alanmimms/nexrig/sim-stuff/filtersim/ChebyshevLP-30MHz-0.5dB-50ohms.ods

Sheet: 0.5dB-ripple
Chebyshev LP 30MHz 50ohm 0.5dB equiripple Pi
RefDes | Precise | Standard
C1 | 185.7 | 180 | pF
C2 | 283.1 | 270 | pF
C3 | 289 | 300 | pF
L1 | 336.6 | 330 | nH
L2 | 362.7 | 360 | nH
SHOPPING CART
This is not an invoice
17-May-25 18:13:14
 | Mouser # | Mfr. # | Manufacturer | Customer # | Description | RoHS | Lifecycle | Order Qty. | Price (USD) | Ext.: (USD)
1 | 81-LQW2UASR33F00L | LQW2UASR33F00L | Murata |  | RF Inductors - SMD 330 NH 1% | RoHS Compliant |  | 10 | $0.309 | $3.09
2 | 791-WLCW2520Z0GR36PB | WLCW2520Z0GR36PB | Walsin |  | RF Inductors - SMD Chip Wire Ind 2520(1008) 360nH +/-2% | RoHS Compliant |  | 10 | $0.134 | $1.34
3 | 581-12061A181FAT2A | 12061A181FAT2A | KYOCERA AVX |  | Multilayer Ceramic Capacitors MLCC - SMD/SMT KGM31BCG2A181FT NEW GLOBAL PN 100V 180pF A 581-KGM31BCG2A181FT | RoHS Compliant |  | 10 | $0.362 | $3.62
4 | 581-12061A271FAT2A | 12061A271FAT2A | KYOCERA AVX |  | Multilayer Ceramic Capacitors MLCC - SMD/SMT KGM31BCG2A271FT NEW GLOBAL PN 100V 270pF A 581-KGM31BCG2A271FT | RoHS Compliant |  | 10 | $0.522 | $5.22
5 | 581-12065A301FAT2A | 12065A301FAT2A | KYOCERA AVX |  | Multilayer Ceramic Capacitors MLCC - SMD/SMT 50V 300pF C0G 1206 1 % | RoHS Compliant |  | 10 | $0.734 | $7.34
By submitting your order you agree to these terms and conditions. (https://www.mouser.com/saleterms) |  |  |  |  |  |  |  |  | Merchandise: | $20.61
Prices are reflected at the date and time shown. |  |  |  |  |  |  |  |  | Shipping Charge: | $7.99

Sheet: 0.1dB-ripple
Chebyshev LP 30MHz 50ohm 0.1dB equiripple Pi
RefDes | Precise | Standard
C1 | 185.7 | 180 | pF
C2 | 283.1 | 270 | pF
C3 | 289 | 300 | pF
L1 | 336.6 | 330 | nH
L2 | 362.7 | 360 | nH
