alanmimms/nexrig/hw/NexRig.kicad_pcb

## KiCad design hw/NexRig.kicad_pcb (2025-12-29)

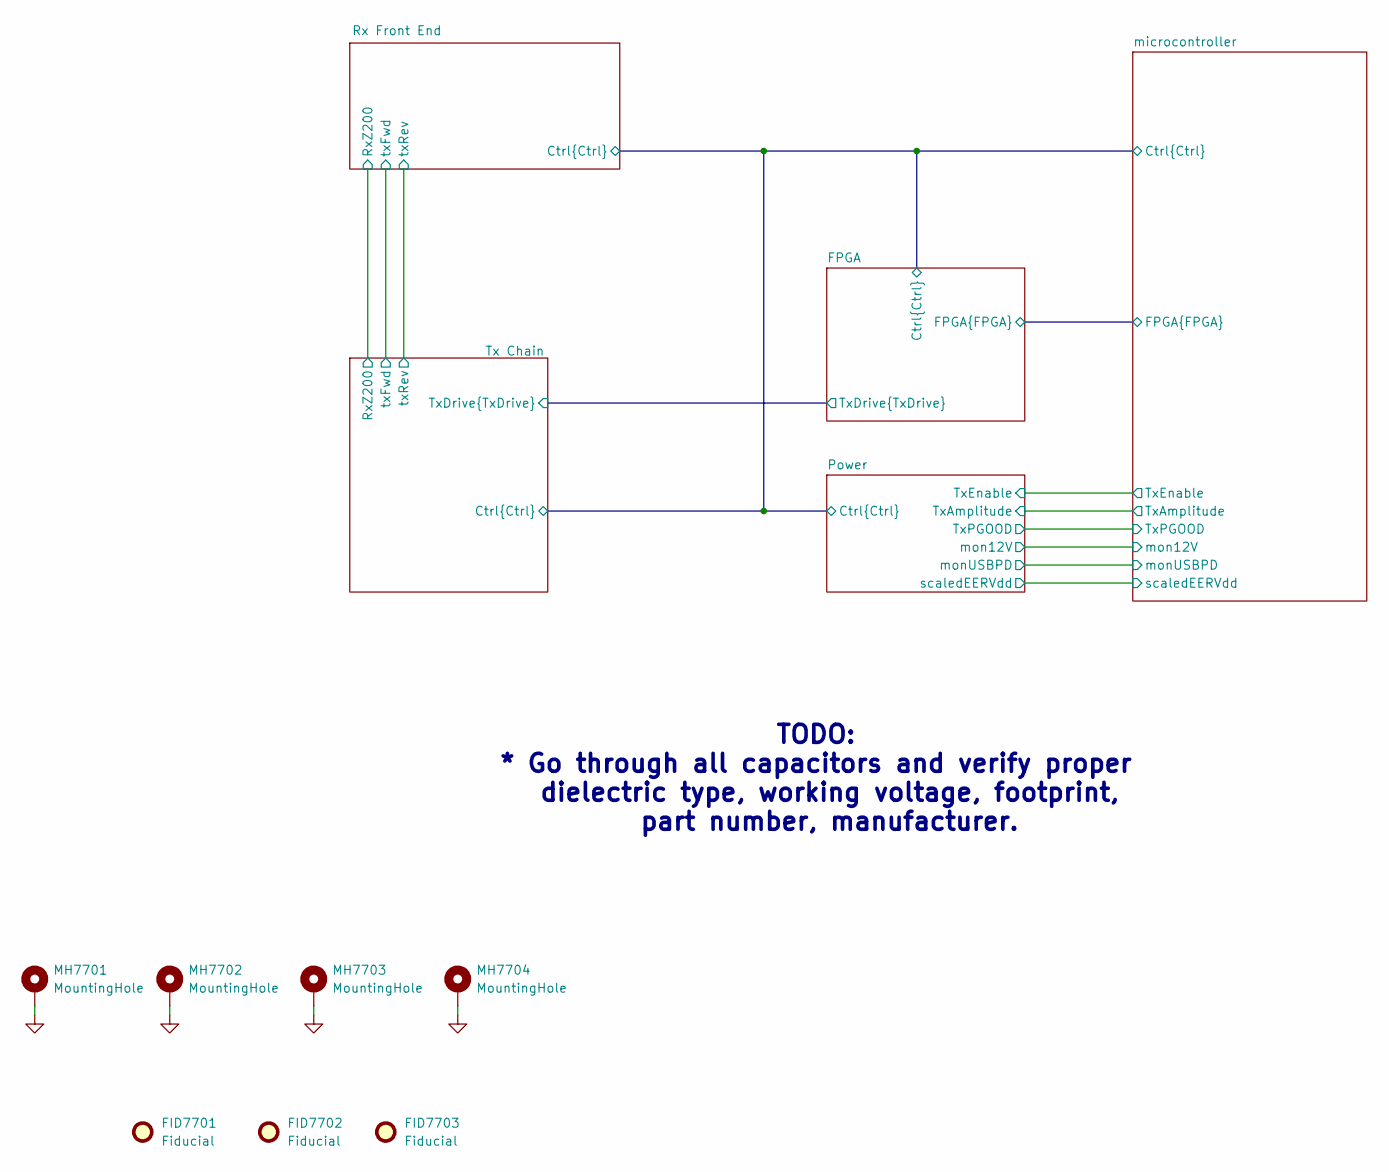
[picture p1: schematic NexRig.kicad_sch]

Parts:
FID7701, FID7702, FID7703: Fiducial; Fiducial_0.5mm_Mask2mm
MH7701, MH7702, MH7703, MH7704: MountingHole; MountingHole_3.2mm_M3_ISO7380_Pad

Notes on the sheet:
TODO: * Go through all capacitors and verify proper dielectric type, working voltage, footprint, part number, manufacturer.

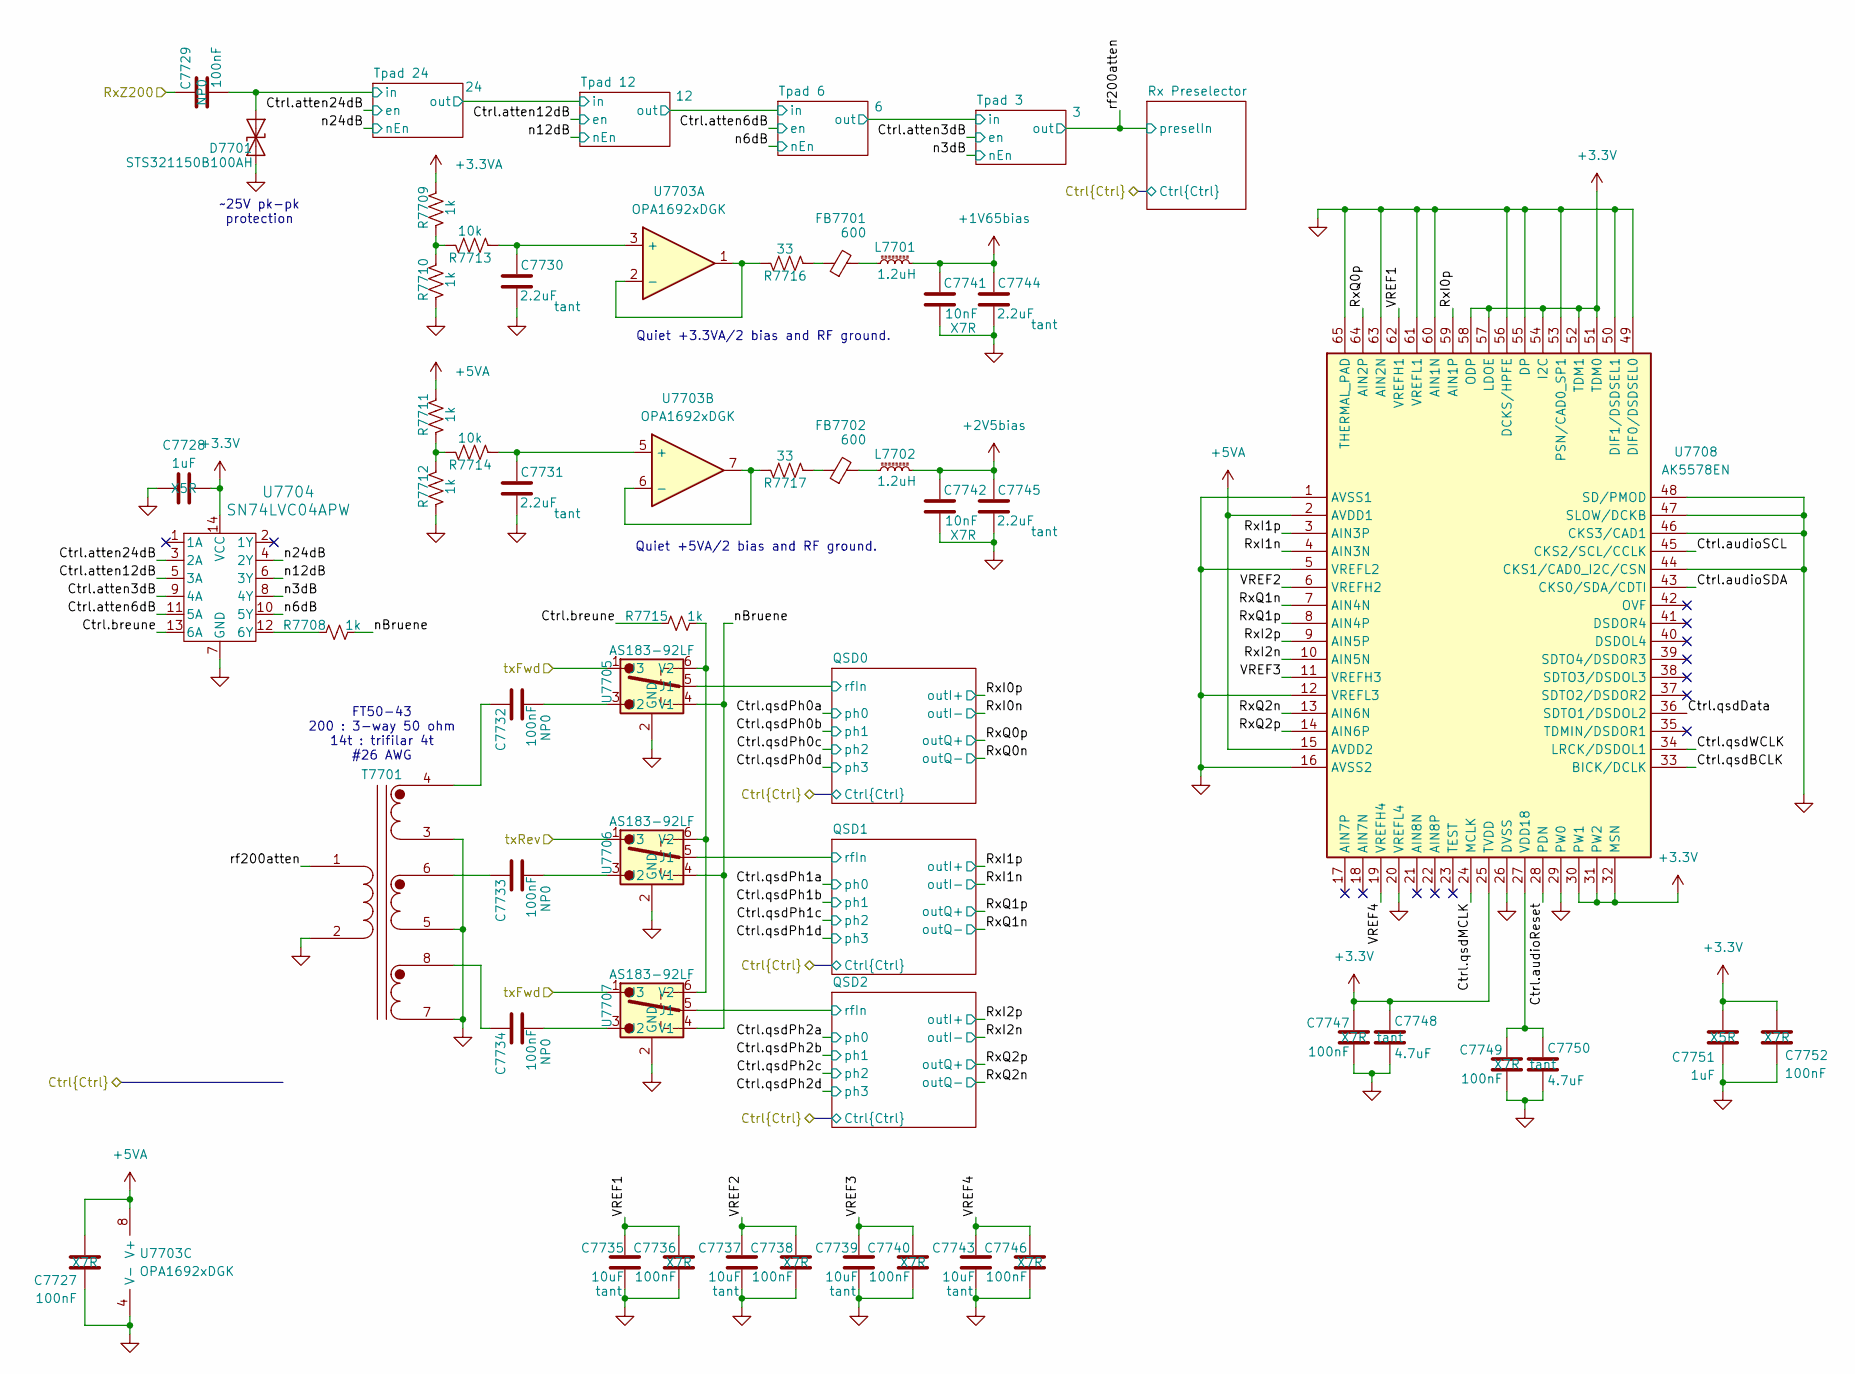
[picture p2: schematic rx-signal-chain.kicad_sch, Rx Front End]

Parts:
C7727, C7736, C7738, C7740, C7746, C7747, C7749, C7752: 100nF; C_0603_1608Metric; Manufacturer_Part_Number C0805F104K1RACAUTO; Mouser Part Number 80-C0805F104K1RAUTO
C7728, C7751: 1uF; C_0402_1005Metric; Manufacturer_Part_Number GRM155R61E105KE11D; Mouser Part Number 81-GRM155R61E105KE1D
C7729, C7732, C7733, C7734: 100nF; C_1206_3216Metric; Manufacturer_Part_Number GRM31C5C2A104JA01L; Mouser Part Number 81-GRM31C5C2A104JA1L
C7730, C7731, C7744, C7745: 2.2uF; C_0805_2012Metric; MfgPart T55B225M050C0200; Mouser Part Number 74-TMCP1D225MTR2F
C7735, C7737, C7739, C7743: 10uF; C_0805_2012Metric; MfgPart TMCP0J106KTR2F; Mouser Part Number 581-TAJD106K050R
C7741, C7742: 10nF; C_0603_1608Metric; Part Number GCM1885C2A103JE02J; Mouser Part Number 81-GCM1885C2A103JE2J
C7748, C7750: 4.7uF; C_0805_2012Metric; Manufacturer_Part_Number 298D475X9010M2T; Mouser Part Number 74-298D475X9010M2T
D7701: STS321150B100AH; Infineon_SG-WLL-2-3_0.58x0.28_P0.36mm
FB7701, FB7702: 600; L_0603_1608Metric; MfgPN BLM18AG601SN1D
L7701, L7702: 1.2uH; L_0805_2012Metric; Part Number CWF2012A-1R2K
R7708, R7715: 1k; R_0402_1005Metric
R7709, R7710, R7711, R7712: 1k; R_0603_1608Metric
R7713, R7714: 10k; R_0402_1005Metric
R7716, R7717: 33; R_0603_1608Metric
T7701: 12t primary : 6T #26 trifilar secondary FT37-43; Toroid-1pri-3sec-ft50
U7703: OPA1692xDGK; VSSOP-8_3x3mm_P0.65mm
U7704: SN74LVC04APW; PW14
U7705, U7706, U7707: AS183-92LF; SOT65P220X110-6N; Mouser Part Number 873-AS183-92LF
U7708: AK5578EN; QFN50P900X900X100-65N; Mouser Part Number 412-AK5578EN

Connections:
+1V65bias: C7741.1, C7744.1, L7701.2; also elsewhere on the board
+2V5bias: C7742.1, C7745.1, L7702.2; also elsewhere on the board
+3.3V: C7728.2, C7747.2, C7748.2, C7751.1, C7752.1, U7704.14 (VCC), U7708.25 (TVDD), U7708.30 (PW1), U7708.31 (PW2), U7708.32 (MSN), U7708.51 (TDM0), U7708.52 (TDM1), U7708.54 (I2C), U7708.57 (LDOE), U7708.58 (ODP); also elsewhere on the board
+3.3VA: R7709.2; also elsewhere on the board
+5VA: C7727.1, R7711.2, U7703.8 (V+), U7708.2 (AVDD1), U7708.15 (AVDD2); also elsewhere on the board
/FPGA/Ctrl.audioReset: U7708.28 (PDN); also elsewhere on the board
/FPGA/Ctrl.audioSCL: U7708.45 (CKS2/SCL/CCLK); also elsewhere on the board
/FPGA/Ctrl.audioSDA: U7708.43 (CKS0/SDA/CDTI); also elsewhere on the board
/FPGA/Ctrl.qsdBCLK: U7708.33 (BICK/DCLK); also elsewhere on the board
/FPGA/Ctrl.qsdData: U7708.36 (SDTO1/DSDOL2); also elsewhere on the board
/FPGA/Ctrl.qsdMCLK: U7708.24 (MCLK)
/FPGA/Ctrl.qsdWCLK: U7708.34 (LRCK/DSDOL1); also elsewhere on the board
/Rx Front End/Ctrl.atten3dB: U7704.9 (4A); also elsewhere on the board
/Rx Front End/Ctrl.atten6dB: U7704.11 (5A); also elsewhere on the board
/Rx Front End/Ctrl.atten12dB: U7704.5 (3A); also elsewhere on the board
/Rx Front End/Ctrl.atten24dB: U7704.3 (2A); also elsewhere on the board
/Rx Front End/Ctrl.breune: R7715.1, U7704.13 (6A)
/Rx Front End/QSD0/rfIn: U7705.5 (J1); also elsewhere on the board
/Rx Front End/QSD1/rfIn: U7706.5 (J1); also elsewhere on the board
/Rx Front End/QSD2/rfIn: U7707.5 (J1); also elsewhere on the board
/Rx Front End/RxI0p: U7708.59 (AIN1P); also elsewhere on the board
/Rx Front End/RxI1n: U7708.4 (AIN3N); also elsewhere on the board
/Rx Front End/RxI1p: U7708.3 (AIN3P); also elsewhere on the board
/Rx Front End/RxI2n: U7708.10 (AIN5N); also elsewhere on the board
/Rx Front End/RxI2p: U7708.9 (AIN5P); also elsewhere on the board
/Rx Front End/RxQ0p: U7708.64 (AIN2P); also elsewhere on the board
/Rx Front End/RxQ1n: U7708.7 (AIN4N); also elsewhere on the board
/Rx Front End/RxQ1p: U7708.8 (AIN4P); also elsewhere on the board
/Rx Front End/RxQ2n: U7708.13 (AIN6N); also elsewhere on the board
/Rx Front End/RxQ2p: U7708.14 (AIN6P); also elsewhere on the board
/Rx Front End/RxZ200: C7729.1; also elsewhere on the board
/Rx Front End/Tpad 24/in: C7729.2, D7701.1 (A1); also elsewhere on the board
/Rx Front End/VREF1: C7735.1, C7736.1, U7708.62 (VREFH1)
/Rx Front End/VREF2: C7737.1, C7738.1, U7708.6 (VREFH2)
/Rx Front End/VREF3: C7739.1, C7740.1, U7708.11 (VREFH3)
/Rx Front End/VREF4: C7743.1, C7746.1, U7708.19 (VREFH4)
/Rx Front End/n3dB: U7704.8 (4Y); also elsewhere on the board
/Rx Front End/n6dB: U7704.10 (5Y); also elsewhere on the board
/Rx Front End/n12dB: U7704.6 (3Y); also elsewhere on the board
/Rx Front End/n24dB: U7704.4 (2Y); also elsewhere on the board
/Rx Front End/nBruene: R7708.2, U7705.4 (V1), U7706.4 (V1), U7707.4 (V1)
/Rx Front End/rf200atten: T7701.1 (IN+); also elsewhere on the board
/Rx Front End/txFwd: U7705.1 (J3), U7707.1 (J3); also elsewhere on the board
/Rx Front End/txRev: U7706.1 (J3); also elsewhere on the board
unnamed: C7733.1, T7701.6 (OUT2A)
unnamed: C7734.1, T7701.8 (OUT2A)
unnamed: FB7701.1, R7716.1
unnamed: FB7701.2, L7701.1
unnamed: FB7702.1, R7717.1
unnamed: FB7702.2, L7702.1
unnamed: R7709.1, R7710.2, R7713.2
unnamed: R7711.1, R7712.2, R7714.2
unnamed: C7732.1, T7701.4 (OUT1A)
unnamed: C7730.1, R7713.1, U7703.3 (+)
unnamed: R7716.2, U7703.1, U7703.2 (-)
unnamed: C7731.1, R7714.1, U7703.5 (+)
unnamed: R7717.2, U7703.6 (-), U7703.7
unnamed: R7708.1, U7704.12 (6Y)
unnamed: C7732.2, U7705.3 (J2)
unnamed: R7715.2, U7705.6 (V2), U7706.6 (V2), U7707.6 (V2)
unnamed: C7733.2, U7706.3 (J2)
unnamed: C7734.2, U7707.3 (J2)
unnamed: C7749.2, C7750.2, U7708.27 (VDD18)

Notes on the sheet:
~25V pk-pk protection
Quiet +3.3VA/2 bias and RF ground.
FT50-43 200 : 3-way 50 ohm 14t : trifilar 4t #26 AWG
Quiet +5VA/2 bias and RF ground.

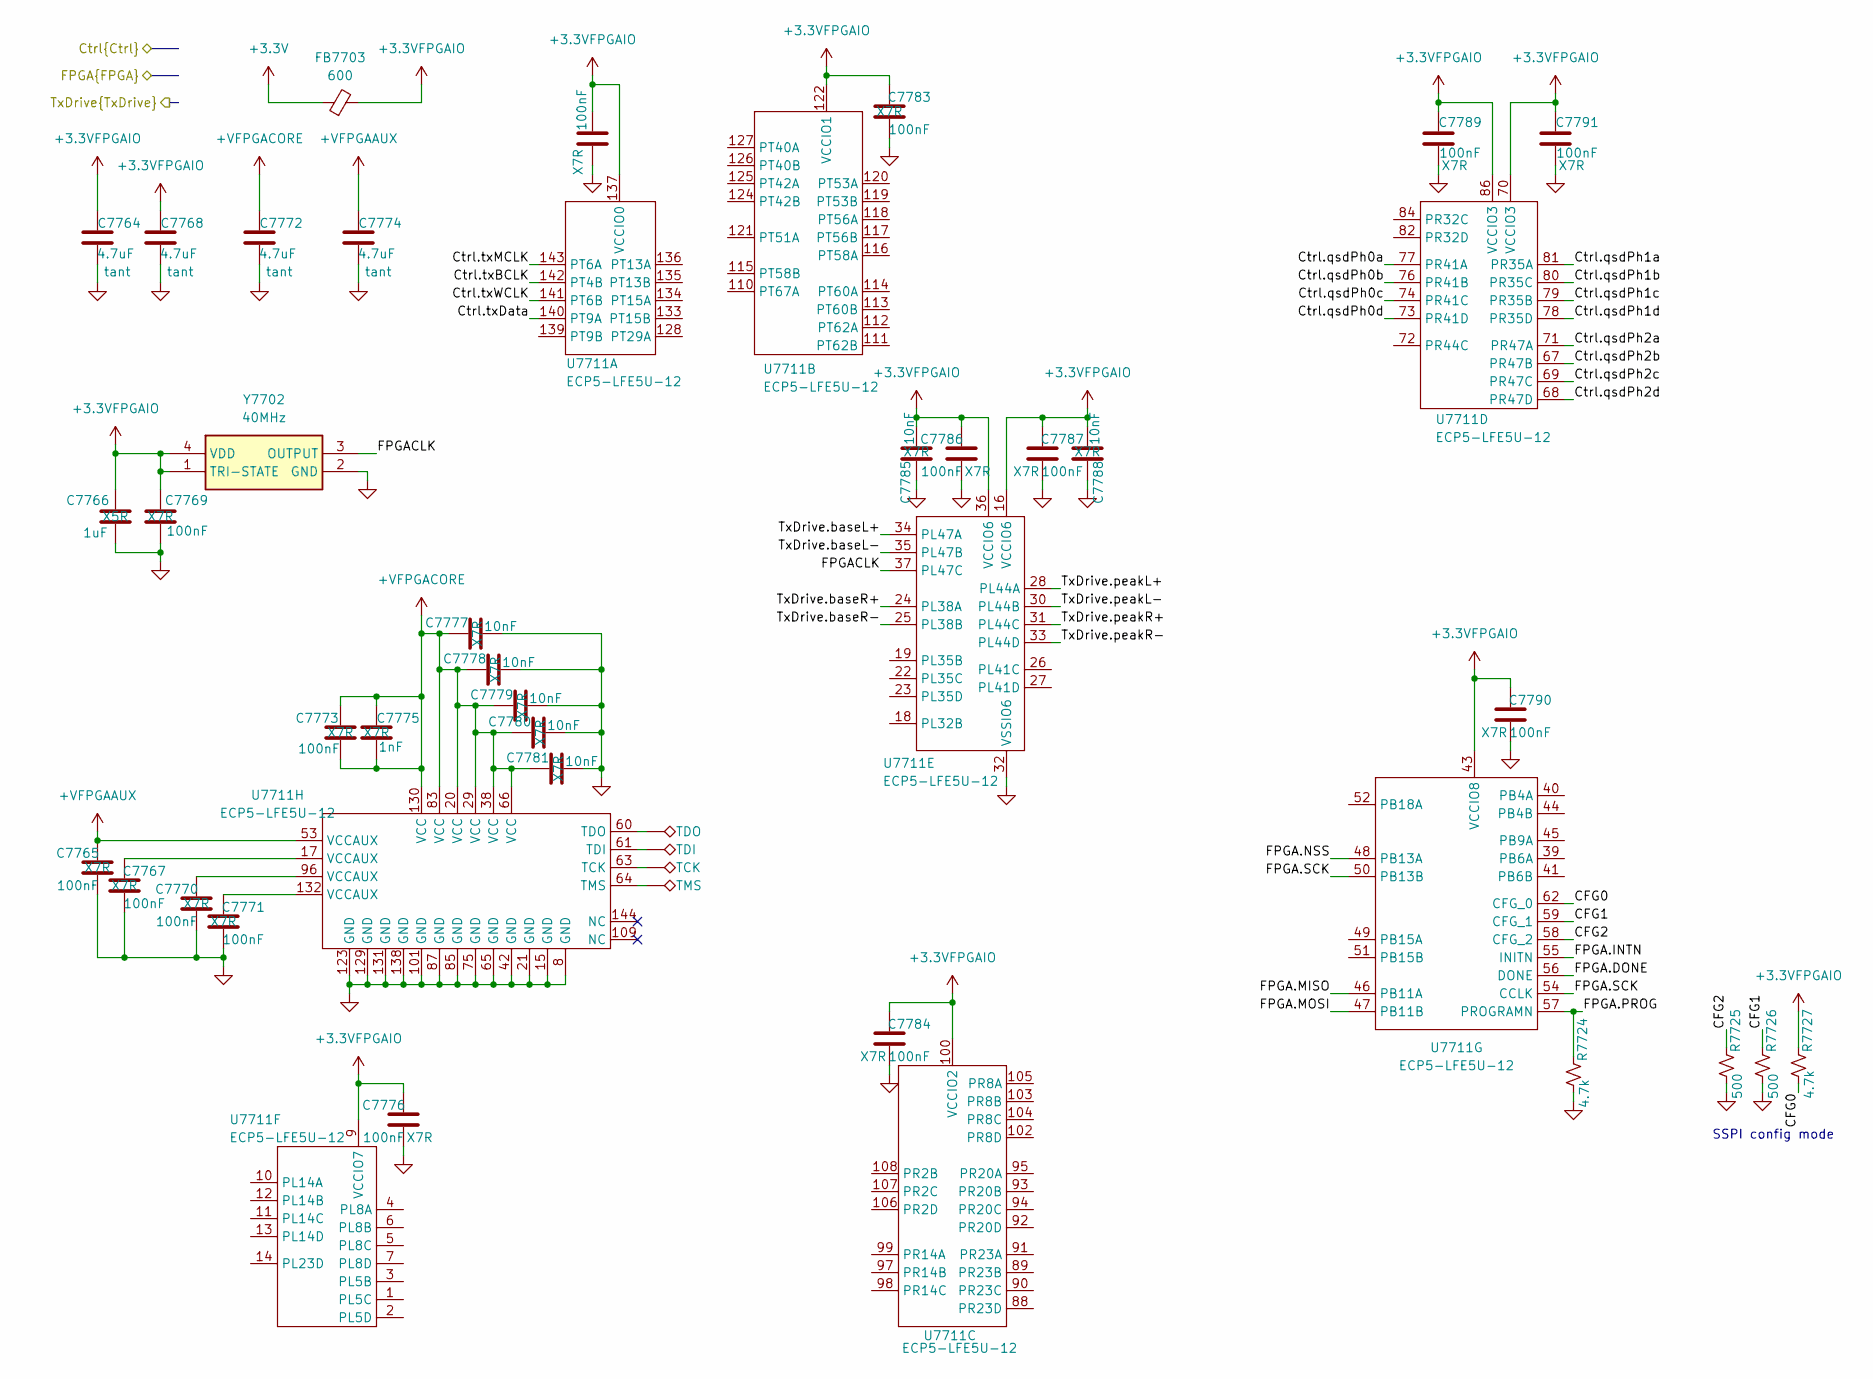
[picture p3: schematic fpga.kicad_sch]

Parts:
C7764, C7768, C7772, C7774: 4.7uF; C_0805_2012Metric; Manufacturer_Part_Number 298D475X9010M2T; Mouser Part Number 74-298D475X9010M2T
C7765, C7767, C7769, C7770, C7771, C7773, C7776, C7782, C7783, C7784, C7786, C7787, C7789, C7790, C7791: 100nF; C_0603_1608Metric; Manufacturer_Part_Number C0805F104K1RACAUTO; Mouser Part Number 80-C0805F104K1RAUTO
C7766: 1uF; C_0402_1005Metric; Manufacturer_Part_Number GRM155R61E105KE11D; Mouser Part Number 81-GRM155R61E105KE1D
C7775: 1nF; C_0603_1608Metric; Manufacturer_Part_Number KAF15AR71H102KM; Mouser Part Number 581-KAF15AR71H102KM
C7777, C7778, C7779, C7780, C7781, C7785, C7788: 10nF; C_0603_1608Metric; Manufacturer_Part_Number GCM1885C2A103JE02J; Mouser Part Number 81-GCM1885C2A103JE2J
FB7703: 600; L_0603_1608Metric
PG7709: TDO; TestPoint_Pad_1.0x1.0mm
PG7710: TDI; TestPoint_Pad_1.0x1.0mm
PG7711: TCK; TestPoint_Pad_1.0x1.0mm
PG7712: TMS; TestPoint_Pad_1.0x1.0mm
R7724, R7727: 4.7k; R_0603_1608Metric
R7725, R7726: 500; R_0603_1608Metric
U7711: ECP5-LFE5U-12; TQFP-144_20x20mm_P0.5mm
Y7702: 40MHz; ECSTXO201633400TR; Mouser Part Number 520-TXO-2016-33-400T

Connections:
+3.3V: FB7703.1; also elsewhere on the board
+3.3VFPGAIO: C7764.1, C7766.1, C7768.1, C7769.1, C7776.1, C7782.1, C7783.1, C7784.1, C7785.1, C7786.1, C7787.1, C7788.1, C7789.1, C7790.1, C7791.1, FB7703.2, R7727.1, U7711.9 (VCCIO7), U7711.16 (VCCIO6), U7711.36 (VCCIO6), U7711.43 (VCCIO8), U7711.70 (VCCIO3), U7711.86 (VCCIO3), U7711.100 (VCCIO2), U7711.122 (VCCIO1), U7711.137 (VCCIO0), Y7702.1 (TRI-STATE), Y7702.4 (VDD)
+VFPGAAUX: C7765.1, C7774.1, U7711.53 (VCCAUX); also elsewhere on the board
+VFPGACORE: C7772.1, C7773.1, C7773.2, C7775.1, C7775.2, C7777.2, C7778.2, C7779.2, C7780.2, C7781.2, U7711.20 (VCC), U7711.29 (VCC), U7711.38 (VCC), U7711.66 (VCC), U7711.83 (VCC), U7711.130 (VCC); also elsewhere on the board
/FPGA/CFG0: R7727.2, U7711.62 (CFG_0)
/FPGA/CFG1: R7726.1, U7711.59 (CFG_1)
/FPGA/CFG2: R7725.1, U7711.58 (CFG_2)
/FPGA/Ctrl.qsdPh0a: U7711.77 (PR41A); also elsewhere on the board
/FPGA/Ctrl.qsdPh0b: U7711.76 (PR41B); also elsewhere on the board
/FPGA/Ctrl.qsdPh0c: U7711.74 (PR41C); also elsewhere on the board
/FPGA/Ctrl.qsdPh0d: U7711.73 (PR41D); also elsewhere on the board
/FPGA/Ctrl.qsdPh1a: U7711.81 (PR35A); also elsewhere on the board
/FPGA/Ctrl.qsdPh1b: U7711.80 (PR35C); also elsewhere on the board
/FPGA/Ctrl.qsdPh1c: U7711.79 (PR35B); also elsewhere on the board
/FPGA/Ctrl.qsdPh1d: U7711.78 (PR35D); also elsewhere on the board
/FPGA/Ctrl.qsdPh2a: U7711.71 (PR47A); also elsewhere on the board
/FPGA/Ctrl.qsdPh2b: U7711.67 (PR47B); also elsewhere on the board
/FPGA/Ctrl.qsdPh2c: U7711.69 (PR47C); also elsewhere on the board
/FPGA/Ctrl.qsdPh2d: U7711.68 (PR47D); also elsewhere on the board
/FPGA/Ctrl.txBCLK: U7711.142 (PT4B); also elsewhere on the board
/FPGA/Ctrl.txData: U7711.140 (PT9A); also elsewhere on the board
/FPGA/Ctrl.txMCLK: U7711.143 (PT6A); also elsewhere on the board
/FPGA/Ctrl.txWCLK: U7711.141 (PT6B); also elsewhere on the board
/FPGA/FPGA.DONE: U7711.56 (DONE); also elsewhere on the board
/FPGA/FPGA.INTN: U7711.55 (INITN); also elsewhere on the board
/FPGA/FPGA.MISO: U7711.46 (PB11A); also elsewhere on the board
/FPGA/FPGA.MOSI: U7711.47 (PB11B); also elsewhere on the board
/FPGA/FPGA.NSS: U7711.48 (PB13A); also elsewhere on the board
/FPGA/FPGA.PROG: R7724.1, U7711.57 (PROGRAMN); also elsewhere on the board
/FPGA/FPGA.SCK: U7711.50 (PB13B), U7711.54 (CCLK); also elsewhere on the board
/FPGA/FPGACLK: U7711.37 (PL47C), Y7702.3 (OUTPUT)
/FPGA/TxDrive.baseL+: U7711.34 (PL47A); also elsewhere on the board
/FPGA/TxDrive.baseL-: U7711.35 (PL47B); also elsewhere on the board
/FPGA/TxDrive.baseR+: U7711.24 (PL38A); also elsewhere on the board
/FPGA/TxDrive.baseR-: U7711.25 (PL38B); also elsewhere on the board
/FPGA/TxDrive.peakL+: U7711.28 (PL44A); also elsewhere on the board
/FPGA/TxDrive.peakL-: U7711.30 (PL44B); also elsewhere on the board
/FPGA/TxDrive.peakR+: U7711.31 (PL44C); also elsewhere on the board
/FPGA/TxDrive.peakR-: U7711.33 (PL44D); also elsewhere on the board
unnamed: C7767.1, U7711.17 (VCCAUX)
unnamed: C7770.1, U7711.96 (VCCAUX)
unnamed: C7771.1, U7711.132 (VCCAUX)
unnamed: PG7711.1, U7711.63 (TCK)
unnamed: PG7710.1, U7711.61 (TDI)
unnamed: PG7709.1, U7711.60 (TDO)
unnamed: PG7712.1, U7711.64 (TMS)

Notes on the sheet:
SSPI config mode

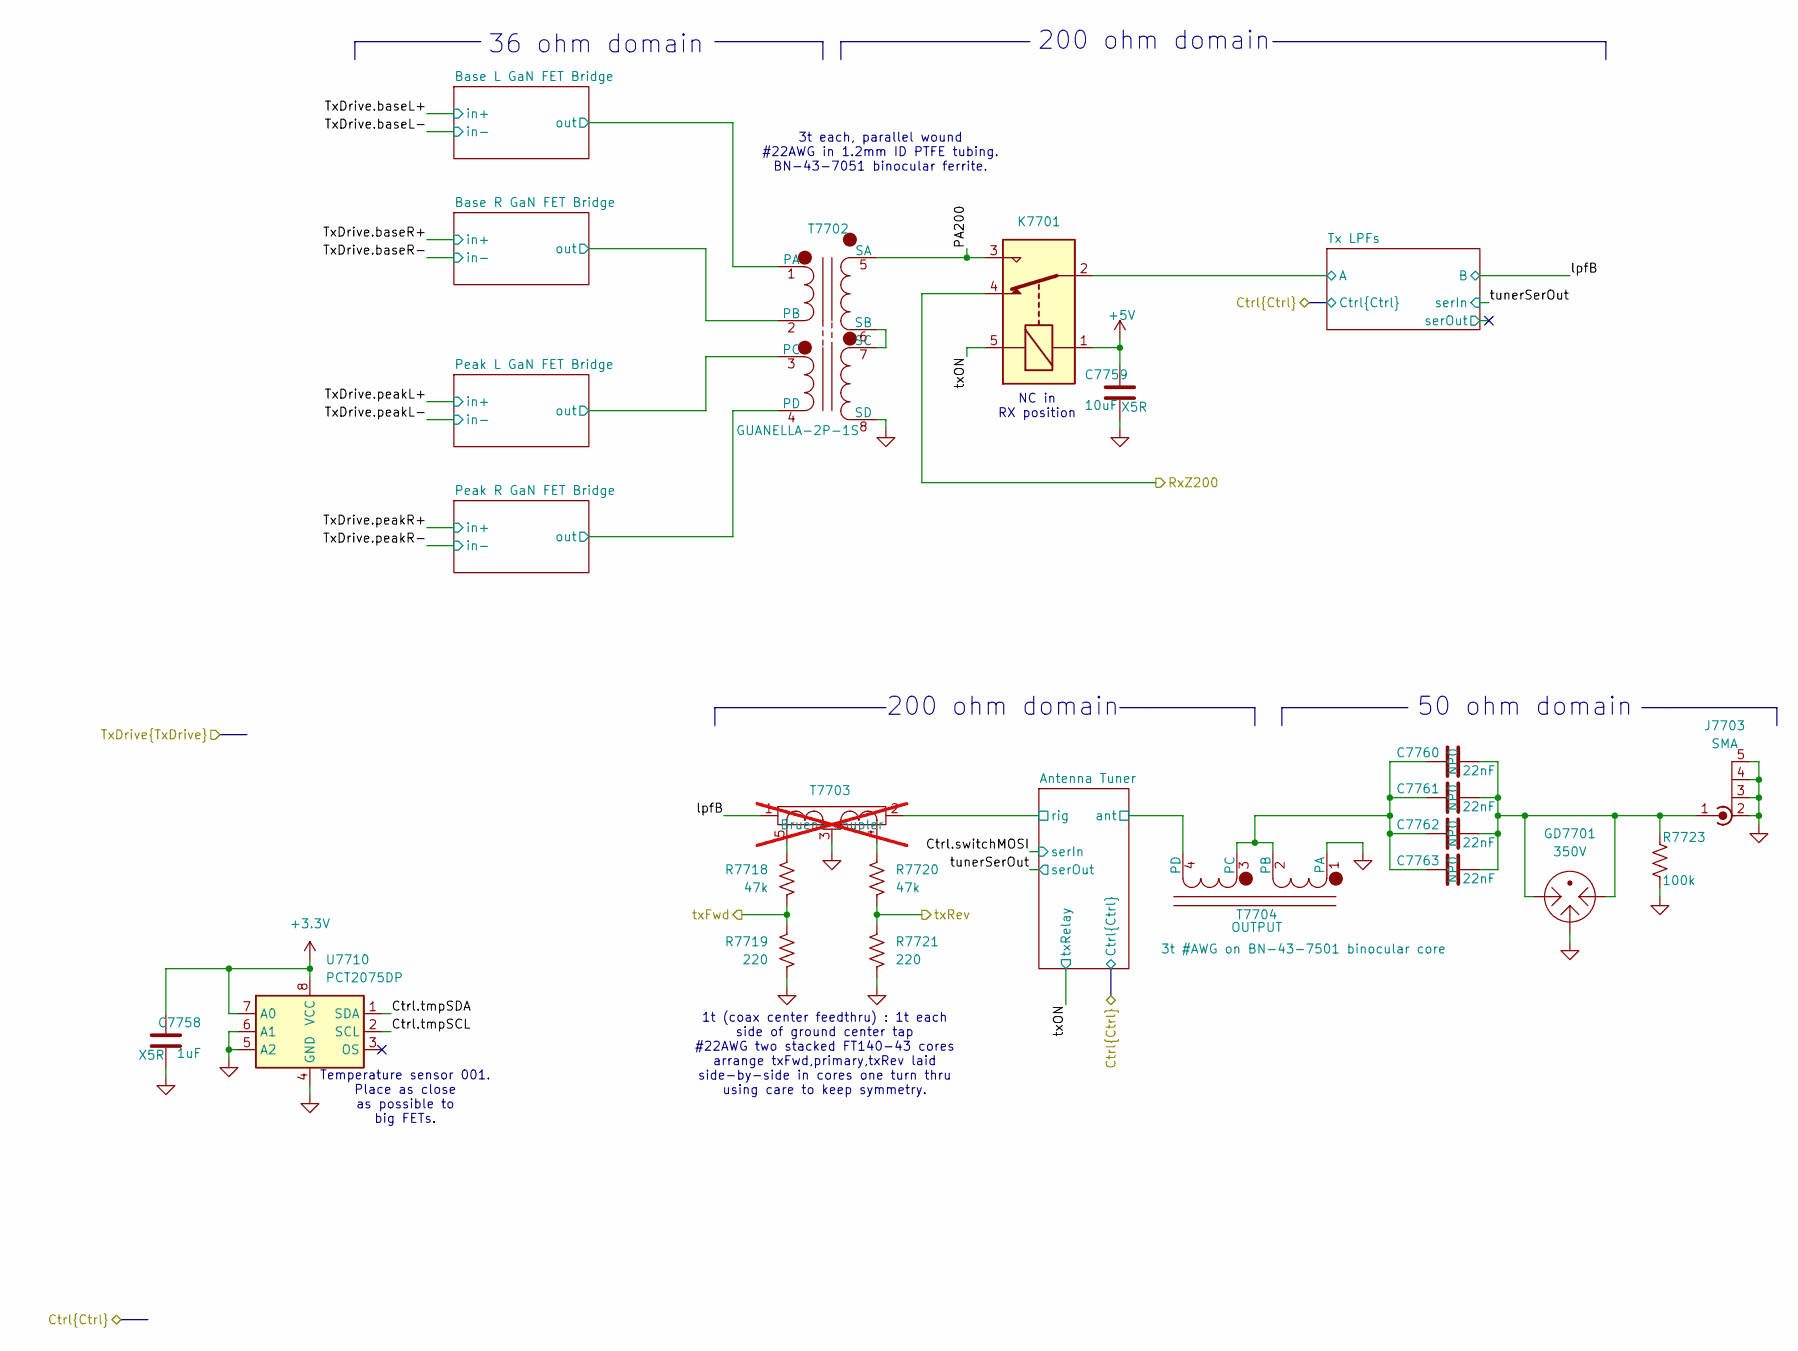
[picture p4: schematic tx-signal-chain.kicad_sch, ${title}]

Parts:
C7758: 1uF; C_0402_1005Metric; Manufacturer_Part_Number GRM155R61E105KE11D; Mouser Part Number 81-GRM155R61E105KE1D
C7759: 10uF; C_0603_1608Metric; Manufacturer_Part_Number 81-GXT155R71E223KE1D; Mouser Part Number 963-MLAST168BB5106MT
C7760, C7761, C7762, C7763: 22nF; C_1206_3216Metric; Manufacturer_Part_Number CC1210JKNPOCBN223; Mouser Part Number 603-CC121JKNPOCBN223
GD7701: 350V; GDT3535S1RP; Manufacturer_Part_Number GDT35-35-S1-RP; Mouser Part Number 652-GDT35-35-S1-RP
J7703: SMA; RFPCSMA27F
K7701: G5Q-14-05; Relay_SPDT_Omron-G5Q-1
R7718, R7720: 47k; R_0603_1608Metric; Manufacturer_Part_Number MCT06030C4702FP500; Mouser Part Number 594-MCT06030C4702FP5
R7719, R7721: 220; R_0603_1608Metric; Manufacturer_Part_Number MCT06030C2200FP500; Mouser Part Number 594-MCT06030C2200FP5
R7723: 100k; R_1206_3216Metric; Manufacturer_Part_Number ERJ-P08J104V; Mouser Part Number 667-ERJ-P08J104V
T7702: GUANELLA-2P-1S; Guanella-2P-2S
T7703: Bruene coupler; BN-43-7051-1P-1S-CT; not fitted
T7704: OUTPUT; Guanella-1P-1S
U7710: PCT2075DP; TSSOP-8_3x3mm_P0.65mm

Connections:
+3.3V: C7758.1, U7710.7 (A0), U7710.8 (VCC); also elsewhere on the board
/FPGA/Ctrl.tmpSCL: U7710.2 (SCL); also elsewhere on the board
/FPGA/Ctrl.tmpSDA: U7710.1 (SDA); also elsewhere on the board
/Rx Front End/txFwd: R7718.2, R7719.1; also elsewhere on the board
/Rx Front End/txRev: R7720.2, R7721.1; also elsewhere on the board
/Tx Chain/Antenna Tuner/rig: T7703.2; also elsewhere on the board
/Tx Chain/Base L GaN FET Bridge/out: T7702.1 (PA); also elsewhere on the board
/Tx Chain/Base R GaN FET Bridge/out: T7702.2 (PB); also elsewhere on the board
/Tx Chain/Peak L GaN FET Bridge/out: T7702.3 (PC); also elsewhere on the board
/Tx Chain/Peak R GaN FET Bridge/out: T7702.4 (PD); also elsewhere on the board
/Tx Chain/lpfB: T7703.1; also elsewhere on the board
/Tx Chain/txON: K7701.5; also elsewhere on the board
unnamed: C7760.2, C7761.2, C7762.2, C7763.2, GD7701.1, GD7701.3, J7703.1 (In), R7723.1
unnamed 312: K7701.4; also elsewhere on the board
unnamed: R7718.1, T7703.5
unnamed: R7720.1, T7703.4
unnamed: T7702.6 (SB), T7702.7 (SC)
unnamed: C7760.1, C7761.1, C7762.1, C7763.1, T7704.2 (PB), T7704.3 (PC)

Notes on the sheet:
50 ohm domain
1t (coax center feedthru) : 1t each side of ground center tap #22AWG two stacked FT140-43 cores arrange txFwd,primary,txRev laid side-by-side in cores one turn thru using care to keep symmetry.
3t each, parallel wound #22AWG in 1.2mm ID PTFE tubing. BN-43-7051 binocular ferrite.
36 ohm domain
200 ohm domain
NC in RX position
Temperature sensor 001. Place as close as possible to big FETs.
