alanmimms/nexrig/hw/NexRig.kicad_pcb

## KiCad design hw/NexRig.kicad_pcb (continued)

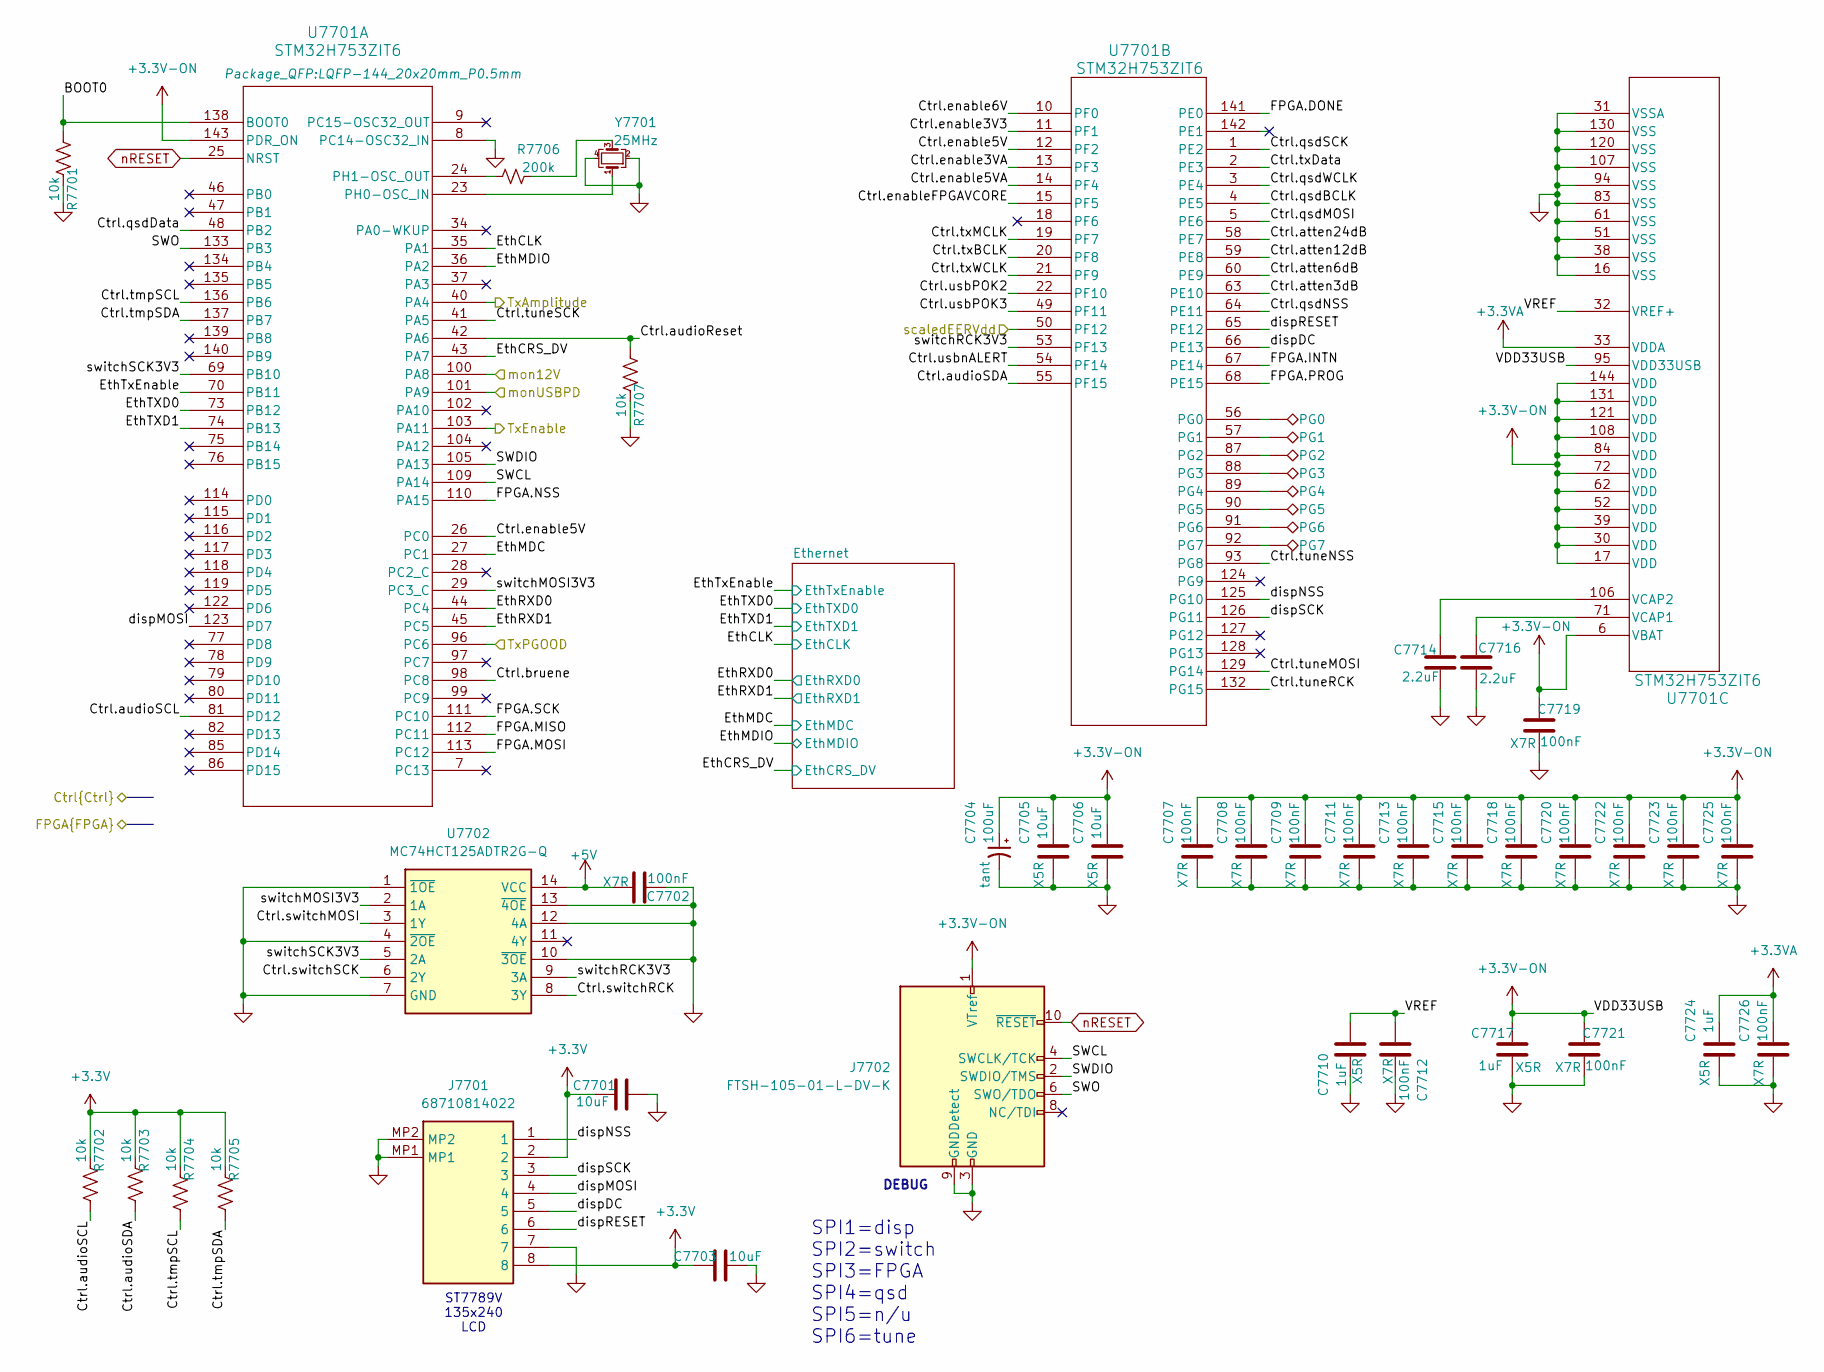
[picture p5: schematic microcontroller.kicad_sch]

Parts:
C7701, C7703, C7705, C7706: 10uF; C_0603_1608Metric; Manufacturer_Part_Number 81-GXT155R71E223KE1D; Mouser Part Number 963-MLAST168BB5106MT
C7702, C7707, C7708, C7709, C7711, C7712, C7713, C7715, C7718, C7719, C7720, C7721, C7722, C7723, C7725, C7726: 100nF; C_0603_1608Metric; Manufacturer_Part_Number C0805F104K1RACAUTO; Mouser Part Number 80-C0805F104K1RAUTO
C7704: 100uF; C_1206_3216Metric; Manufacturer_Part_Number TCTAL1A107M8R-V1; Mouser Part Number 755-TCTAL1A107M8R-V1
C7710, C7717, C7724: 1uF; C_0402_1005Metric; Manufacturer_Part_Number GRM155R61E105KE11D; Mouser Part Number 81-GRM155R61E105KE1D
C7714, C7716: 2.2uF; C_0805_2012Metric; Manufacturer_Part_Number TMCP1D225MTR2F; Mouser Part Number 74-TMCP1D225MTR2F
J7701: 68710814022; Mouser Part Number 710-68710814022
J7702: FTSH-105-01-L-DV-K; FTSH10501LDVK
PG7701: PG0; TestPoint_Pad_1.0x1.0mm
PG7702: PG1; TestPoint_Pad_1.0x1.0mm
PG7703: PG2; TestPoint_Pad_1.0x1.0mm
PG7704: PG3; TestPoint_Pad_1.0x1.0mm
PG7705: PG4; TestPoint_Pad_1.0x1.0mm
PG7706: PG5; TestPoint_Pad_1.0x1.0mm
PG7707: PG6; TestPoint_Pad_1.0x1.0mm
PG7708: PG7; TestPoint_Pad_1.0x1.0mm
R7701, R7702, R7703, R7704, R7705, R7707: 10k; R_0402_1005Metric
R7706: 200k; R_0603_1608Metric
U7701: STM32H753ZIT6; LQFP-144_20x20mm_P0.5mm
U7702: MC74HCT125ADTR2G-Q; SOP65P640X110-14N; Mouser Part Number 771-74HCT125PW-T
Y7701: 25MHz; Crystal_SMD_2520-4Pin_2.5x2.0mm; Manufacturer_Part_Number E2X250081G10; Mouser Part Number 504-E2X250081G10

Connections:
+3.3V: C7701.1, C7703.1, J7701.2, J7701.8, R7702.1, R7703.1, R7704.1, R7705.1; also elsewhere on the board
+3.3V-ON: C7704.1, C7705.1, C7706.1, C7707.1, C7708.1, C7709.1, C7711.1, C7713.1, C7715.1, C7717.1, C7718.1, C7719.1, C7720.1, C7721.1, C7722.1, C7723.1, C7725.1, J7702.1 (VTref), U7701.6 (VBAT), U7701.17 (VDD), U7701.30 (VDD), U7701.39 (VDD), U7701.52 (VDD), U7701.62 (VDD), U7701.72 (VDD), U7701.84 (VDD), U7701.95 (VDD33USB), U7701.108 (VDD), U7701.121 (VDD), U7701.131 (VDD), U7701.143 (PDR_ON), U7701.144 (VDD); also elsewhere on the board
+3.3VA: C7724.1, C7726.1, U7701.33 (VDDA); also elsewhere on the board
/FPGA/Ctrl.audioReset: R7707.1, U7701.42 (PA6); also elsewhere on the board
/FPGA/Ctrl.audioSCL: R7702.2, U7701.81 (PD12); also elsewhere on the board
/FPGA/Ctrl.audioSDA: R7703.2, U7701.55 (PF15); also elsewhere on the board
/FPGA/Ctrl.bruene: U7701.98 (PC8)
/FPGA/Ctrl.enable3V3: U7701.11 (PF1); also elsewhere on the board
/FPGA/Ctrl.enable3VA: U7701.13 (PF3); also elsewhere on the board
/FPGA/Ctrl.enable5V: U7701.12 (PF2), U7701.26 (PC0); also elsewhere on the board
/FPGA/Ctrl.enable5VA: U7701.14 (PF4); also elsewhere on the board
/FPGA/Ctrl.enable6V: U7701.10 (PF0); also elsewhere on the board
/FPGA/Ctrl.enableFPGAVCORE: U7701.15 (PF5)
/FPGA/Ctrl.qsdBCLK: U7701.4 (PE5); also elsewhere on the board
/FPGA/Ctrl.qsdData: U7701.48 (PB2); also elsewhere on the board
/FPGA/Ctrl.qsdMOSI: U7701.5 (PE6); also elsewhere on the board
/FPGA/Ctrl.qsdNSS: U7701.64 (PE11); also elsewhere on the board
/FPGA/Ctrl.qsdSCK: U7701.1 (PE2); also elsewhere on the board
/FPGA/Ctrl.qsdWCLK: U7701.3 (PE4); also elsewhere on the board
/FPGA/Ctrl.switchMOSI: U7702.3 (1Y); also elsewhere on the board
/FPGA/Ctrl.switchRCK: U7702.8 (3Y); also elsewhere on the board
/FPGA/Ctrl.switchSCK: U7702.6 (2Y); also elsewhere on the board
/FPGA/Ctrl.tmpSCL: R7704.2, U7701.136 (PB6); also elsewhere on the board
/FPGA/Ctrl.tmpSDA: R7705.2, U7701.137 (PB7); also elsewhere on the board
/FPGA/Ctrl.txBCLK: U7701.20 (PF8); also elsewhere on the board
/FPGA/Ctrl.txData: U7701.2 (PE3); also elsewhere on the board
/FPGA/Ctrl.txMCLK: U7701.19 (PF7); also elsewhere on the board
/FPGA/Ctrl.txWCLK: U7701.21 (PF9); also elsewhere on the board
/FPGA/Ctrl.usbPOK2: U7701.22 (PF10); also elsewhere on the board
/FPGA/Ctrl.usbPOK3: U7701.49 (PF11); also elsewhere on the board
/FPGA/Ctrl.usbnALERT: U7701.54 (PF14); also elsewhere on the board
/FPGA/FPGA.DONE: U7701.141 (PE0); also elsewhere on the board
/FPGA/FPGA.INTN: U7701.67 (PE14); also elsewhere on the board
/FPGA/FPGA.MISO: U7701.112 (PC11); also elsewhere on the board
/FPGA/FPGA.MOSI: U7701.113 (PC12); also elsewhere on the board
/FPGA/FPGA.NSS: U7701.110 (PA15); also elsewhere on the board
/FPGA/FPGA.PROG: U7701.68 (PE15); also elsewhere on the board
/FPGA/FPGA.SCK: U7701.111 (PC10); also elsewhere on the board
/Power/TxAmplitude: U7701.40 (PA4); also elsewhere on the board
/Power/TxEnable: U7701.103 (PA11); also elsewhere on the board
/Power/TxPGOOD: U7701.96 (PC6); also elsewhere on the board
/Power/mon12V: U7701.100 (PA8); also elsewhere on the board
/Power/monUSBPD: U7701.101 (PA9); also elsewhere on the board
/Power/scaledEERVdd: U7701.50 (PF12); also elsewhere on the board
/microcontroller/BOOT0: R7701.1, U7701.138 (BOOT0)
/microcontroller/Ctrl.atten3dB: U7701.63 (PE10)
/microcontroller/Ctrl.atten6dB: U7701.60 (PE9)
/microcontroller/Ctrl.atten12dB: U7701.59 (PE8)
/microcontroller/Ctrl.atten24dB: U7701.58 (PE7)
/microcontroller/Ctrl.tuneMOSI: U7701.129 (PG14)
/microcontroller/Ctrl.tuneNSS: U7701.93 (PG8)
/microcontroller/Ctrl.tuneRCK: U7701.132 (PG15)
/microcontroller/Ctrl.tuneSCK: U7701.41 (PA5)
/microcontroller/EthCLK: U7701.35 (PA1); also elsewhere on the board
/microcontroller/EthCRS_DV: U7701.43 (PA7); also elsewhere on the board
/microcontroller/EthMDC: U7701.27 (PC1); also elsewhere on the board
/microcontroller/EthMDIO: U7701.36 (PA2); also elsewhere on the board
/microcontroller/EthRXD0: U7701.44 (PC4); also elsewhere on the board
/microcontroller/EthRXD1: U7701.45 (PC5); also elsewhere on the board
/microcontroller/EthTXD0: U7701.73 (PB12); also elsewhere on the board
/microcontroller/EthTXD1: U7701.74 (PB13); also elsewhere on the board
/microcontroller/EthTxEnable: U7701.70 (PB11); also elsewhere on the board
/microcontroller/SWCL: J7702.4 (SWCLK/TCK), U7701.109 (PA14)
/microcontroller/SWDIO: J7702.2 (SWDIO/TMS), U7701.105 (PA13)
/microcontroller/SWO: J7702.6 (SWO/TDO), U7701.133 (PB3)
/microcontroller/VREF: C7710.1, C7712.1, U7701.32 (VREF+)
/microcontroller/dispDC: J7701.5, U7701.66 (PE13)
/microcontroller/dispMOSI: J7701.4, U7701.123 (PD7)
/microcontroller/dispNSS: J7701.1, U7701.125 (PG10)
/microcontroller/dispRESET: J7701.6, U7701.65 (PE12)
/microcontroller/dispSCK: J7701.3, U7701.126 (PG11)
/microcontroller/switchMOSI3V3: U7701.29 (PC3_C), U7702.2 (1A)
/microcontroller/switchRCK3V3: U7701.53 (PF13), U7702.9 (3A)
/microcontroller/switchSCK3V3: U7701.69 (PB10), U7702.5 (2A)
unnamed: R7706.2, Y7701.3
unnamed: U7701.23 (PH0-OSC_IN), Y7701.1
unnamed: R7706.1, U7701.24 (PH1-OSC_OUT)
unnamed: PG7701.1, U7701.56 (PG0)
unnamed: PG7702.1, U7701.57 (PG1)
unnamed: PG7703.1, U7701.87 (PG2)
unnamed: PG7704.1, U7701.88 (PG3)
unnamed: PG7705.1, U7701.89 (PG4)
unnamed: PG7706.1, U7701.90 (PG5)
unnamed: PG7707.1, U7701.91 (PG6)
unnamed: PG7708.1, U7701.92 (PG7)
unnamed: C7716.1, U7701.71 (VCAP1)
unnamed: C7714.1, U7701.106 (VCAP2)
nRESET: J7702.10 (~RESET), U7701.25 (NRST); also elsewhere on the board

Notes on the sheet:
SPI1=disp SPI2=switch SPI3=FPGA SPI4=qsd SPI5=n/u SPI6=tune
DEBUG
ST7789V 135x240 LCD

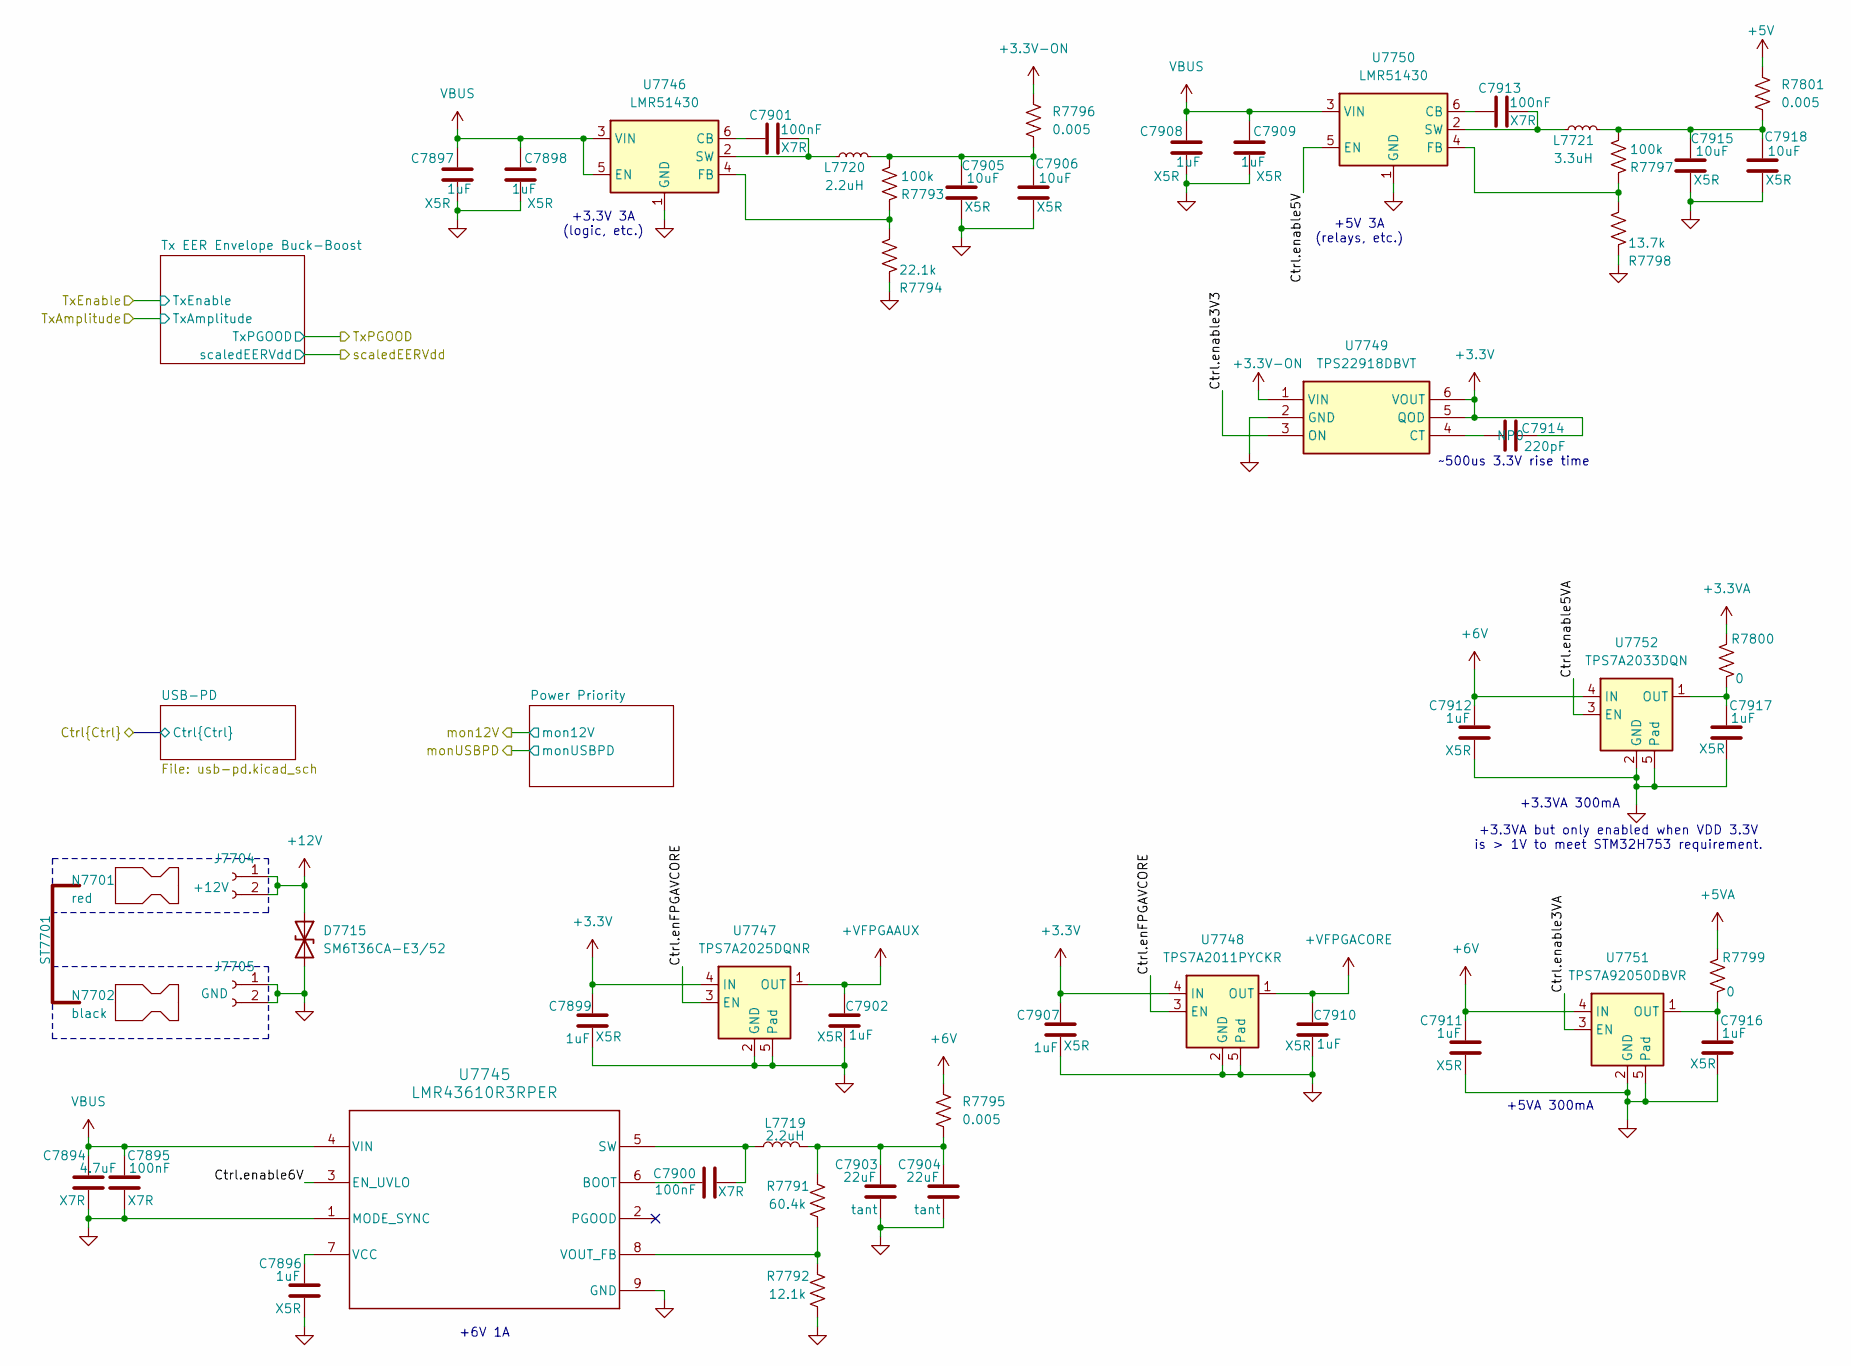
[picture p6: schematic power.kicad_sch, Power Supplies]

Parts:
C7894: 4.7uF; C_0805_2012Metric; Manufacturer_Part_Number 08055D475KAT4A; Mouser Part Number 581-08055D475KAT4A
C7895, C7900, C7901, C7913: 100nF; C_0603_1608Metric; Manufacturer_Part_Number C0805F104K1RACAUTO; Mouser Part Number 80-C0805F104K1RAUTO
C7896, C7899, C7902, C7907, C7910, C7911, C7912, C7916, C7917: 1uF; C_0402_1005Metric; Manufacturer_Part_Number GRM155R61E105KE11D; Mouser Part Number 81-GRM155R61E105KE1D
C7897, C7898, C7908, C7909: 1uF; C_0603_1608Metric; Manufacturer_Part_Number GRM155R61E105KE11D; Mouser Part Number 81-GRM155R61E105KE1D
C7903, C7904: 22uF; CP_EIA-7343-31_Kemet-D; Manufacturer_Part_Number 293D226X9035D2TE3; Mouser Part Number 74-293D226X9035D2TE3
C7905, C7906, C7915, C7918: 10uF; C_0603_1608Metric; Manufacturer_Part_Number 81-GXT155R71E223KE1D; Mouser Part Number 963-MLAST168BB5106MT
C7914: 220pF; C_0603_1608Metric; Manufacturer_Part_Number C1608C0G1H221F080AA; Mouser Part Number 810-C1608C0G1H221F
D7715: SM6T36CA-E3/52; D_SMB
J7704, J7705: 1336G1
L7719: 2.2uH; IND_XGL4030_COC
L7720: 2.2uH; L_0805_2012Metric
L7721: 3.3uH; L_0805_2012Metric
N7701: red
N7702: black
R7791: 60.4k; R_0603_1608Metric
R7792: 12.1k; R_0603_1608Metric
R7793, R7797: 100k; R_0402_1005Metric
R7794: 22.1k; R_0603_1608Metric
R7795, R7796, R7801: 0.005; R_0612_1632Metric; Manufacturer_Part_Number WFCP06125L000FE66
R7798: 13.7k; R_0603_1608Metric
R7799, R7800: 0; R_0603_1608Metric
ST7701: Anderson-114555P2-staple
U7745: LMR43610R3RPER; RPE0009A-MFG
U7746, U7750: LMR51430; SOT-23-6
U7747: TPS7A2025DQNR; Texas_X2SON-4_1x1mm_P0.65mm
U7748: TPS7A2011PYCKR; Texas_X2SON-4_1x1mm_P0.65mm
U7749: TPS22918DBVT; SOT-23-6; Mouser Part Number 595-TPS22918DBVT
U7751: TPS7A92050DBVR; Texas_X2SON-4_1x1mm_P0.65mm
U7752: TPS7A2033DQN; Texas_X2SON-4_1x1mm_P0.65mm

Connections:
+3.3V: C7899.1, C7907.1, C7914.2, U7747.4 (IN), U7748.4 (IN), U7749.5 (QOD), U7749.6 (VOUT); also elsewhere on the board
+3.3V-ON: R7796.1, U7749.1 (VIN); also elsewhere on the board
+3.3VA: R7800.1; also elsewhere on the board
+5VA: R7799.1; also elsewhere on the board
+6V: C7911.1, C7912.1, R7795.1, U7751.4 (IN), U7752.4 (IN)
+12V: D7715.1 (A1), J7704.1, J7704.2; also elsewhere on the board
+VFPGAAUX: C7902.1, U7747.1 (OUT); also elsewhere on the board
+VFPGACORE: C7910.1, U7748.1 (OUT); also elsewhere on the board
/FPGA/Ctrl.enable3V3: U7749.3 (ON); also elsewhere on the board
/FPGA/Ctrl.enable3VA: U7751.3 (EN); also elsewhere on the board
/FPGA/Ctrl.enable5V: U7750.5 (EN); also elsewhere on the board
/FPGA/Ctrl.enable5VA: U7752.3 (EN); also elsewhere on the board
/FPGA/Ctrl.enable6V: U7745.3 (EN_UVLO); also elsewhere on the board
/Power/Ctrl.enFPGAVCORE: U7747.3 (EN), U7748.3 (EN)
unnamed: C7903.1, C7904.1, L7719.2, R7791.2, R7795.2
unnamed: C7905.1, C7906.1, L7720.2, R7793.2, R7796.2
unnamed: C7915.1, C7918.1, L7721.2, R7797.2, R7801.2
unnamed: C7900.1, U7745.6 (BOOT)
unnamed: C7900.2, L7719.1, U7745.5 (SW)
unnamed: C7896.1, U7745.7 (VCC)
unnamed: R7791.1, R7792.2, U7745.8 (VOUT_FB)
unnamed: C7901.1, U7746.6 (CB)
unnamed: R7793.1, R7794.2, U7746.4 (FB)
unnamed: C7901.2, L7720.1, U7746.2 (SW)
unnamed: C7914.1, U7749.4 (CT)
unnamed: C7913.1, U7750.6 (CB)
unnamed: R7797.1, R7798.2, U7750.4 (FB)
unnamed: C7913.2, L7721.1, U7750.2 (SW)
unnamed: C7916.1, R7799.2, U7751.1 (OUT)
unnamed: C7917.1, R7800.2, U7752.1 (OUT)
VBUS: C7894.1, C7895.1, C7897.1, C7898.1, C7908.1, C7909.1, U7745.4 (VIN), U7746.3 (VIN), U7746.5 (EN), U7750.3 (VIN); also elsewhere on the board

Notes on the sheet:
~500us 3.3V rise time
+5V 3A (relays, etc.)
+6V 1A
+5VA 300mA
+3.3VA but only enabled when VDD 3.3V is > 1V to meet STM32H753 requirement.
+3.3V 3A (logic, etc.)
+3.3VA 300mA

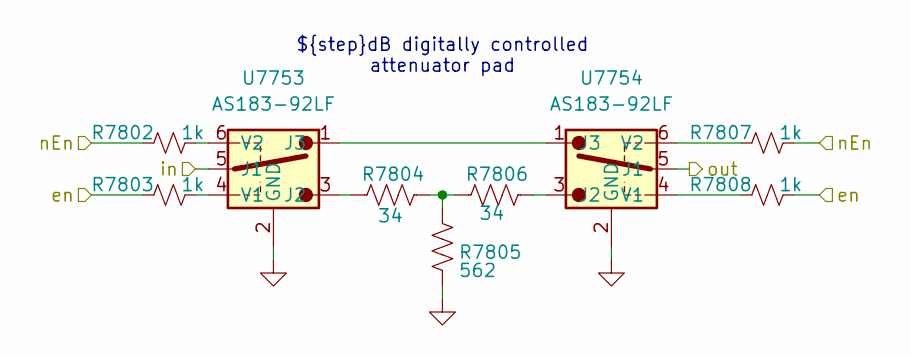
[picture p7: schematic tpad.kicad_sch, Attenuator Tpad]

Parts:
R7802, R7803, R7807, R7808: 1k; R_0402_1005Metric
R7804, R7806: 34; R_1206_3216Metric
R7805: 562; R_1206_3216Metric
U7753, U7754: AS183-92LF; SOT65P220X110-6N; Mouser Part Number 873-AS183-92LF

Connections:
/Rx Front End/Ctrl.atten3dB: R7803.1, R7808.2; also elsewhere on the board
/Rx Front End/Tpad 3/in: U7753.5 (J1); also elsewhere on the board
/Rx Front End/n3dB: R7802.1, R7807.2; also elsewhere on the board
/Rx Front End/rf200atten: U7754.5 (J1); also elsewhere on the board
unnamed: R7804.1, R7805.1, R7806.1
unnamed: R7804.2, U7753.3 (J2)
unnamed: U7753.1 (J3), U7754.1 (J3)
unnamed: R7803.2, U7753.4 (V1)
unnamed: R7802.2, U7753.6 (V2)
unnamed: R7806.2, U7754.3 (J2)
unnamed: R7808.1, U7754.4 (V1)
unnamed: R7807.1, U7754.6 (V2)

Parts of its further copies:
R7840, R7841, R7845, R7846, R7878, R7879, R7883, R7884, R7885, R7886, R7890, R7891: 1k; R_0402_1005Metric
R7842, R7844, R7880, R7882, R7887, R7889: 34; R_1206_3216Metric
R7843, R7881, R7888: 562; R_1206_3216Metric
U7761, U7762, U7767, U7768, U7769, U7770: AS183-92LF; SOT65P220X110-6N; Mouser Part Number 873-AS183-92LF

Connections of its further copies:
/Rx Front End/Ctrl.atten6dB: R7841.1, R7846.2; also elsewhere on the board
/Rx Front End/Ctrl.atten12dB: R7879.1, R7884.2; also elsewhere on the board
/Rx Front End/Ctrl.atten24dB: R7886.1, R7891.2; also elsewhere on the board
/Rx Front End/Tpad 3/in: U7762.5 (J1); also elsewhere on the board
/Rx Front End/Tpad 12/in: U7767.5 (J1), U7770.5 (J1)
/Rx Front End/Tpad 12/out: U7761.5 (J1), U7768.5 (J1)
/Rx Front End/Tpad 24/in: U7769.5 (J1); also elsewhere on the board
/Rx Front End/n6dB: R7840.1, R7845.2; also elsewhere on the board
/Rx Front End/n12dB: R7878.1, R7883.2; also elsewhere on the board
/Rx Front End/n24dB: R7885.1, R7890.2; also elsewhere on the board
unnamed: R7842.1, R7843.1, R7844.1
unnamed: R7880.1, R7881.1, R7882.1
unnamed: R7887.1, R7888.1, R7889.1
unnamed: R7842.2, U7761.3 (J2)
unnamed: U7761.1 (J3), U7762.1 (J3)
unnamed: R7841.2, U7761.4 (V1)
unnamed: R7840.2, U7761.6 (V2)
unnamed: R7844.2, U7762.3 (J2)
unnamed: R7846.1, U7762.4 (V1)
unnamed: R7845.1, U7762.6 (V2)
unnamed: R7880.2, U7767.3 (J2)
unnamed: U7767.1 (J3), U7768.1 (J3)
unnamed: R7879.2, U7767.4 (V1)
unnamed: R7878.2, U7767.6 (V2)
unnamed: R7882.2, U7768.3 (J2)
unnamed: R7884.1, U7768.4 (V1)
unnamed: R7883.1, U7768.6 (V2)
unnamed: R7887.2, U7769.3 (J2)
unnamed: U7769.1 (J3), U7770.1 (J3)
unnamed: R7886.2, U7769.4 (V1)
unnamed: R7885.2, U7769.6 (V2)
unnamed: R7889.2, U7770.3 (J2)
unnamed: R7891.1, U7770.4 (V1)
unnamed: R7890.1, U7770.6 (V2)

Notes on the sheet:
${step}dB digitally controlled attenuator pad

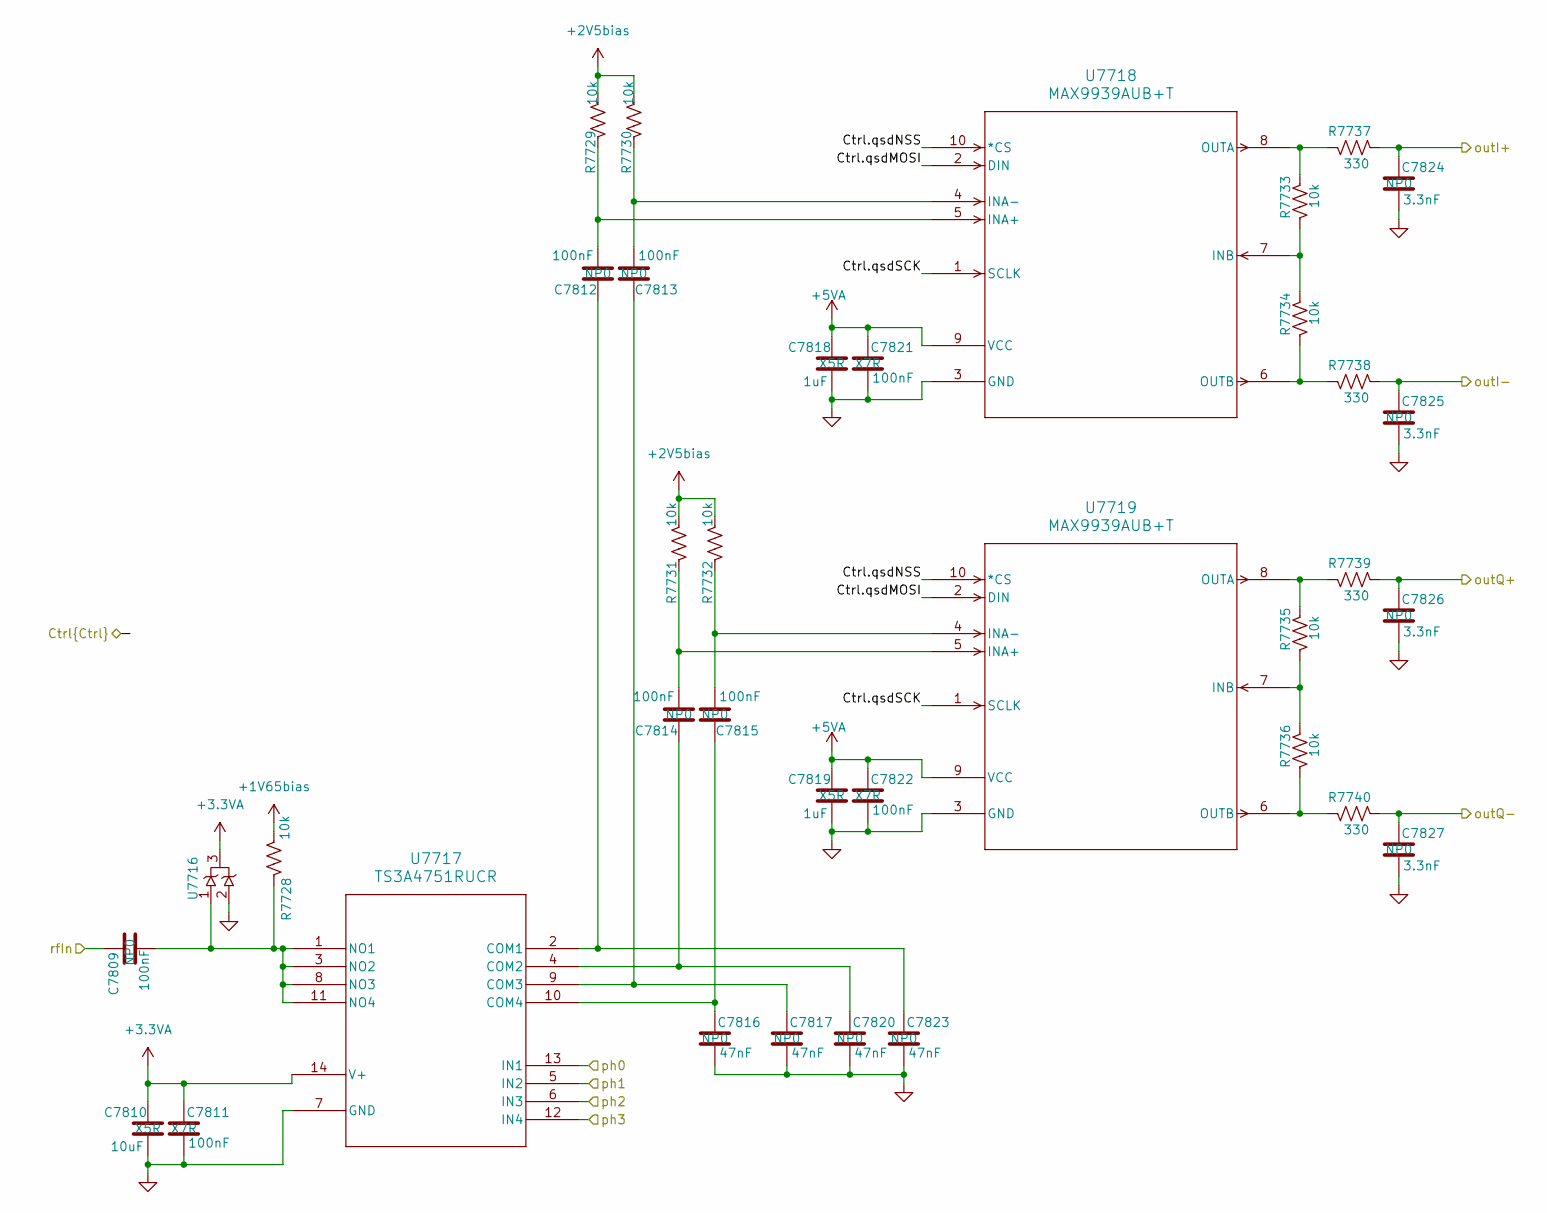
[picture p8: schematic qsd.kicad_sch]

Parts:
C7809, C7812, C7813, C7814, C7815: 100nF; C_1206_3216Metric; Manufacturer_Part_Number GRM31C5C2A104JA01L; Mouser Part Number 81-GRM31C5C2A104JA1L
C7810: 10uF; C_0603_1608Metric; Manufacturer_Part_Number 81-GXT155R71E223KE1D; Mouser Part Number 963-MLAST168BB5106MT
C7811, C7821, C7822: 100nF; C_0603_1608Metric; Manufacturer_Part_Number C0805F104K1RACAUTO; Mouser Part Number 80-C0805F104K1RAUTO
C7816, C7817, C7820, C7823: 47nF; C_0805_2012Metric; Manufacturer_Part_Number GCM31M5C1H473FA16L; Mouser Part Number 81-GCM31M5C1H473FA6L
C7818, C7819: 1uF; C_0402_1005Metric; Manufacturer_Part_Number GRM155R61E105KE11D; Mouser Part Number 81-GRM155R61E105KE1D
C7824, C7825, C7826, C7827: 3.3nF; C_0603_1608Metric; Manufacturer_Part_Number C1608C0G1H332J080AE; Mouser Part Number 810-C1608C0G1H332J08
R7728, R7729, R7730, R7731, R7732, R7733, R7734, R7735, R7736: 10k; R_0402_1005Metric
R7737, R7738, R7739, R7740: 330; R_0603_1608Metric
U7716: SZNUP1105LT1G; SOT-23
U7717: TS3A4751RUCR; TS3A4751-RUC14
U7718, U7719: MAX9939AUB+T; 21-0061L_MXM

Connections:
+1V65bias: R7728.1; also elsewhere on the board
+2V5bias: R7729.1, R7730.1, R7731.1, R7732.1; also elsewhere on the board
+3.3VA: C7810.1, C7811.1, U7716.3, U7717.14 (V+); also elsewhere on the board
+5VA: C7818.1, C7819.1, C7821.1, C7822.1, U7718.9 (VCC), U7719.9 (VCC); also elsewhere on the board
/FPGA/Ctrl.qsdMOSI: U7718.2 (DIN), U7719.2 (DIN); also elsewhere on the board
/FPGA/Ctrl.qsdNSS: U7718.10 (*CS), U7719.10 (*CS); also elsewhere on the board
/FPGA/Ctrl.qsdPh1a: U7717.13 (IN1); also elsewhere on the board
/FPGA/Ctrl.qsdPh1b: U7717.5 (IN2); also elsewhere on the board
/FPGA/Ctrl.qsdPh1c: U7717.6 (IN3); also elsewhere on the board
/FPGA/Ctrl.qsdPh1d: U7717.12 (IN4); also elsewhere on the board
/FPGA/Ctrl.qsdSCK: U7718.1 (SCLK), U7719.1 (SCLK); also elsewhere on the board
/Rx Front End/QSD1/rfIn: C7809.1; also elsewhere on the board
/Rx Front End/RxI1n: C7825.1, R7738.2; also elsewhere on the board
/Rx Front End/RxI1p: C7824.1, R7737.2; also elsewhere on the board
/Rx Front End/RxQ1n: C7827.1, R7740.2; also elsewhere on the board
/Rx Front End/RxQ1p: C7826.1, R7739.2; also elsewhere on the board
unnamed: C7812.1, C7823.1, U7717.2 (COM1)
unnamed: C7814.1, C7820.1, U7717.4 (COM2)
unnamed: C7813.1, C7817.1, U7717.9 (COM3)
unnamed: C7815.1, C7816.1, U7717.10 (COM4)
unnamed: C7809.2, R7728.2, U7716.1, U7717.1 (NO1), U7717.3 (NO2), U7717.8 (NO3), U7717.11 (NO4)
unnamed: C7812.2, R7729.2, U7718.5 (INA+)
unnamed: C7813.2, R7730.2, U7718.4 (INA-)
unnamed: R7733.2, R7734.1, U7718.7 (INB)
unnamed: R7733.1, R7737.1, U7718.8 (OUTA)
unnamed: R7734.2, R7738.1, U7718.6 (OUTB)
unnamed: C7814.2, R7731.2, U7719.5 (INA+)
unnamed: C7815.2, R7732.2, U7719.4 (INA-)
unnamed: R7735.2, R7736.1, U7719.7 (INB)
unnamed: R7735.1, R7739.1, U7719.8 (OUTA)
unnamed: R7736.2, R7740.1, U7719.6 (OUTB)

Parts of its further copies:
C7828, C7831, C7832, C7833, C7834, C7847, C7850, C7851, C7852, C7853: 100nF; C_1206_3216Metric; Manufacturer_Part_Number GRM31C5C2A104JA01L; Mouser Part Number 81-GRM31C5C2A104JA1L
C7829, C7848: 10uF; C_0603_1608Metric; Manufacturer_Part_Number 81-GXT155R71E223KE1D; Mouser Part Number 963-MLAST168BB5106MT
C7830, C7840, C7841, C7849, C7859, C7860: 100nF; C_0603_1608Metric; Manufacturer_Part_Number C0805F104K1RACAUTO; Mouser Part Number 80-C0805F104K1RAUTO
C7835, C7836, C7839, C7842, C7854, C7855, C7858, C7861: 47nF; C_0805_2012Metric; Manufacturer_Part_Number GCM31M5C1H473FA16L; Mouser Part Number 81-GCM31M5C1H473FA6L
C7837, C7838, C7856, C7857: 1uF; C_0402_1005Metric; Manufacturer_Part_Number GRM155R61E105KE11D; Mouser Part Number 81-GRM155R61E105KE1D
C7843, C7844, C7845, C7846, C7862, C7863, C7864, C7865: 3.3nF; C_0603_1608Metric; Manufacturer_Part_Number C1608C0G1H332J080AE; Mouser Part Number 810-C1608C0G1H332J08
R7741, R7742, R7743, R7744, R7745, R7746, R7747, R7748, R7749, R7754, R7755, R7756, R7757, R7758, R7759, R7760, R7761, R7762: 10k; R_0402_1005Metric
R7750, R7751, R7752, R7753, R7763, R7764, R7765, R7766: 330; R_0603_1608Metric
U7720, U7724: SZNUP1105LT1G; SOT-23
U7721, U7725: TS3A4751RUCR; TS3A4751-RUC14
U7722, U7723, U7726, U7727: MAX9939AUB+T; 21-0061L_MXM

Connections of its further copies:
+1V65bias: R7741.1, R7754.1; also elsewhere on the board
+2V5bias: R7742.1, R7743.1, R7744.1, R7745.1, R7755.1, R7756.1, R7757.1, R7758.1; also elsewhere on the board
+3.3VA: C7829.1, C7830.1, C7848.1, C7849.1, U7720.3, U7721.14 (V+), U7724.3, U7725.14 (V+); also elsewhere on the board
+5VA: C7837.1, C7838.1, C7840.1, C7841.1, C7856.1, C7857.1, C7859.1, C7860.1, U7722.9 (VCC), U7723.9 (VCC), U7726.9 (VCC), U7727.9 (VCC); also elsewhere on the board
/FPGA/Ctrl.qsdMOSI: U7722.2 (DIN), U7723.2 (DIN), U7726.2 (DIN), U7727.2 (DIN); also elsewhere on the board
/FPGA/Ctrl.qsdNSS: U7722.10 (*CS), U7723.10 (*CS), U7726.10 (*CS), U7727.10 (*CS); also elsewhere on the board
/FPGA/Ctrl.qsdPh0a: U7725.13 (IN1); also elsewhere on the board
/FPGA/Ctrl.qsdPh0b: U7725.5 (IN2); also elsewhere on the board
/FPGA/Ctrl.qsdPh0c: U7725.6 (IN3); also elsewhere on the board
/FPGA/Ctrl.qsdPh0d: U7725.12 (IN4); also elsewhere on the board
/FPGA/Ctrl.qsdPh2a: U7721.13 (IN1); also elsewhere on the board
/FPGA/Ctrl.qsdPh2b: U7721.5 (IN2); also elsewhere on the board
/FPGA/Ctrl.qsdPh2c: U7721.6 (IN3); also elsewhere on the board
/FPGA/Ctrl.qsdPh2d: U7721.12 (IN4); also elsewhere on the board
/FPGA/Ctrl.qsdSCK: U7722.1 (SCLK), U7723.1 (SCLK), U7726.1 (SCLK), U7727.1 (SCLK); also elsewhere on the board
/Rx Front End/QSD0/rfIn: C7847.1; also elsewhere on the board
/Rx Front End/QSD2/rfIn: C7828.1; also elsewhere on the board
/Rx Front End/RxI0n: C7863.1, R7764.2
/Rx Front End/RxI0p: C7862.1, R7763.2; also elsewhere on the board
/Rx Front End/RxI2n: C7844.1, R7751.2; also elsewhere on the board
/Rx Front End/RxI2p: C7843.1, R7750.2; also elsewhere on the board
/Rx Front End/RxQ0n: C7865.1, R7766.2
/Rx Front End/RxQ0p: C7864.1, R7765.2; also elsewhere on the board
/Rx Front End/RxQ2n: C7846.1, R7753.2; also elsewhere on the board
/Rx Front End/RxQ2p: C7845.1, R7752.2; also elsewhere on the board
unnamed: C7831.1, C7842.1, U7721.2 (COM1)
unnamed: C7833.1, C7839.1, U7721.4 (COM2)
unnamed: C7832.1, C7836.1, U7721.9 (COM3)
unnamed: C7834.1, C7835.1, U7721.10 (COM4)
unnamed: C7828.2, R7741.2, U7720.1, U7721.1 (NO1), U7721.3 (NO2), U7721.8 (NO3), U7721.11 (NO4)
unnamed: C7831.2, R7742.2, U7722.5 (INA+)
unnamed: C7832.2, R7743.2, U7722.4 (INA-)
unnamed: R7746.2, R7747.1, U7722.7 (INB)
unnamed: R7746.1, R7750.1, U7722.8 (OUTA)
unnamed: R7747.2, R7751.1, U7722.6 (OUTB)
unnamed: C7833.2, R7744.2, U7723.5 (INA+)
unnamed: C7834.2, R7745.2, U7723.4 (INA-)
unnamed: R7748.2, R7749.1, U7723.7 (INB)
unnamed: R7748.1, R7752.1, U7723.8 (OUTA)
unnamed: R7749.2, R7753.1, U7723.6 (OUTB)
unnamed: C7850.1, C7861.1, U7725.2 (COM1)
unnamed: C7852.1, C7858.1, U7725.4 (COM2)
unnamed: C7851.1, C7855.1, U7725.9 (COM3)
unnamed: C7853.1, C7854.1, U7725.10 (COM4)
unnamed: C7847.2, R7754.2, U7724.1, U7725.1 (NO1), U7725.3 (NO2), U7725.8 (NO3), U7725.11 (NO4)
unnamed: C7850.2, R7755.2, U7726.5 (INA+)
unnamed: C7851.2, R7756.2, U7726.4 (INA-)
unnamed: R7759.2, R7760.1, U7726.7 (INB)
unnamed: R7759.1, R7763.1, U7726.8 (OUTA)
unnamed: R7760.2, R7764.1, U7726.6 (OUTB)
unnamed: C7852.2, R7757.2, U7727.5 (INA+)
unnamed: C7853.2, R7758.2, U7727.4 (INA-)
unnamed: R7761.2, R7762.1, U7727.7 (INB)
unnamed: R7761.1, R7765.1, U7727.8 (OUTA)
unnamed: R7762.2, R7766.1, U7727.6 (OUTB)
