alanmimms/nexrig/hw/NexRig.kicad_pcb

## KiCad design hw/NexRig.kicad_pcb (continued)

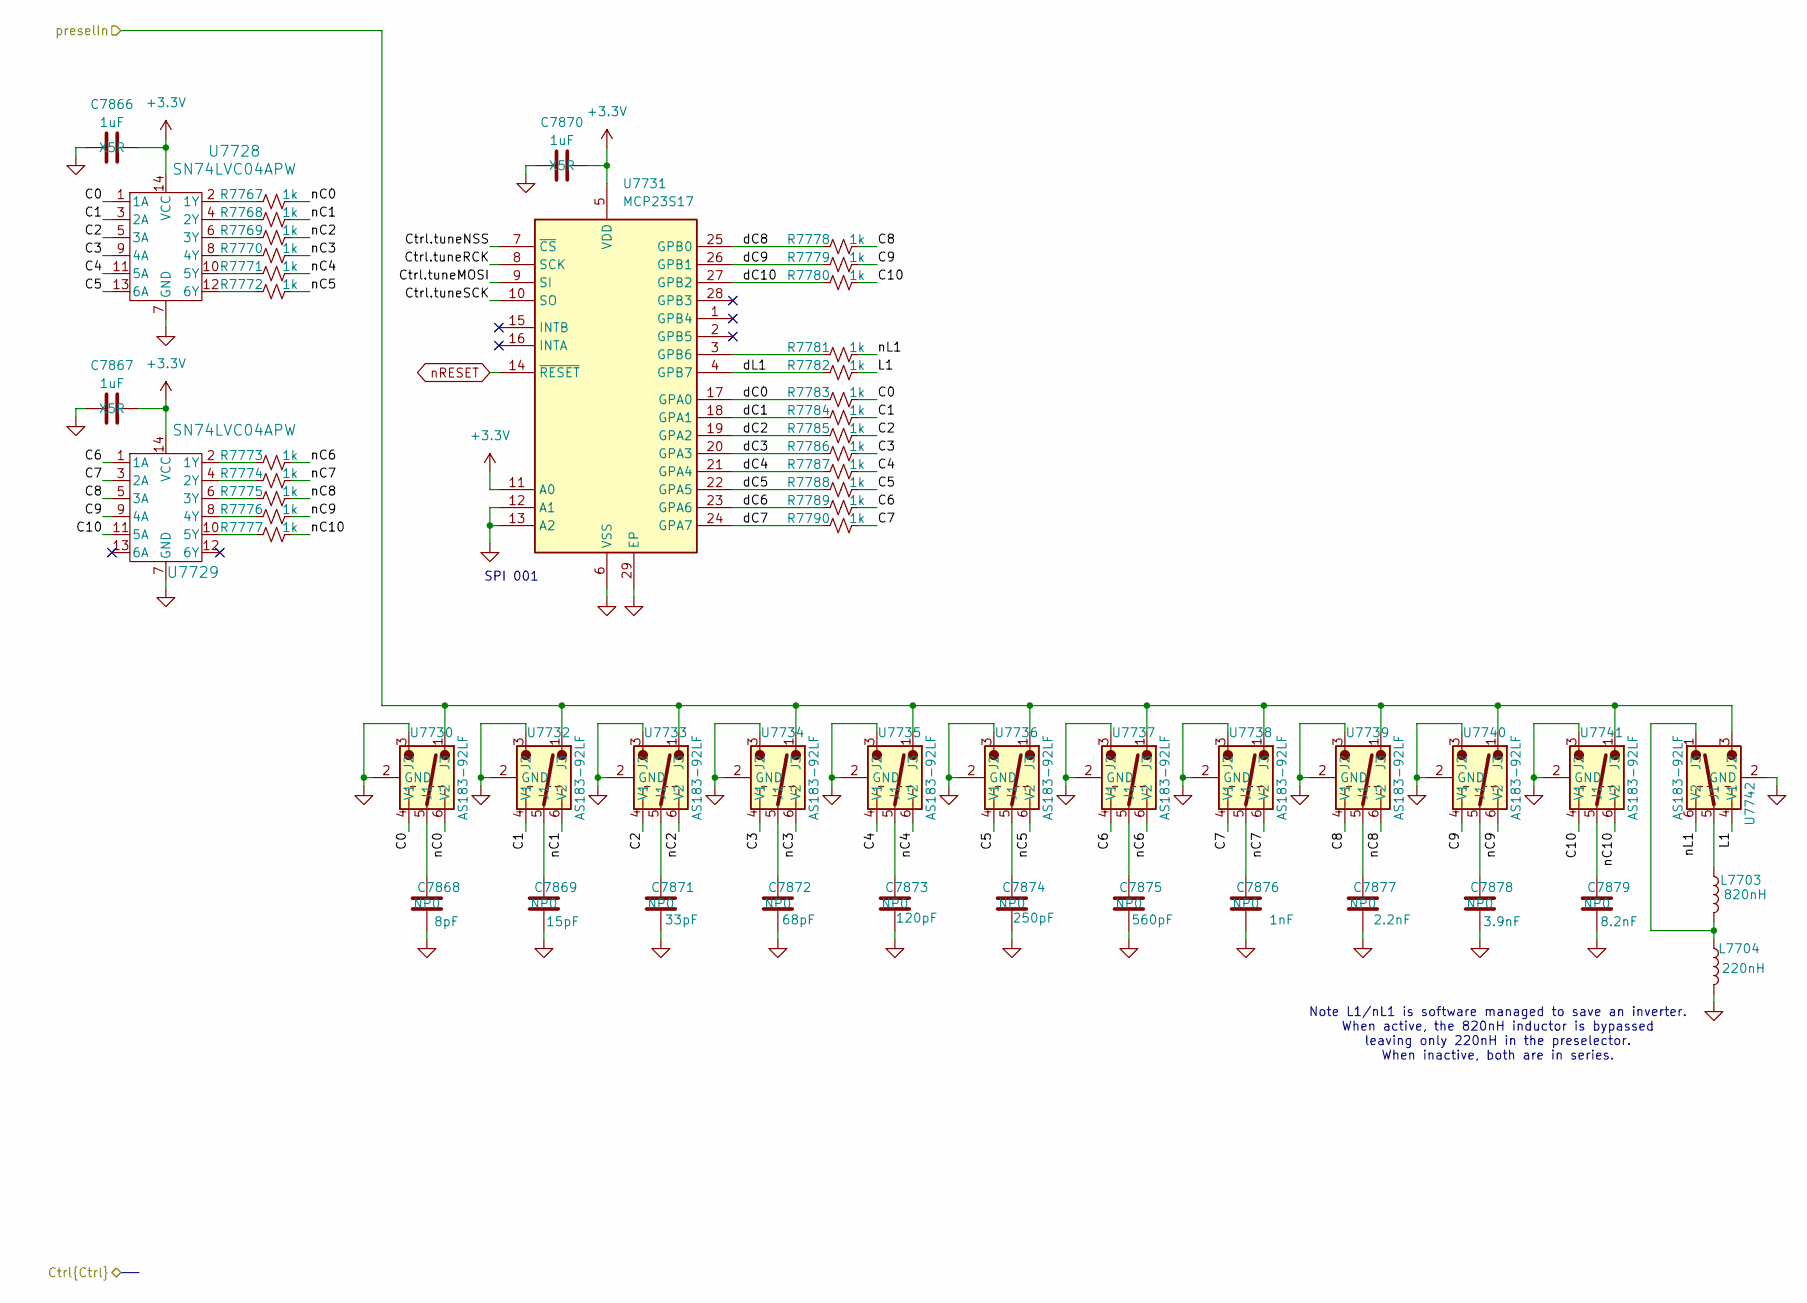
[picture p9: schematic rx-presel.kicad_sch, Rx Digitally Tuned Preselector]

Parts:
C7866, C7867, C7870: 1uF; C_0402_1005Metric; Manufacturer_Part_Number GRM155R61E105KE11D; Mouser Part Number 81-GRM155R61E105KE1D
C7868: 8pF; C_0603_1608Metric; Manufacturer_Part_Number CGA3E2C0G1H080D080AA; Mouser Part Number 810-CGA3E2C0G1H080D
C7869: 15pF; C_0603_1608Metric; Manufacturer_Part_Number CGA3E2C0G1H150J080AA; Mouser Part Number 810-CGA3E2C0G1H150J
C7871: 33pF; C_0603_1608Metric; Manufacturer_Part_Number CGA3E2C0G1H330J080AA; Mouser Part Number 810-CGA3E2C0G1H330J
C7872: 68pF; C_0603_1608Metric; Manufacturer_Part_Number CGA3E2C0G1H680J080AA; Mouser Part Number 810-CGA3E2C0G1H680J
C7873: 120pF; C_0603_1608Metric; Manufacturer_Part_Number CGA3E2C0G1H121J080AA; Mouser Part Number 810-CGA3E2C0G1H121J
C7874: 250pF; C_0603_1608Metric; Manufacturer_Part_Number 06035A251JAT2A; Mouser Part Number 581-06035A251J
C7875: 560pF; C_0603_1608Metric; Manufacturer_Part_Number CGA3E2C0G1H561J080AA; Mouser Part Number 810-CGA3E2C0G1H561J
C7876: 1nF; C_0603_1608Metric; Manufacturer_Part_Number C1608C0G1H102J080AA; Mouser Part Number 810-C1608C0G1H102J
C7877: 2.2nF; C_0603_1608Metric; Manufacturer_Part_Number CGA3E2C0G1H222J080AE; Mouser Part Number 810-CGA3E2C0G1H222J8
C7878: 3.9nF; C_0603_1608Metric; Manufacturer_Part_Number CGA3E2C0G1H392J080AA; Mouser Part Number 810-CGA3E2C0G1H392J
C7879: 8.2nF; C_0603_1608Metric; Manufacturer_Part_Number CGA3E2C0G1H822J080AE; Mouser Part Number 810-CGA3E2C0G1H822J8
L7703: 820nH; L_1210_3225Metric
L7704: 220nH; L_1210_3225Metric
R7767, R7768, R7769, R7770, R7771, R7772, R7773, R7774, R7775, R7776, R7777, R7778, R7779, R7780, R7781, R7782, R7783, R7784, R7785, R7786, R7787, R7788, R7789, R7790: 1k; R_0402_1005Metric
U7728, U7729: SN74LVC04APW; PW14
U7730, U7732, U7733, U7734, U7735, U7736, U7737, U7738, U7739, U7740, U7741, U7742: AS183-92LF; SOT65P220X110-6N; Mouser Part Number 873-AS183-92LF
U7731: MCP23S17; QFN65P600X600X100-29N-D; Mouser Part Number 579-MCP23S17T-E/ML

Connections:
+3.3V: C7866.2, C7867.2, C7870.2, U7728.14 (VCC), U7729.14 (VCC), U7731.5 (VDD), U7731.11 (A0); also elsewhere on the board
/Rx Front End/Rx Preselector/C0: R7783.2, U7728.1 (1A), U7730.4 (V1)
/Rx Front End/Rx Preselector/C1: R7784.2, U7728.3 (2A), U7732.4 (V1)
/Rx Front End/Rx Preselector/C2: R7785.2, U7728.5 (3A), U7733.4 (V1)
/Rx Front End/Rx Preselector/C3: R7786.2, U7728.9 (4A), U7734.4 (V1)
/Rx Front End/Rx Preselector/C4: R7787.2, U7728.11 (5A), U7735.4 (V1)
/Rx Front End/Rx Preselector/C5: R7788.2, U7728.13 (6A), U7736.4 (V1)
/Rx Front End/Rx Preselector/C6: R7789.2, U7729.1 (1A), U7737.4 (V1)
/Rx Front End/Rx Preselector/C7: R7790.2, U7729.3 (2A), U7738.4 (V1)
/Rx Front End/Rx Preselector/C8: R7778.2, U7729.5 (3A), U7739.4 (V1)
/Rx Front End/Rx Preselector/C9: R7779.2, U7729.9 (4A), U7740.4 (V1)
/Rx Front End/Rx Preselector/C10: R7780.2, U7729.11 (5A), U7741.4 (V1)
/Rx Front End/Rx Preselector/Ctrl.tuneMOSI: U7731.9 (SI)
/Rx Front End/Rx Preselector/Ctrl.tuneNSS: U7731.7 (~CS)
/Rx Front End/Rx Preselector/Ctrl.tuneRCK: U7731.8 (SCK)
/Rx Front End/Rx Preselector/Ctrl.tuneSCK: U7731.10 (SO)
/Rx Front End/Rx Preselector/L1: R7782.2, U7742.4 (V1)
/Rx Front End/Rx Preselector/dC0: R7783.1, U7731.17 (GPA0)
/Rx Front End/Rx Preselector/dC1: R7784.1, U7731.18 (GPA1)
/Rx Front End/Rx Preselector/dC2: R7785.1, U7731.19 (GPA2)
/Rx Front End/Rx Preselector/dC3: R7786.1, U7731.20 (GPA3)
/Rx Front End/Rx Preselector/dC4: R7787.1, U7731.21 (GPA4)
/Rx Front End/Rx Preselector/dC5: R7788.1, U7731.22 (GPA5)
/Rx Front End/Rx Preselector/dC6: R7789.1, U7731.23 (GPA6)
/Rx Front End/Rx Preselector/dC7: R7790.1, U7731.24 (GPA7)
/Rx Front End/Rx Preselector/dC8: R7778.1, U7731.25 (GPB0)
/Rx Front End/Rx Preselector/dC9: R7779.1, U7731.26 (GPB1)
/Rx Front End/Rx Preselector/dC10: R7780.1, U7731.27 (GPB2)
/Rx Front End/Rx Preselector/dL1: R7782.1, U7731.4 (GPB7)
/Rx Front End/Rx Preselector/nC0: R7767.2, U7730.6 (V2)
/Rx Front End/Rx Preselector/nC1: R7768.2, U7732.6 (V2)
/Rx Front End/Rx Preselector/nC2: R7769.2, U7733.6 (V2)
/Rx Front End/Rx Preselector/nC3: R7770.2, U7734.6 (V2)
/Rx Front End/Rx Preselector/nC4: R7771.2, U7735.6 (V2)
/Rx Front End/Rx Preselector/nC5: R7772.2, U7736.6 (V2)
/Rx Front End/Rx Preselector/nC6: R7773.2, U7737.6 (V2)
/Rx Front End/Rx Preselector/nC7: R7774.2, U7738.6 (V2)
/Rx Front End/Rx Preselector/nC8: R7775.2, U7739.6 (V2)
/Rx Front End/Rx Preselector/nC9: R7776.2, U7740.6 (V2)
/Rx Front End/Rx Preselector/nC10: R7777.2, U7741.6 (V2)
/Rx Front End/Rx Preselector/nL1: R7781.2, U7742.6 (V2)
/Rx Front End/rf200atten: U7730.1 (J3), U7732.1 (J3), U7733.1 (J3), U7734.1 (J3), U7735.1 (J3), U7736.1 (J3), U7737.1 (J3), U7738.1 (J3), U7739.1 (J3), U7740.1 (J3), U7741.1 (J3), U7742.3 (J2); also elsewhere on the board
unnamed: R7767.1, U7728.2 (1Y)
unnamed: R7768.1, U7728.4 (2Y)
unnamed: R7769.1, U7728.6 (3Y)
unnamed: R7770.1, U7728.8 (4Y)
unnamed: R7771.1, U7728.10 (5Y)
unnamed: R7772.1, U7728.12 (6Y)
unnamed: R7773.1, U7729.2 (1Y)
unnamed: R7774.1, U7729.4 (2Y)
unnamed: R7775.1, U7729.6 (3Y)
unnamed: R7776.1, U7729.8 (4Y)
unnamed: R7777.1, U7729.10 (5Y)
unnamed: C7868.1, U7730.5 (J1)
unnamed: R7781.1, U7731.3 (GPB6)
unnamed: C7869.1, U7732.5 (J1)
unnamed: C7871.1, U7733.5 (J1)
unnamed: C7872.1, U7734.5 (J1)
unnamed: C7873.1, U7735.5 (J1)
unnamed: C7874.1, U7736.5 (J1)
unnamed: C7875.1, U7737.5 (J1)
unnamed: C7876.1, U7738.5 (J1)
unnamed: C7877.1, U7739.5 (J1)
unnamed: C7878.1, U7740.5 (J1)
unnamed: C7879.1, U7741.5 (J1)
unnamed: L7703.1, U7742.5 (J1)
unnamed: L7703.2, L7704.1, U7742.1 (J3)
nRESET: U7731.14 (~RESET); also elsewhere on the board

Notes on the sheet:
Note L1/nL1 is software managed to save an inverter. When active, the 820nH inductor is bypassed leaving only 220nH in the preselector. When inactive, both are in series.
SPI 001

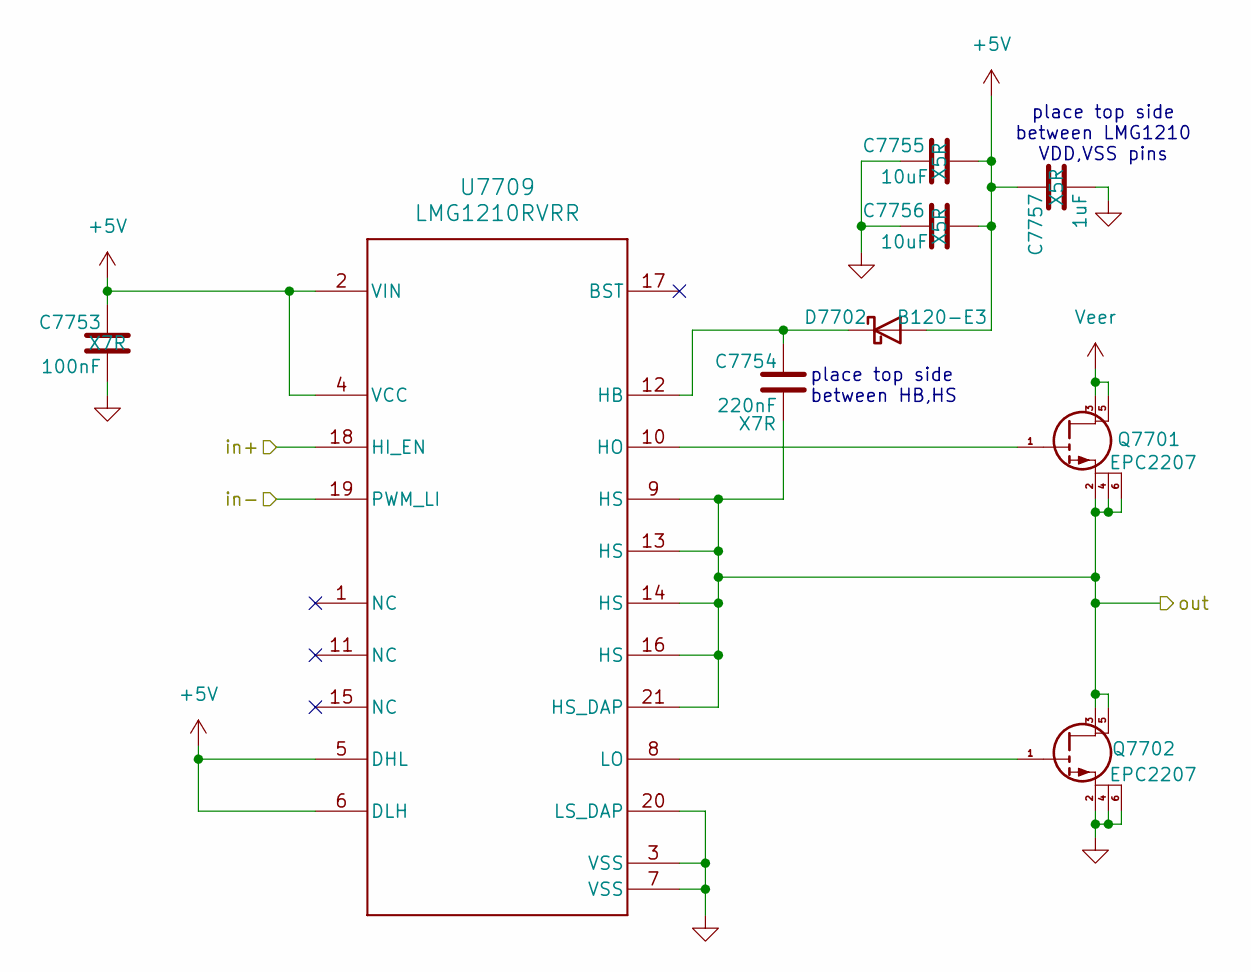
[picture p10: schematic tx-bridge.kicad_sch, GaN FET Transmitter Bridge]

Parts:
C7753: 100nF; C_0603_1608Metric; Manufacturer_Part_Number C0805F104K1RACAUTO; Mouser Part Number 80-C0805F104K1RAUTO
C7754: 220nF; C_0603_1608Metric; Manufacturer_Part_Number GXT155R71E223KE01D; Mouser Part Number 81-GXT155R71E223KE1D
C7755, C7756: 10uF; C_0603_1608Metric; Manufacturer_Part_Number 81-GXT155R71E223KE1D; Mouser Part Number 963-MLAST168BB5106MT
C7757: 1uF; C_0402_1005Metric; Manufacturer_Part_Number GRM155R61E105KE11D; Mouser Part Number 81-GRM155R61E105KE1D
D7702: B120-E3; D_SMA
Q7701, Q7702: EPC2207; EPC2207-GaN-FET; Manufacturer_Part_Number IGB110S101XTMA1
U7709: LMG1210RVRR; RVR0019A

Connections:
/FPGA/TxDrive.baseL+: U7709.18 (HI_EN); also elsewhere on the board
/FPGA/TxDrive.baseL-: U7709.19 (PWM_LI); also elsewhere on the board
/Tx Chain/Base L GaN FET Bridge/out: C7754.2, Q7701.2 (S), Q7701.4 (S), Q7701.6 (S), Q7702.3 (D), Q7702.5 (D), U7709.9 (HS), U7709.13 (HS), U7709.14 (HS), U7709.16 (HS), U7709.21 (HS_DAP); also elsewhere on the board
unnamed: C7754.1, D7702.1 (K), U7709.12 (HB)
unnamed: Q7701.1 (G), U7709.10 (HO)
unnamed: Q7702.1 (G), U7709.8 (LO)
Veer: Q7701.3 (D), Q7701.5 (D); also elsewhere on the board

Parts of its further copies:
C7794, C7799, C7804: 100nF; C_0603_1608Metric; Manufacturer_Part_Number C0805F104K1RACAUTO; Mouser Part Number 80-C0805F104K1RAUTO
C7795, C7800, C7805: 220nF; C_0603_1608Metric; Manufacturer_Part_Number GXT155R71E223KE01D; Mouser Part Number 81-GXT155R71E223KE1D
C7796, C7797, C7801, C7802, C7806, C7807: 10uF; C_0603_1608Metric; Manufacturer_Part_Number 81-GXT155R71E223KE1D; Mouser Part Number 963-MLAST168BB5106MT
C7798, C7803, C7808: 1uF; C_0402_1005Metric; Manufacturer_Part_Number GRM155R61E105KE11D; Mouser Part Number 81-GRM155R61E105KE1D
D7704, D7705, D7706: B120-E3; D_SMA
Q7703, Q7704, Q7705, Q7706, Q7707, Q7708: EPC2207; EPC2207-GaN-FET; Manufacturer_Part_Number IGB110S101XTMA1
U7713, U7714, U7715: LMG1210RVRR; RVR0019A

Connections of its further copies:
/FPGA/TxDrive.baseR+: U7713.18 (HI_EN); also elsewhere on the board
/FPGA/TxDrive.baseR-: U7713.19 (PWM_LI); also elsewhere on the board
/FPGA/TxDrive.peakL+: U7714.18 (HI_EN); also elsewhere on the board
/FPGA/TxDrive.peakL-: U7714.19 (PWM_LI); also elsewhere on the board
/FPGA/TxDrive.peakR+: U7715.18 (HI_EN); also elsewhere on the board
/FPGA/TxDrive.peakR-: U7715.19 (PWM_LI); also elsewhere on the board
/Tx Chain/Base R GaN FET Bridge/out: C7795.2, Q7703.2 (S), Q7703.4 (S), Q7703.6 (S), Q7704.3 (D), Q7704.5 (D), U7713.9 (HS), U7713.13 (HS), U7713.14 (HS), U7713.16 (HS), U7713.21 (HS_DAP); also elsewhere on the board
/Tx Chain/Peak L GaN FET Bridge/out: C7800.2, Q7705.2 (S), Q7705.4 (S), Q7705.6 (S), Q7706.3 (D), Q7706.5 (D), U7714.9 (HS), U7714.13 (HS), U7714.14 (HS), U7714.16 (HS), U7714.21 (HS_DAP); also elsewhere on the board
/Tx Chain/Peak R GaN FET Bridge/out: C7805.2, Q7707.2 (S), Q7707.4 (S), Q7707.6 (S), Q7708.3 (D), Q7708.5 (D), U7715.9 (HS), U7715.13 (HS), U7715.14 (HS), U7715.16 (HS), U7715.21 (HS_DAP); also elsewhere on the board
unnamed: C7795.1, D7704.1 (K), U7713.12 (HB)
unnamed: C7800.1, D7705.1 (K), U7714.12 (HB)
unnamed: C7805.1, D7706.1 (K), U7715.12 (HB)
unnamed: Q7703.1 (G), U7713.10 (HO)
unnamed: Q7704.1 (G), U7713.8 (LO)
unnamed: Q7705.1 (G), U7714.10 (HO)
unnamed: Q7706.1 (G), U7714.8 (LO)
unnamed: Q7707.1 (G), U7715.10 (HO)
unnamed: Q7708.1 (G), U7715.8 (LO)
Veer: Q7703.3 (D), Q7703.5 (D), Q7705.3 (D), Q7705.5 (D), Q7707.3 (D), Q7707.5 (D); also elsewhere on the board

Notes on the sheet:
place top side between HB,HS
place top side between LMG1210 VDD,VSS pins

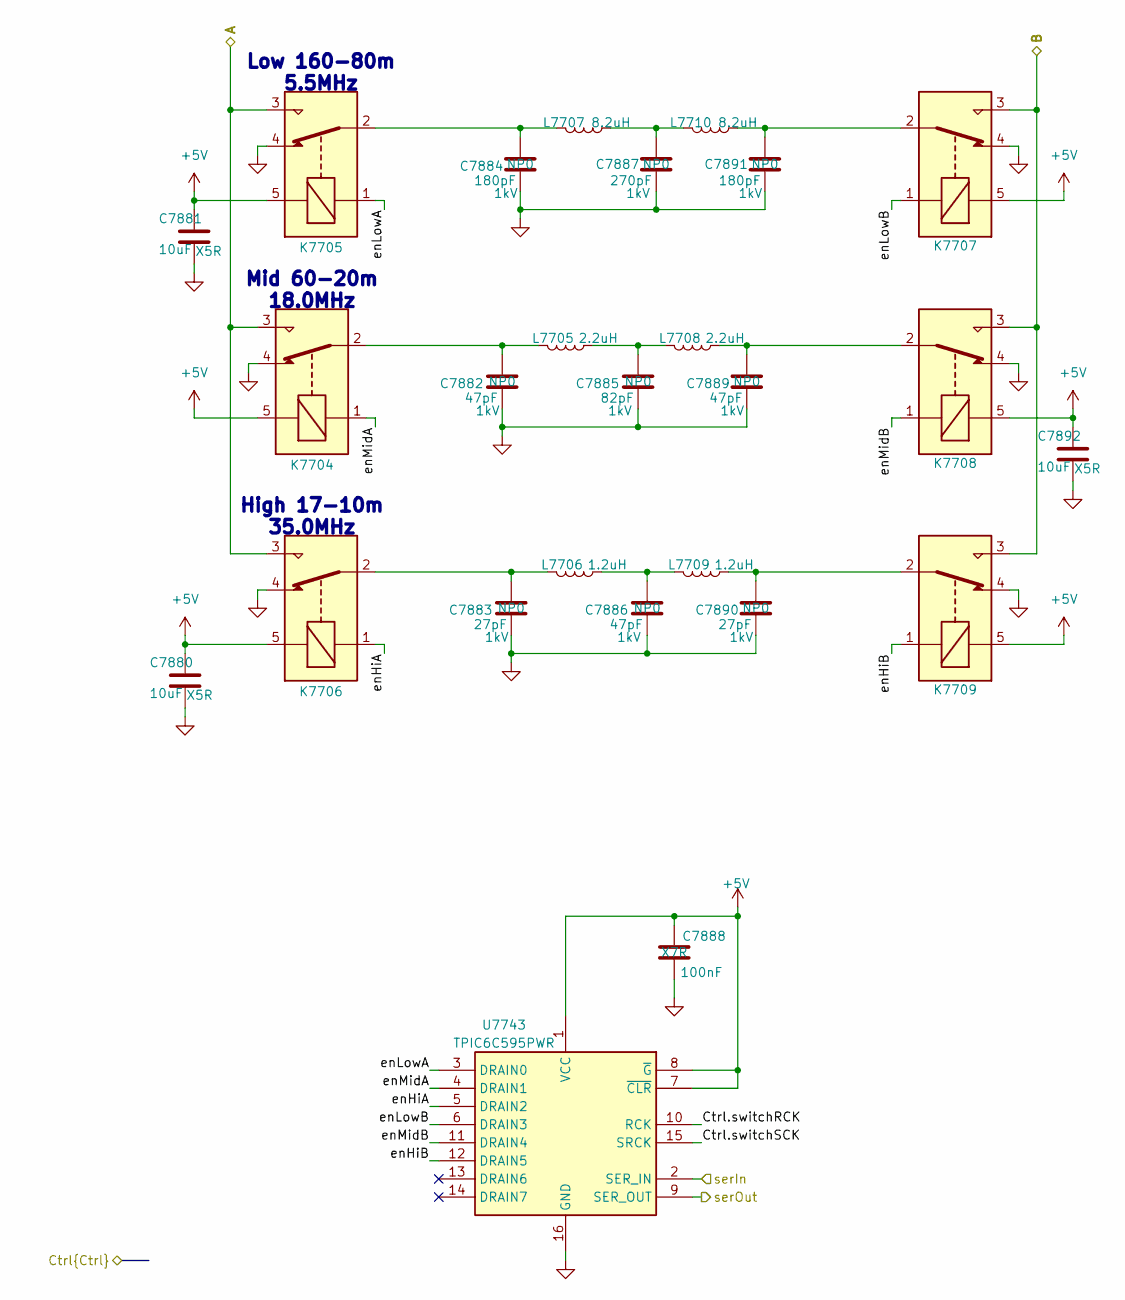
[picture p11: schematic tx-LPFs.kicad_sch, Transmit LPFs]

Parts:
C7880, C7881, C7892: 10uF; C_0603_1608Metric; Manufacturer_Part_Number 81-GXT155R71E223KE1D; Mouser Part Number 963-MLAST168BB5106MT
C7882, C7886, C7889: 47pF; C_0805_2012Metric; Manufacturer_Part_Number CC0805JRNPOCBN470; Mouser Part Number 603-CC0805JRCBN470
C7883, C7890: 27pF; C_0805_2012Metric; Manufacturer_Part_Number KGM21ECG3A270JU; Mouser Part Number 581-KGM21ECG3A270JU
C7884, C7891: 180pF; C_0805_2012Metric; Manufacturer_Part_Number C0805C181JDGACAUTO; Mouser Part Number 80-C0805C181JDGACATO
C7885: 82pF; C_0805_2012Metric; Manufacturer_Part_Number C0805C820JDGACTU; Mouser Part Number 80-C0805C820JDG
C7887: 270pF; C_0603_1608Metric; Manufacturer_Part_Number CGA3E2C0G1H271J080AA; Mouser Part Number 810-CGA3E2C0G1H271J
C7888: 100nF; C_0603_1608Metric; Manufacturer_Part_Number C0805F104K1RACAUTO; Mouser Part Number 80-C0805F104K1RAUTO
K7704, K7705, K7706, K7707, K7708, K7709: G5Q-14-05; Relay_SPDT_Omron-G5Q-1
L7705, L7708: 2.2uH; T68-toroid-1-rolling-tire
L7706, L7709: 1.2uH; T68-toroid-1-rolling-tire
L7707, L7710: 8.2uH; T68-toroid-1-rolling-tire
U7743: TPIC6C595PWR; SOP65P640X120-16N; Mouser Part Number 595-TPIC6C595PWR

Connections:
/FPGA/Ctrl.switchRCK: U7743.10 (RCK); also elsewhere on the board
/FPGA/Ctrl.switchSCK: U7743.15 (SRCK); also elsewhere on the board
/Tx Chain/Tx LPFs/enHiA: K7706.1, U7743.5 (DRAIN2)
/Tx Chain/Tx LPFs/enHiB: K7709.1, U7743.12 (DRAIN5)
/Tx Chain/Tx LPFs/enLowA: K7705.1, U7743.3 (DRAIN0)
/Tx Chain/Tx LPFs/enLowB: K7707.1, U7743.6 (DRAIN3)
/Tx Chain/Tx LPFs/enMidA: K7704.1, U7743.4 (DRAIN1)
/Tx Chain/Tx LPFs/enMidB: K7708.1, U7743.11 (DRAIN4)
/Tx Chain/Tx LPFs/serOut: U7743.9 (SER_OUT)
/Tx Chain/lpfB: K7707.3, K7708.3, K7709.3; also elsewhere on the board
/Tx Chain/tunerSerOut: U7743.2 (SER_IN); also elsewhere on the board
unnamed: C7882.1, K7704.2, L7705.1
unnamed: C7883.1, K7706.2, L7706.1
unnamed: C7884.1, K7705.2, L7707.1
unnamed: C7885.1, L7705.2, L7708.1
unnamed: C7886.1, L7706.2, L7709.1
unnamed: C7887.1, L7707.2, L7710.1
unnamed: C7889.1, K7708.2, L7708.2
unnamed: C7890.1, K7709.2, L7709.2
unnamed: C7891.1, K7707.2, L7710.2

Notes on the sheet:
High 17-10m 35.0MHz
Low 160-80m 5.5MHz
Mid 60-20m 18.0MHz

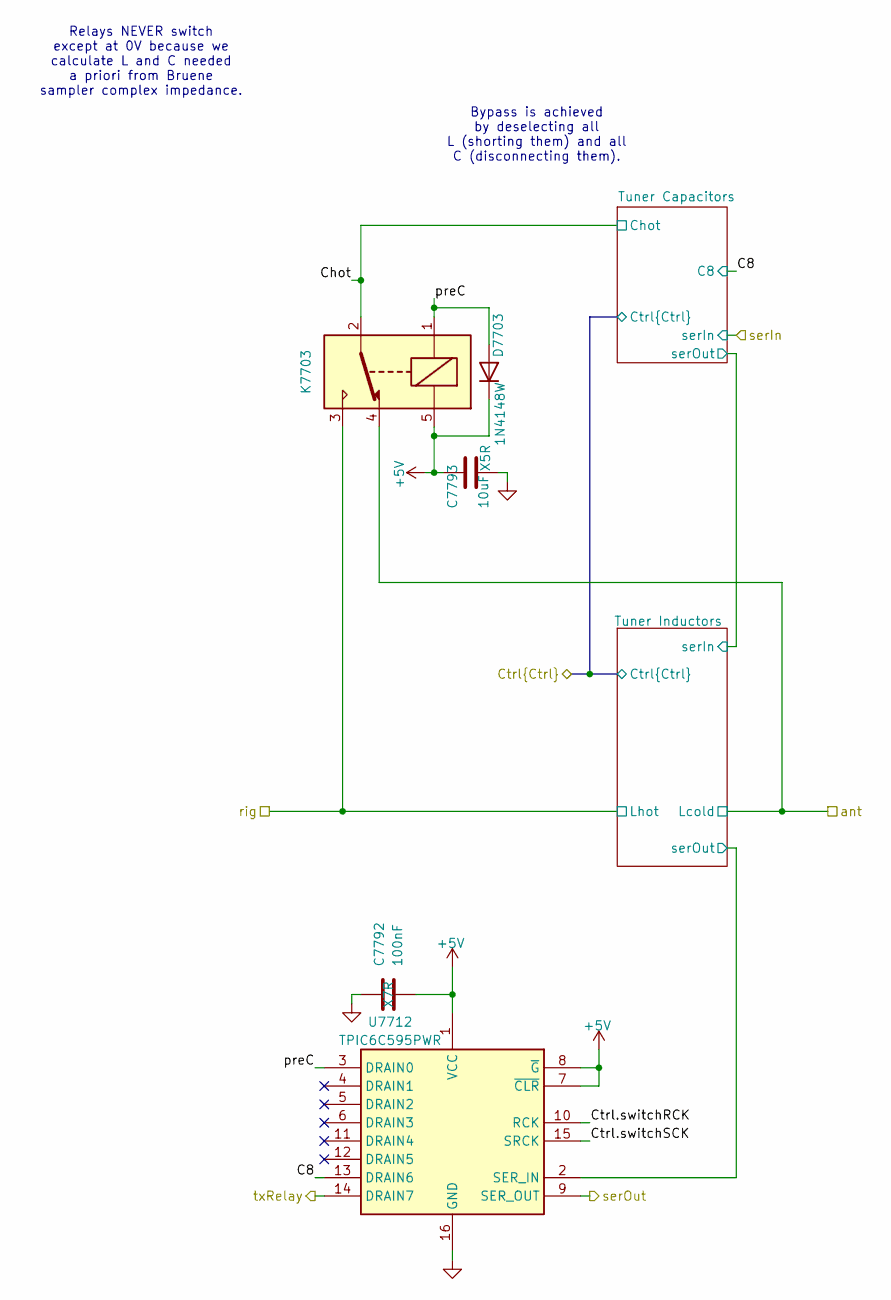
[picture p12: schematic ant-tuner.kicad_sch, Antenna Tuner]

Parts:
C7792: 100nF; C_0603_1608Metric; Manufacturer_Part_Number C0805F104K1RACAUTO; Mouser Part Number 80-C0805F104K1RAUTO
C7793: 10uF; C_0603_1608Metric; Manufacturer_Part_Number 81-GXT155R71E223KE1D; Mouser Part Number 963-MLAST168BB5106MT
D7703: 1N4148W; D_SOD-123
K7703: G5Q-14-05; Relay_SPDT_Omron-G5Q-1
U7712: TPIC6C595PWR; SOP65P640X120-16N; Mouser Part Number 595-TPIC6C595PWR

Connections:
/FPGA/Ctrl.switchRCK: U7712.10 (RCK); also elsewhere on the board
/FPGA/Ctrl.switchSCK: U7712.15 (SRCK); also elsewhere on the board
/Tx Chain/Antenna Tuner/C8: U7712.13 (DRAIN6)
/Tx Chain/Antenna Tuner/Chot: K7703.2; also elsewhere on the board
/Tx Chain/Antenna Tuner/Tuner Inductors/serOut: U7712.2 (SER_IN); also elsewhere on the board
/Tx Chain/Antenna Tuner/ant: K7703.4; also elsewhere on the board
/Tx Chain/Antenna Tuner/preC: D7703.2 (A), K7703.1, U7712.3 (DRAIN0)
/Tx Chain/Antenna Tuner/rig: K7703.3; also elsewhere on the board
/Tx Chain/tunerSerOut: U7712.9 (SER_OUT); also elsewhere on the board
/Tx Chain/txON: U7712.14 (DRAIN7); also elsewhere on the board

Notes on the sheet:
Relays NEVER switch except at 0V because we calculate L and C needed a priori from Bruene sampler complex impedance.
Bypass is achieved by deselecting all L (shorting them) and all C (disconnecting them).

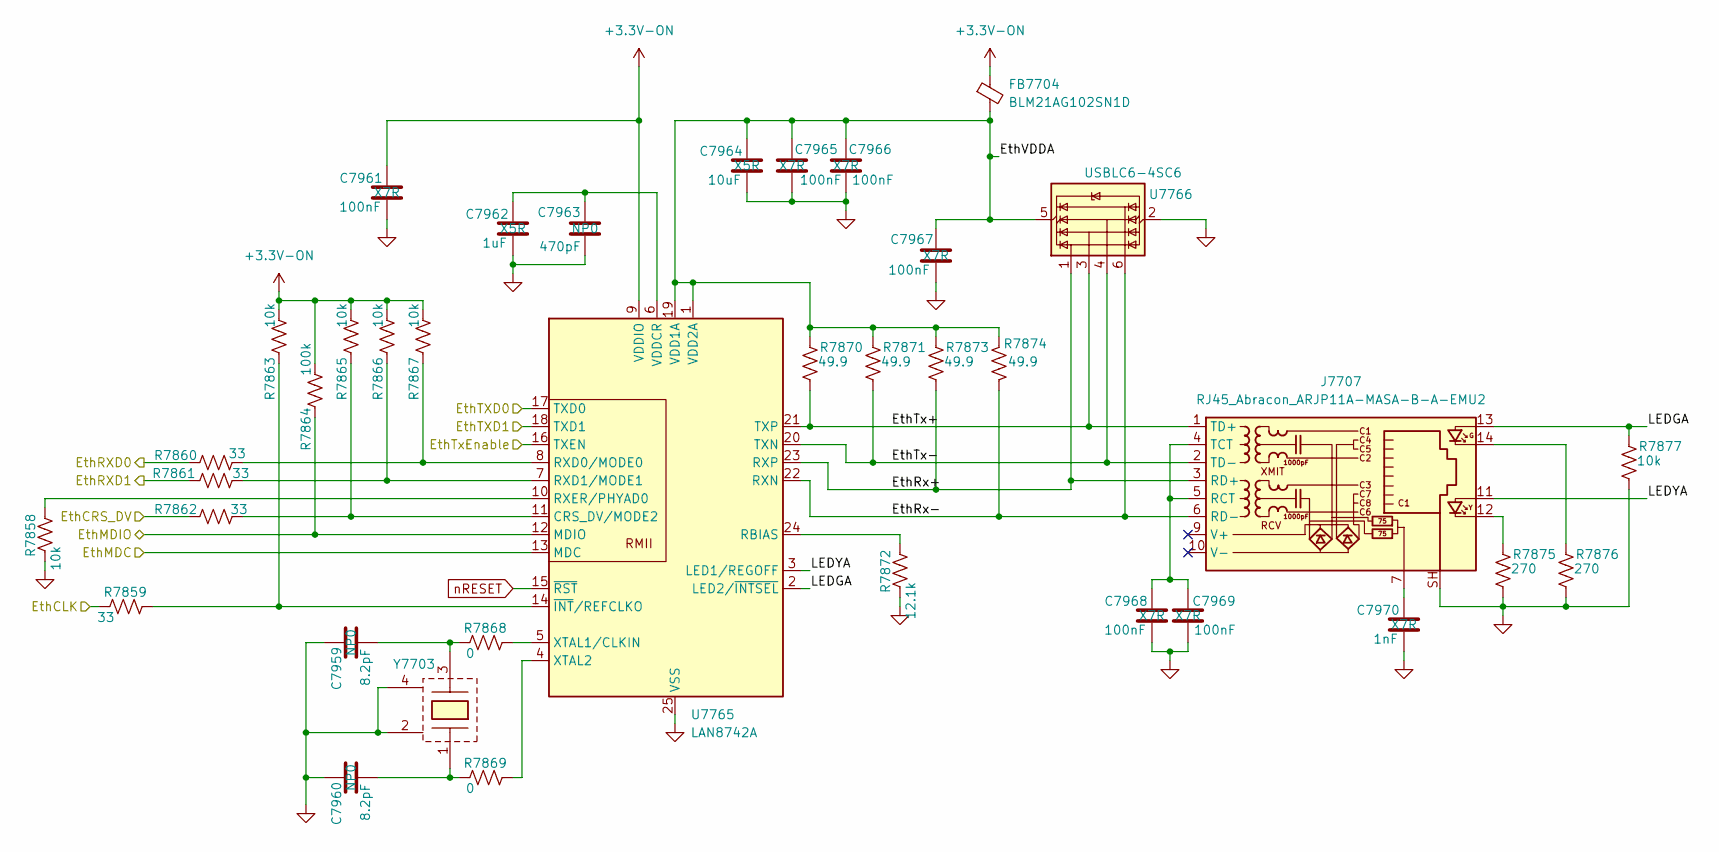
[picture p13: schematic ethernet.kicad_sch]

Parts:
C7959, C7960: 8.2pF; C_0402_1005Metric; Manufacturer_Part_Number GJM1555C1H8R2FB01D; Mouser Part Number 81-GJM1555C1H8R2FB1D
C7961, C7965, C7966, C7967, C7968, C7969: 100nF; C_0603_1608Metric; Manufacturer_Part_Number C0805F104K1RACAUTO; Mouser Part Number 80-C0805F104K1RAUTO
C7962: 1uF; C_0603_1608Metric; Manufacturer_Part_Number GRM155R61E105KE11D; Mouser Part Number 81-GRM155R61E105KE1D
C7963: 470pF; C_0603_1608Metric; Manufacturer_Part_Number C1608C0G1H471J080AA; Mouser Part Number 810-C1608C0G1H471J
C7964: 10uF; C_0603_1608Metric; Manufacturer_Part_Number 81-GXT155R71E223KE1D; Mouser Part Number 963-MLAST168BB5106MT
C7970: 1nF; C_0603_1608Metric; Manufacturer_Part_Number KAF15AR71H102KM; Mouser Part Number 581-KAF15AR71H102KM
FB7704: BLM21AG102SN1D; L_0805_2012Metric; MfgPart BLM21AG102SN1D
J7707: RJ45_Abracon_ARJP11A-MASA-B-A-EMU2; RJ45_Abracon_ARJP11A-MA_Horizontal
R7858, R7863, R7865, R7866, R7867, R7877: 10k; R_0402_1005Metric
R7859, R7860, R7861, R7862: 33; R_0603_1608Metric
R7864: 100k; R_0402_1005Metric
R7868, R7869: 0; R_0603_1608Metric
R7870, R7871, R7873, R7874: 49.9; R_0603_1608Metric
R7872: 12.1k; R_0603_1608Metric
R7875, R7876: 270; R_0805_2012Metric
U7765: LAN8742A; VQFN-24-1EP_4x4mm_P0.5mm_EP2.5x2.5mm_ThermalVias
U7766: USBLC6-4SC6; SOT-23-6
Y7703: ECS-250-8-37B2-RWN; ECS2033250BN; Mouser Part Number 520-2033-250-BN

Connections:
+3.3V-ON: C7961.1, FB7704.1, R7863.2, R7864.2, R7865.2, R7866.2, R7867.2, U7765.9 (VDDIO); also elsewhere on the board
/microcontroller/EthCLK: R7859.1; also elsewhere on the board
/microcontroller/EthCRS_DV: R7862.1; also elsewhere on the board
/microcontroller/EthMDC: U7765.13 (MDC); also elsewhere on the board
/microcontroller/EthMDIO: R7864.1, U7765.12 (MDIO); also elsewhere on the board
/microcontroller/EthRXD0: R7860.1; also elsewhere on the board
/microcontroller/EthRXD1: R7861.1; also elsewhere on the board
/microcontroller/EthTXD0: U7765.17 (TXD0); also elsewhere on the board
/microcontroller/EthTXD1: U7765.18 (TXD1); also elsewhere on the board
/microcontroller/EthTxEnable: U7765.16 (TXEN); also elsewhere on the board
/microcontroller/Ethernet/EthRx+: J7707.3 (RD+), R7873.2, U7765.23 (RXP), U7766.1 (I/O1)
/microcontroller/Ethernet/EthRx-: J7707.6 (RD-), R7874.2, U7765.22 (RXN), U7766.6 (I/O4)
/microcontroller/Ethernet/EthTx+: J7707.1 (TD+), R7870.2, U7765.21 (TXP), U7766.3 (I/O2)
/microcontroller/Ethernet/EthTx-: J7707.2 (TD-), R7871.2, U7765.20 (TXN), U7766.4 (I/O3)
/microcontroller/Ethernet/EthVDDA: C7964.1, C7965.1, C7966.1, C7967.1, FB7704.2, R7870.1, R7871.1, R7873.1, R7874.1, U7765.1 (VDD2A), U7765.19 (VDD1A), U7766.5 (VBUS)
/microcontroller/Ethernet/LEDGA: J7707.13, R7877.1, U7765.2 (LED2/~INTSEL)
/microcontroller/Ethernet/LEDYA: J7707.11, U7765.3 (LED1/REGOFF)
unnamed: C7959.2, R7868.1, Y7703.3
unnamed: C7960.2, R7869.1, Y7703.1
unnamed: C7970.1, J7707.7
unnamed: J7707.12, R7875.1
unnamed: J7707.14, R7876.1
unnamed: C7968.1, C7969.1, J7707.4 (TCT), J7707.5 (RCT)
unnamed: R7862.2, R7865.1, U7765.11 (CRS_DV/MODE2)
unnamed: R7872.2, U7765.24 (RBIAS)
unnamed: R7860.2, R7867.1, U7765.8 (RXD0/MODE0)
unnamed: R7861.2, R7866.1, U7765.7 (RXD1/MODE1)
unnamed: R7858.2, U7765.10 (RXER/PHYAD0)
unnamed: C7962.1, C7963.1, U7765.6 (VDDCR)
unnamed: R7868.2, U7765.5 (XTAL1/CLKIN)
unnamed: R7869.2, U7765.4 (XTAL2)
unnamed: R7859.2, R7863.1, U7765.14 (~INT/REFCLKO)
nRESET: U7765.15 (~RST); also elsewhere on the board
