alanmimms/nexrig/hw/NexRig.kicad_pcb

## KiCad design hw/NexRig.kicad_pcb (continued)

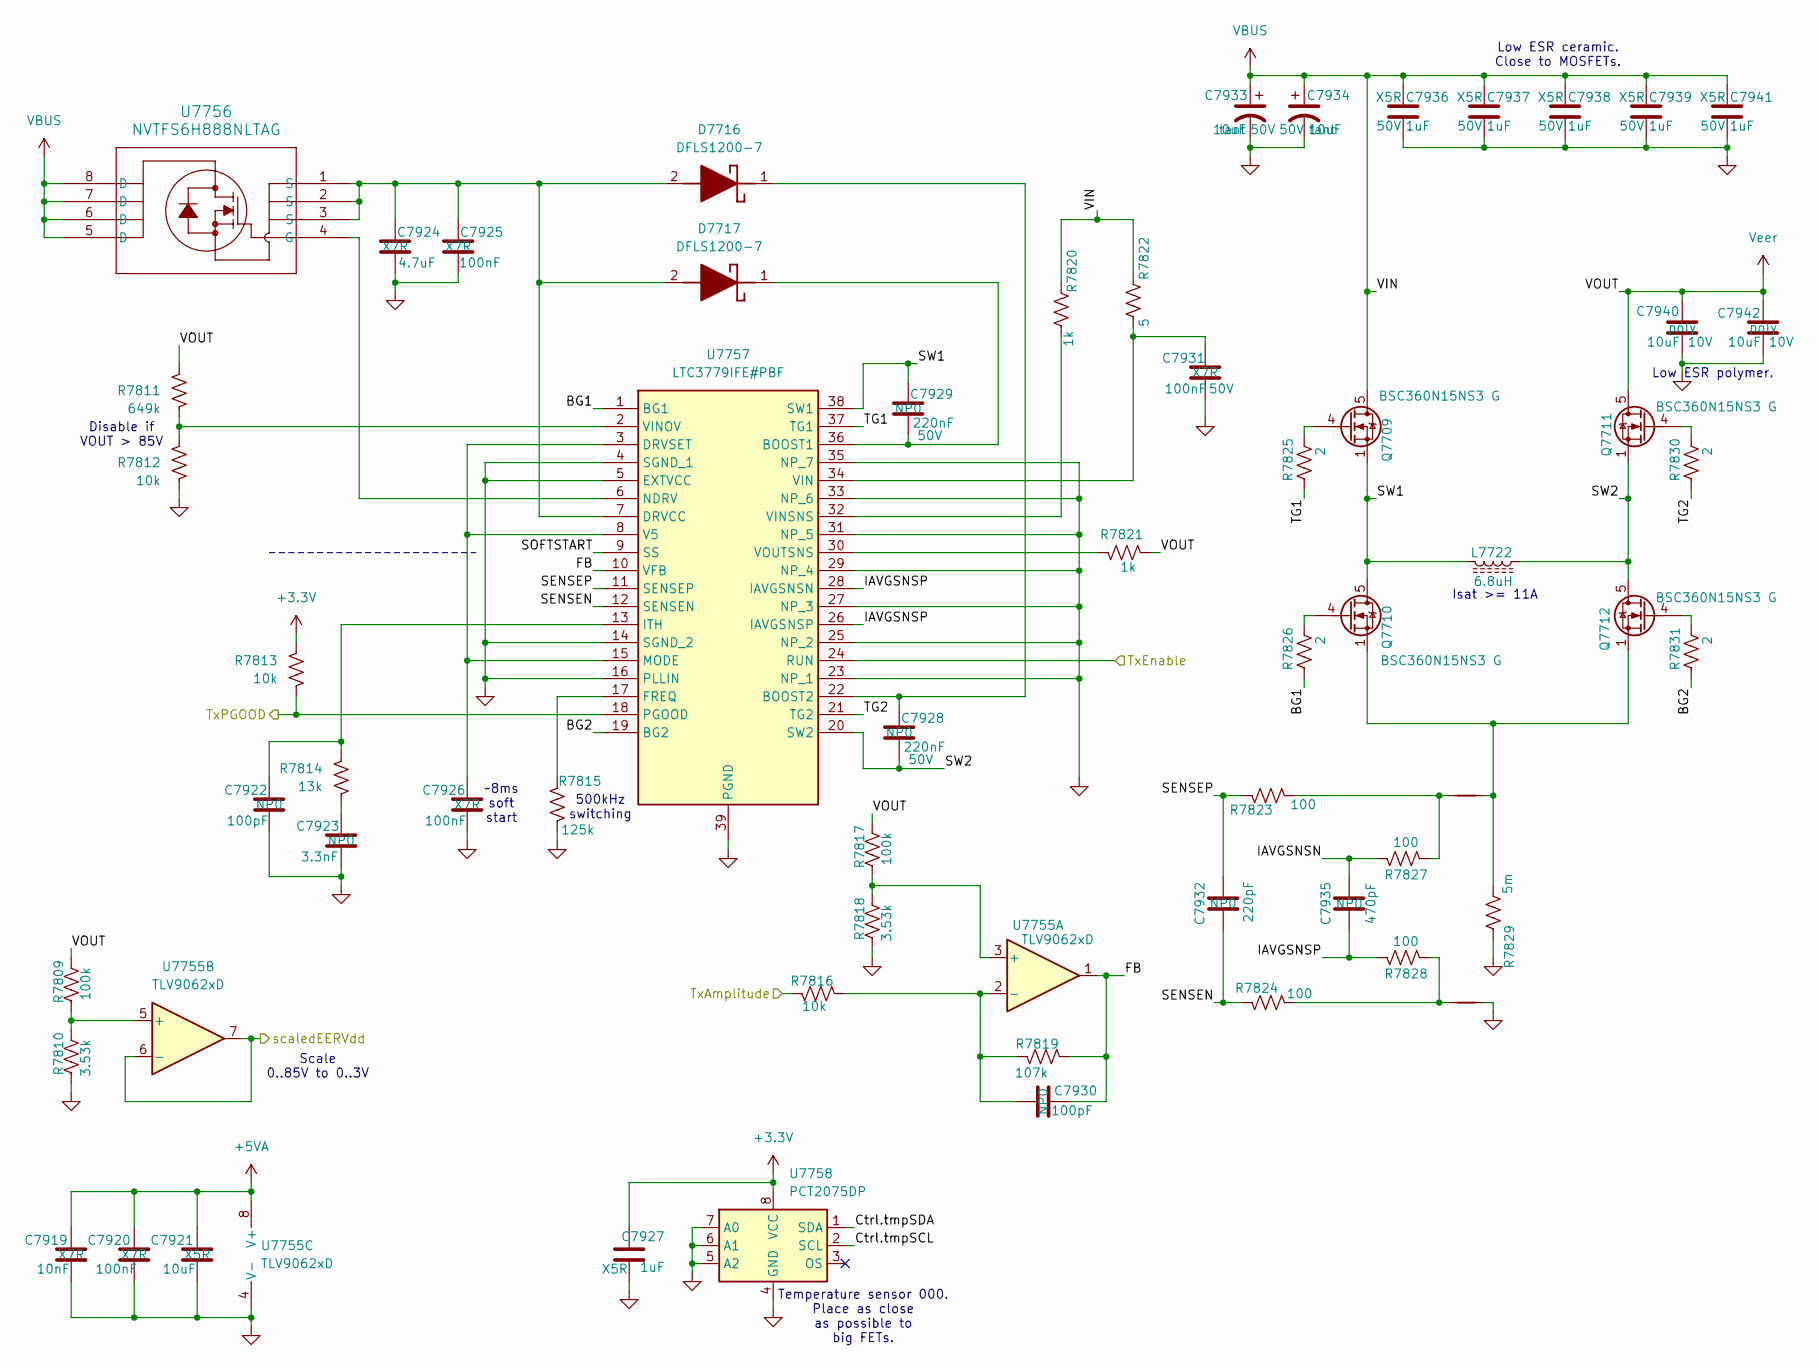
[picture p14: schematic eer-buckboost.kicad_sch, Tx Envelope Buck/Boost Converter]

Parts:
C7919: 10nF; C_0603_1608Metric; Manufacturer_Part_Number GCM1885C2A103JE02J; Mouser Part Number 81-GCM1885C2A103JE2J
C7920, C7925, C7926, C7931: 100nF; C_0603_1608Metric; Manufacturer_Part_Number C0805F104K1RACAUTO; Mouser Part Number 80-C0805F104K1RAUTO
C7921: 10uF; C_0603_1608Metric; Manufacturer_Part_Number 81-GXT155R71E223KE1D; Mouser Part Number 963-MLAST168BB5106MT
C7922, C7930: 100pF; C_0603_1608Metric; Manufacturer_Part_Number CGA3E2C0G1H101J080AE; Mouser Part Number 810-CGA3E2C0G1H101JA
C7923: 3.3nF; C_0603_1608Metric; Manufacturer_Part_Number C1608C0G1H332J080AE; Mouser Part Number 810-C1608C0G1H332J08
C7924: 4.7uF; C_0805_2012Metric; Manufacturer_Part_Number 08055D475KAT4A; Mouser Part Number 581-08055D475KAT4A
C7927: 1uF; C_0402_1005Metric; Manufacturer_Part_Number GRM155R61E105KE11D; Mouser Part Number 81-GRM155R61E105KE1D
C7928, C7929: 220nF; C_0603_1608Metric; Manufacturer_Part_Number C0603X224J5RACTU; Mouser Part Number 80-C0603X224J5RTU
C7932: 220pF; C_0603_1608Metric; Manufacturer_Part_Number C1608C0G1H221F080AA; Mouser Part Number 810-C1608C0G1H221F
C7933, C7934: 10uF; C_0805_2012Metric; Manufacturer_Part_Number TAJD106K050RNJ; Mouser Part Number 581-TAJD106K050R
C7935: 470pF; C_0603_1608Metric; Manufacturer_Part_Number C1608C0G1H471J080AA; Mouser Part Number 810-C1608C0G1H471J
C7936, C7937, C7938, C7939, C7941: 1uF; C_0603_1608Metric; Manufacturer_Part_Number GRM155R61E105KE11D; Mouser Part Number 81-GRM155R61E105KE1D
C7940, C7942: 10uF; C_1206_3216Metric; Manufacturer_Part_Number A759KS106M2CAAE110; Mouser Part Number 80-A759KS106M2CAE110
D7716, D7717: DFLS1200-7; DFLS12007; Mouser Part Number 621-DFLS1200-F
L7722: 6.8uH; Bourns PQ2614BLA-6R8K
NT7701, NT7702: NetTie_2; NetTie-2_SMD_Pad0.5mm
Q7709, Q7710, Q7711, Q7712: BSC360N15NS3 G; Infineon_PG-TDSON-8_6.15x5.15mm
R7809, R7817: 100k; R_0402_1005Metric
R7810, R7818: 3.53k; R_0603_1608Metric
R7811: 649k; R_0603_1608Metric
R7812, R7813, R7816: 10k; R_0402_1005Metric
R7814: 13k; R_0603_1608Metric
R7815: 125k; R_0603_1608Metric
R7819: 107k; R_0603_1608Metric
R7820, R7821: 1k; R_0603_1608Metric
R7822: 5; R_0603_1608Metric
R7823, R7824, R7827, R7828: 100; R_0603_1608Metric
R7825, R7826, R7830, R7831: 2; R_0603_1608Metric
R7829: 5m; CSS2H3920K5L00F; Mouser Part Number 652-CSS2H-3920K5L00F
U7755: TLV9062xD; SOIC-8_3.9x4.9mm_P1.27mm
U7756: NVTFS6H888NLTAG; WDFN_8NLTAG_ONS
U7757: LTC3779IFE#PBF; SOP50P640X120-39N; Mouser Part Number 584-LTC3779IFEPBF
U7758: PCT2075DP; TSSOP-8_3x3mm_P0.65mm

Connections:
+3.3V: C7927.1, R7813.1, U7758.8 (VCC); also elsewhere on the board
+5VA: C7919.1, C7920.1, C7921.1, U7755.8 (V+); also elsewhere on the board
/Power/Tx EER Envelope Buck-Boost/BG1: R7826.1, U7757.1 (BG1)
/Power/Tx EER Envelope Buck-Boost/BG2: R7831.1, U7757.19 (BG2)
/Power/Tx EER Envelope Buck-Boost/Ctrl.tmpSCL: U7758.2 (SCL)
/Power/Tx EER Envelope Buck-Boost/Ctrl.tmpSDA: U7758.1 (SDA)
/Power/Tx EER Envelope Buck-Boost/FB: C7930.2, R7819.2, U7755.1, U7757.10 (VFB)
/Power/Tx EER Envelope Buck-Boost/IAVGSNSN: C7935.2, R7827.1
/Power/Tx EER Envelope Buck-Boost/IAVGSNSP: C7935.1, R7828.1, U7757.26 (IAVGSNSP), U7757.28 (IAVGSNSN)
/Power/Tx EER Envelope Buck-Boost/SENSEN: C7932.1, R7824.1, U7757.12 (SENSEN)
/Power/Tx EER Envelope Buck-Boost/SENSEP: C7932.2, R7823.1, U7757.11 (SENSEP)
/Power/Tx EER Envelope Buck-Boost/SOFTSTART: U7757.9 (SS)
/Power/Tx EER Envelope Buck-Boost/SW1: C7929.1, L7722.1, Q7709.1 (S), Q7709.2 (S), Q7709.3 (S), Q7710.5 (D), U7757.38 (SW1)
/Power/Tx EER Envelope Buck-Boost/SW2: C7928.2, L7722.2, Q7711.1 (S), Q7711.2 (S), Q7711.3 (S), Q7712.5 (D), U7757.20 (SW2)
/Power/Tx EER Envelope Buck-Boost/TG1: R7825.1, U7757.37 (TG1)
/Power/Tx EER Envelope Buck-Boost/TG2: R7830.1, U7757.21 (TG2)
/Power/TxAmplitude: R7816.1; also elsewhere on the board
/Power/TxEnable: U7757.24 (RUN); also elsewhere on the board
/Power/TxPGOOD: R7813.2, U7757.18 (PGOOD); also elsewhere on the board
/Power/scaledEERVdd: U7755.6 (-), U7755.7; also elsewhere on the board
unnamed: C7923.1, R7814.2
unnamed: C7924.1, C7925.1, D7716.2 (A), D7717.2 (A), U7756.1 (S), U7756.2 (S), U7756.3 (S), U7757.7 (DRVCC)
unnamed: C7928.1, D7716.1 (K), U7757.22 (BOOST2)
unnamed: C7929.2, D7717.1 (K), U7757.36 (BOOST1)
unnamed: NT7701.1, R7823.2, R7827.2
unnamed: NT7701.2, Q7710.1 (S), Q7710.2 (S), Q7710.3 (S), Q7712.1 (S), Q7712.2 (S), Q7712.3 (S), R7829.2
unnamed: NT7702.1, R7824.2, R7828.2
unnamed: Q7709.4 (G), R7825.2
unnamed: Q7710.4 (G), R7826.2
unnamed: Q7711.4 (G), R7830.2
unnamed: Q7712.4 (G), R7831.2
unnamed: R7817.1, R7818.2, U7755.3 (+)
unnamed: C7930.1, R7816.2, R7819.1, U7755.2 (-)
unnamed: R7809.1, R7810.2, U7755.5 (+)
unnamed: U7756.4 (G), U7757.6 (NDRV)
unnamed: C7926.1, U7757.3 (DRVSET), U7757.8 (V5), U7757.15 (MODE)
unnamed: R7815.1, U7757.17 (FREQ)
unnamed: C7922.1, R7814.1, U7757.13 (ITH)
unnamed: C7931.2, R7822.2, U7757.34 (VIN)
unnamed: R7811.2, R7812.1, U7757.2 (VINOV)
unnamed: R7820.2, U7757.32 (VINSNS)
unnamed: R7821.1, U7757.30 (VOUTSNS)
VBUS: C7933.1, C7934.1, C7936.1, C7937.1, C7938.1, C7939.1, C7941.1, Q7709.5 (D), R7820.1, R7822.1, U7756.5 (D), U7756.6 (D), U7756.7 (D), U7756.8 (D); also elsewhere on the board
Veer: C7940.1, C7942.1, Q7711.5 (D), R7809.2, R7811.1, R7817.2, R7821.2; also elsewhere on the board

Notes on the sheet:
500kHz switching
Low ESR ceramic. Close to MOSFETs.
Scale 0..85V to 0..3V
Disable if VOUT > 85V
Isat >= 11A
~8ms soft start
Temperature sensor 000. Place as close as possible to big FETs.
Low ESR polymer.

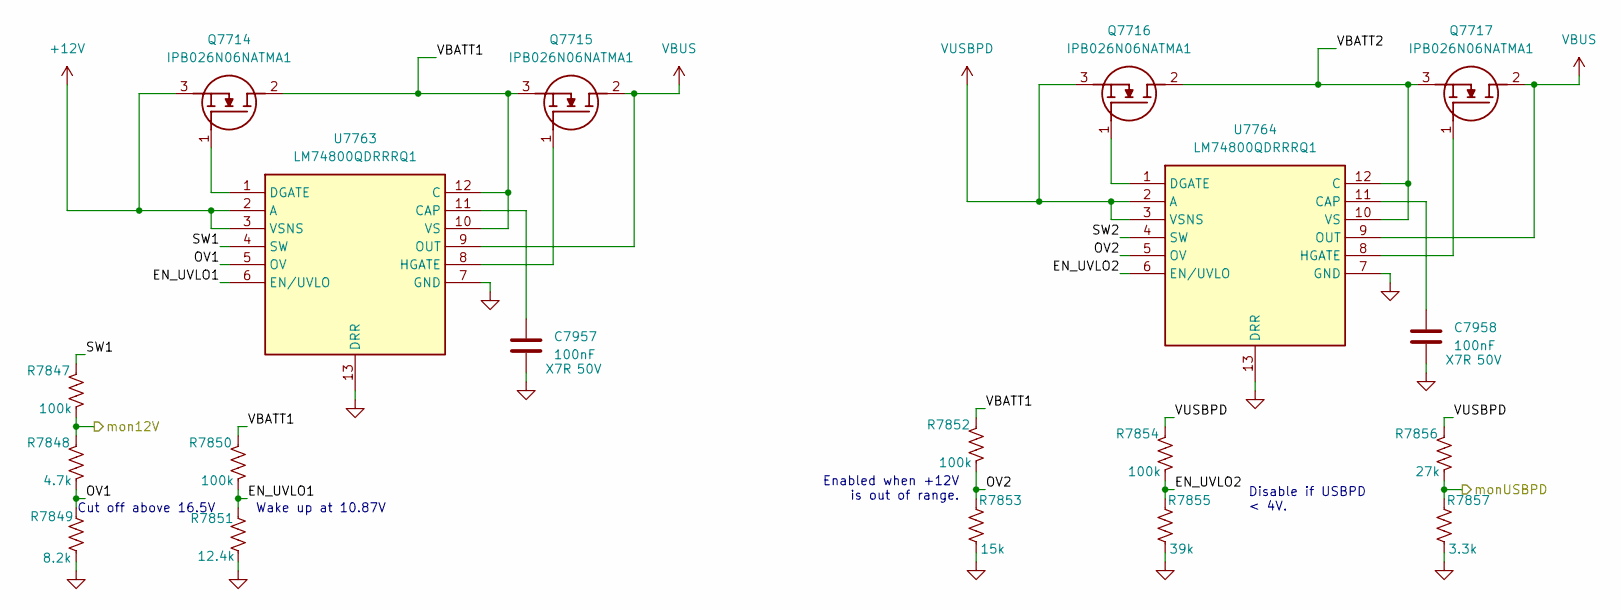
[picture p15: schematic power-priority.kicad_sch, Power Priority Switching]

Parts:
C7957, C7958: 100nF; C_0603_1608Metric; Manufacturer_Part_Number C0805F104K1RACAUTO; Mouser Part Number 80-C0805F104K1RAUTO
Q7714, Q7715, Q7716, Q7717: IPB026N06NATMA1; Mouser Part Number 726-IPB026N06NATMA1
R7847, R7850, R7852, R7854: 100k; R_0402_1005Metric
R7848: 4.7k; R_0603_1608Metric
R7849: 8.2k; R_0603_1608Metric
R7851: 12.4k; R_0603_1608Metric
R7853: 15k; R_0603_1608Metric
R7855: 39k; R_0603_1608Metric
R7856: 27k; R_0603_1608Metric
R7857: 3.3k; R_0603_1608Metric
U7763, U7764: LM74800QDRRRQ1; SON50P300X300X80-13N; Mouser Part Number 595-LM74800QDRRRQ1

Connections:
+12V: Q7714.3 (S), U7763.2 (A), U7763.3 (VSNS); also elsewhere on the board
/Power/Power Priority/EN_UVLO1: R7850.2, R7851.1, U7763.6 (EN/UVLO)
/Power/Power Priority/EN_UVLO2: R7854.2, R7855.1, U7764.6 (EN/UVLO)
/Power/Power Priority/OV1: R7848.2, R7849.1, U7763.5 (OV)
/Power/Power Priority/OV2: R7852.2, R7853.1, U7764.5 (OV)
/Power/Power Priority/SW1: R7847.1, U7763.4 (SW)
/Power/Power Priority/SW2: U7764.4 (SW)
/Power/Power Priority/VBATT1: Q7714.2 (D), Q7715.3 (S), R7850.1, R7852.1, U7763.10 (VS), U7763.12 (C)
/Power/Power Priority/VBATT2: Q7716.2 (D), Q7717.3 (S), U7764.10 (VS), U7764.12 (C)
/Power/mon12V: R7847.2, R7848.1; also elsewhere on the board
/Power/monUSBPD: R7856.2, R7857.1; also elsewhere on the board
unnamed: Q7714.1 (G), U7763.1 (DGATE)
unnamed: Q7715.1 (G), U7763.8 (HGATE)
unnamed: Q7716.1 (G), U7764.1 (DGATE)
unnamed: Q7717.1 (G), U7764.8 (HGATE)
unnamed: C7957.1, U7763.11 (CAP)
unnamed: C7958.1, U7764.11 (CAP)
VBUS: Q7715.2 (D), Q7717.2 (D), U7763.9 (OUT), U7764.9 (OUT); also elsewhere on the board
VUSBPD: Q7716.3 (S), R7854.1, R7856.1, U7764.2 (A), U7764.3 (VSNS); also elsewhere on the board

Notes on the sheet:
Cut off above 16.5V
Wake up at 10.87V
Disable if USBPD < 4V.
Enabled when +12V is out of range.

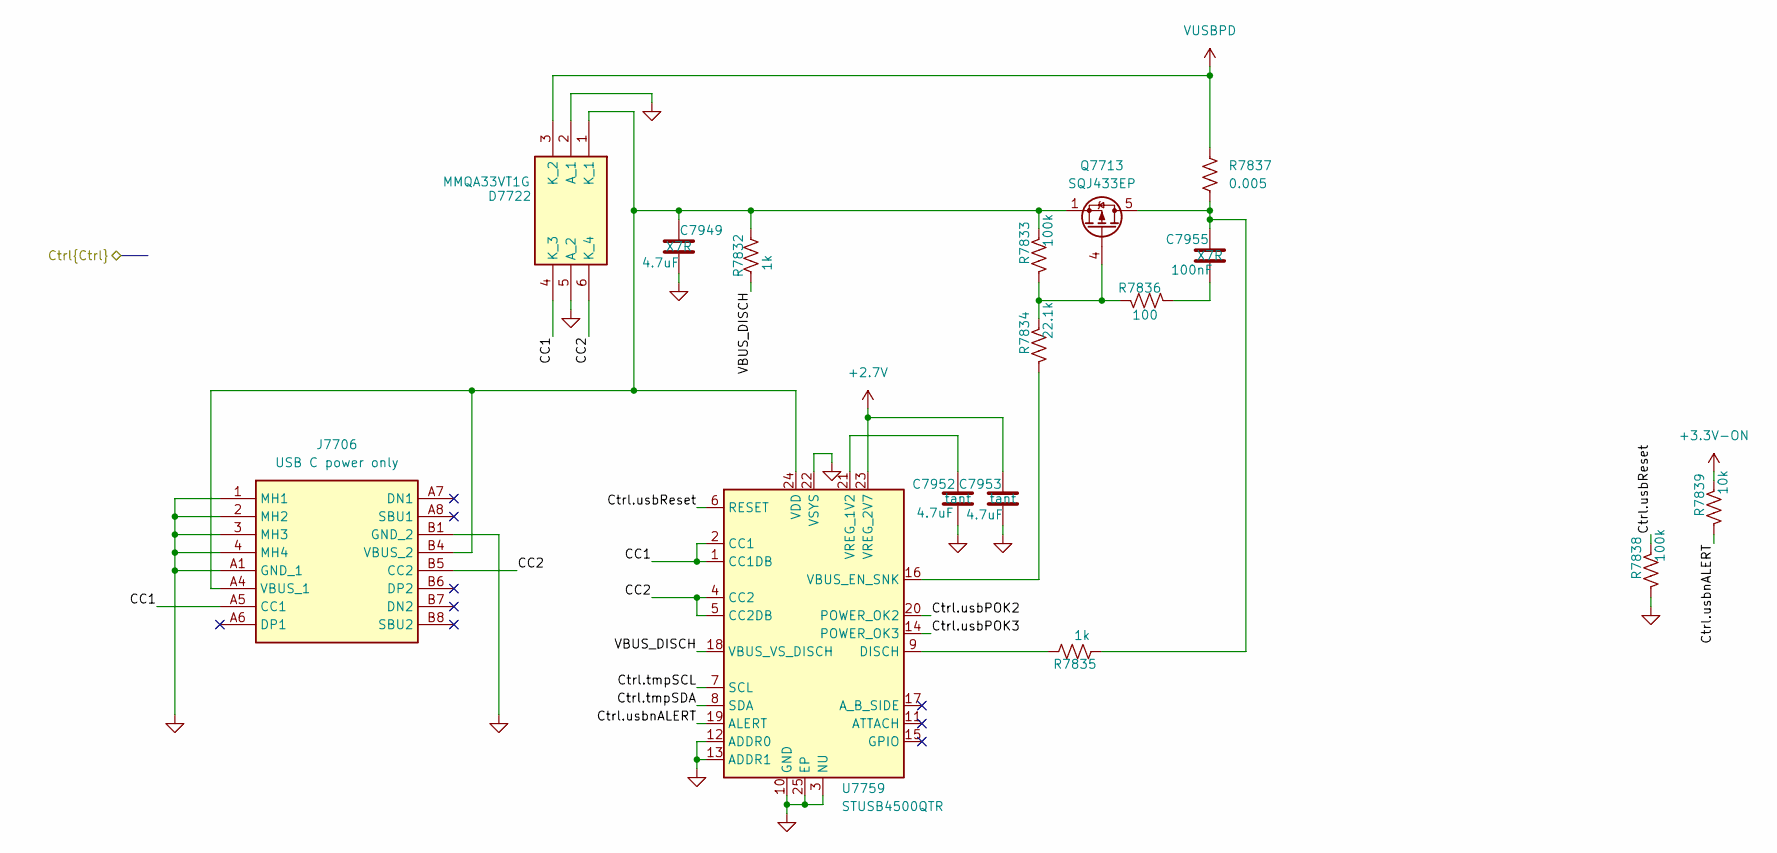
[picture p16: schematic usb-pd.kicad_sch]

Parts:
C7949: 4.7uF; C_0805_2012Metric; Manufacturer_Part_Number 08055D475KAT4A; Mouser Part Number 581-08055D475KAT4A
C7952, C7953: 4.7uF; C_0805_2012Metric; Manufacturer_Part_Number 298D475X9010M2T; Mouser Part Number 74-298D475X9010M2T
C7955: 100nF; C_0603_1608Metric; Manufacturer_Part_Number C0805F104K1RACAUTO; Mouser Part Number 80-C0805F104K1RAUTO
D7722: MMQA33VT1G; SC-74-6_1.55x2.9mm_P0.95mm; Mouser Part Number 863-MMQA33VT1G
J7706: USB C power only; UJ20CHGMSMT4P16TR; Mouser Part Number 179-UJ20CHGMSMT4P16T
Q7713: SQJ433EP; PowerPAK_SO-8L_Single
R7832, R7835: 1k; R_0603_1608Metric
R7833, R7838: 100k; R_0402_1005Metric
R7834: 22.1k; R_0603_1608Metric
R7836: 100; R_0603_1608Metric
R7837: 0.005; R_0612_1632Metric
R7839: 10k; R_0402_1005Metric
U7759: STUSB4500QTR; QFN-24-1EP_4x4mm_P0.5mm_EP2.7x2.7mm

Connections:
+2.7V: C7953.1, U7759.23 (VREG_2V7)
+3.3V-ON: R7839.1; also elsewhere on the board
/FPGA/Ctrl.tmpSCL: U7759.7 (SCL); also elsewhere on the board
/FPGA/Ctrl.tmpSDA: U7759.8 (SDA); also elsewhere on the board
/FPGA/Ctrl.usbPOK2: U7759.20 (POWER_OK2); also elsewhere on the board
/FPGA/Ctrl.usbPOK3: U7759.14 (POWER_OK3); also elsewhere on the board
/FPGA/Ctrl.usbReset: R7838.1, U7759.6 (RESET)
/FPGA/Ctrl.usbnALERT: R7839.2, U7759.19 (ALERT); also elsewhere on the board
/Power/USB-PD/CC1: D7722.4 (K_3), J7706.A5 (CC1), U7759.1 (CC1DB), U7759.2 (CC1)
/Power/USB-PD/CC2: D7722.6 (K_4), J7706.B5 (CC2), U7759.4 (CC2), U7759.5 (CC2DB)
/Power/USB-PD/VBUS_DISCH: R7832.2, U7759.18 (VBUS_VS_DISCH)
unnamed: C7955.2, R7836.2
unnamed: C7949.1, D7722.1 (K_1), J7706.A4 (VBUS_1), J7706.B4 (VBUS_2), Q7713.1 (S), Q7713.2 (S), Q7713.3 (S), R7832.1, R7833.1, U7759.24 (VDD)
unnamed: C7955.1, Q7713.5 (D), R7835.2, R7837.2
unnamed: Q7713.4 (G), R7833.2, R7834.1, R7836.1
unnamed: R7835.1, U7759.9 (DISCH)
unnamed: R7834.2, U7759.16 (VBUS_EN_SNK)
unnamed: C7952.1, U7759.21 (VREG_1V2)
VUSBPD: D7722.3 (K_2), R7837.1; also elsewhere on the board

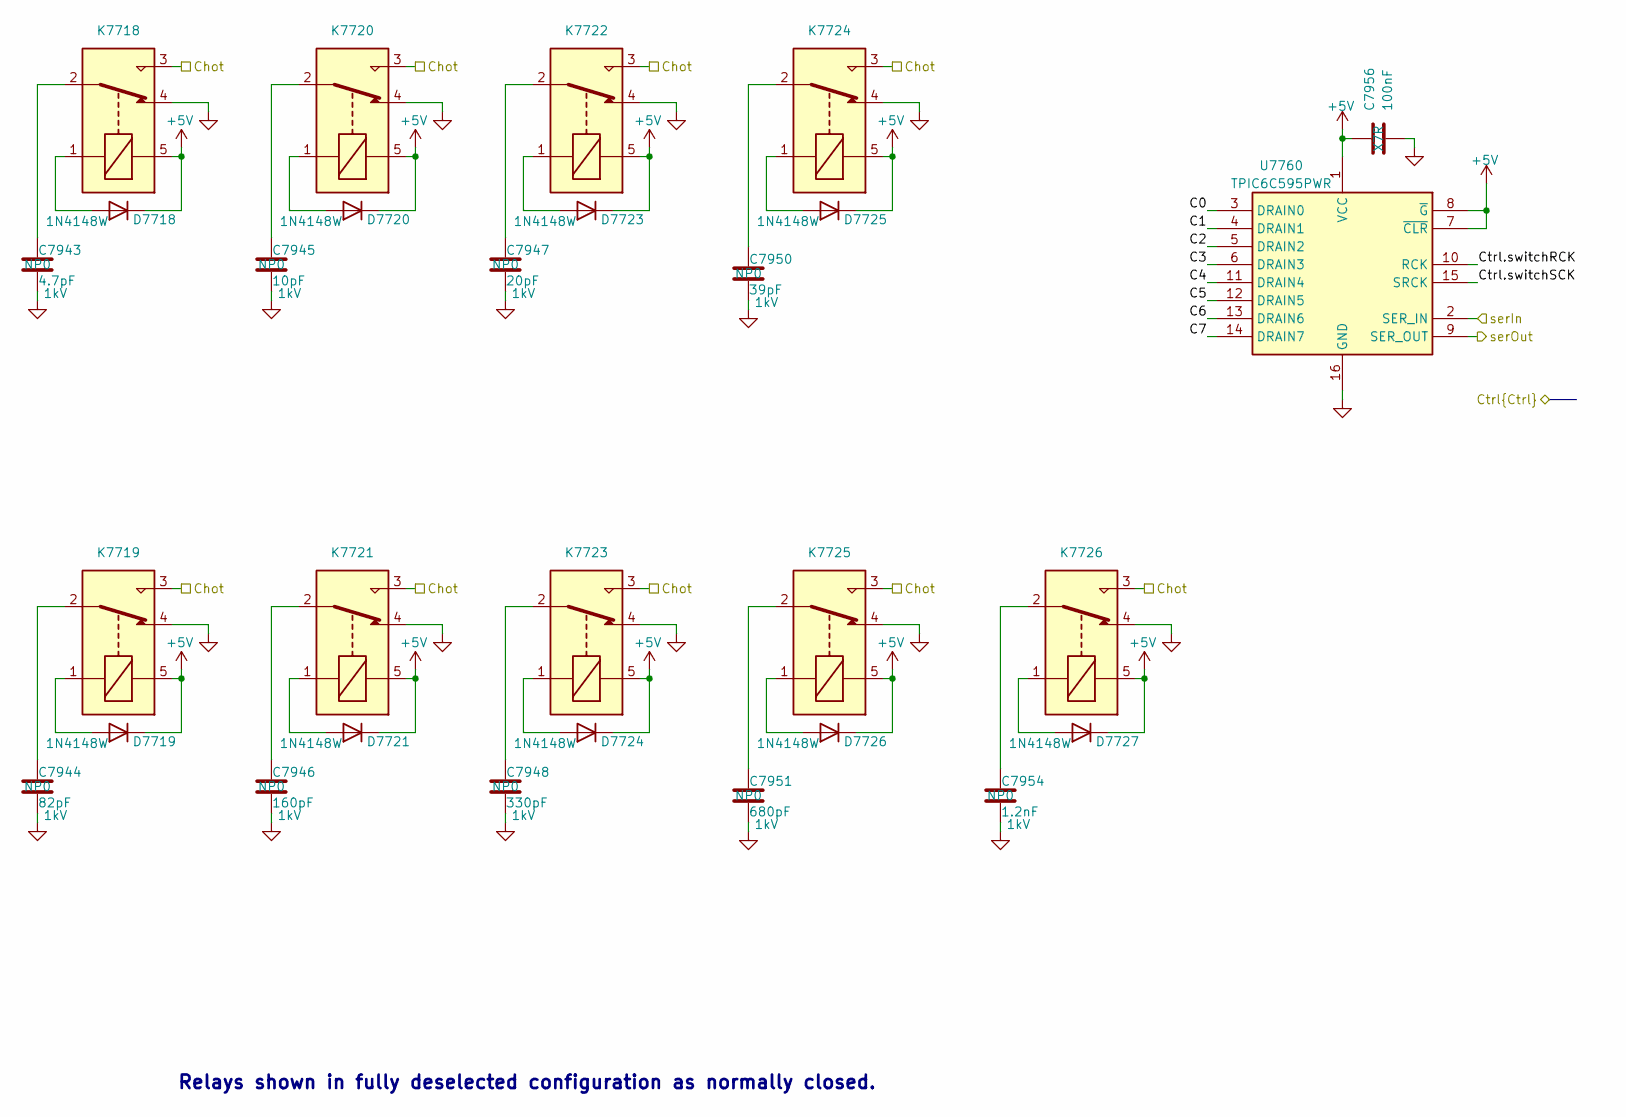
[picture p17: schematic tuner-caps.kicad_sch, Antenna Tuner Capacitors]

Parts:
C7943: 4.7pF; C_0805_2012Metric; Manufacturer_Part_Number 0805Y1K04P70DCT; Mouser Part Number 766-0805Y1K04P70DCT
C7944: 82pF; C_0805_2012Metric; Manufacturer_Part_Number C0805C820JDGACTU; Mouser Part Number 80-C0805C820JDG
C7945: 10pF; C_1206_3216Metric; Manufacturer_Part_Number CC0805JRNPOCBN100; Mouser Part Number 603-CC0805JRNPOCBN10
C7946: 160pF; C_0805_2012Metric; Manufacturer_Part_Number C0805C161GDGACAUTO; Mouser Part Number 80-C0805C161GDGACATO
C7947: 20pF; C_1206_3216Metric; Manufacturer_Part_Number CC1206JKNPOCBN200; Mouser Part Number 603-CC1206JNPOCBN200
C7948: 330pF; C_1206_3216Metric; Manufacturer_Part_Number CC1206JKNPOCBN331; Mouser Part Number 603-CC126JKNPOCBN331
C7950: 39pF; C_1206_3216Metric; Manufacturer_Part_Number CC1206JKNPOCBN390; Mouser Part Number 603-CC1206JKCBN390
C7951: 680pF; C_1206_3216Metric; Manufacturer_Part_Number CC1206JKNPOCBN681; Mouser Part Number 603-CC126JKNPOCBN681
C7954: 1.2nF; C_1210_3225Metric; Manufacturer_Part_Number CGA6M1C0G3A122J200AC; Mouser Part Number 810-CGA6M1C0G3A1J2A
C7956: 100nF; C_0603_1608Metric; Manufacturer_Part_Number C0805F104K1RACAUTO; Mouser Part Number 80-C0805F104K1RAUTO
D7718, D7719, D7720, D7721, D7723, D7724, D7725, D7726, D7727: 1N4148W; D_SOD-123
K7718, K7719, K7720, K7721, K7722, K7723, K7724, K7725, K7726: G5Q-14-05; Relay_SPDT_Omron-G5Q-1
U7760: TPIC6C595PWR; SOP65P640X120-16N; Mouser Part Number 595-TPIC6C595PWR

Connections:
/FPGA/Ctrl.switchMOSI: U7760.2 (SER_IN); also elsewhere on the board
/FPGA/Ctrl.switchRCK: U7760.10 (RCK); also elsewhere on the board
/FPGA/Ctrl.switchSCK: U7760.15 (SRCK); also elsewhere on the board
/Tx Chain/Antenna Tuner/Chot: K7718.3, K7719.3, K7720.3, K7721.3, K7722.3, K7723.3, K7724.3, K7725.3, K7726.3; also elsewhere on the board
/Tx Chain/Antenna Tuner/Tuner Capacitors/C0: U7760.3 (DRAIN0)
/Tx Chain/Antenna Tuner/Tuner Capacitors/C1: U7760.4 (DRAIN1)
/Tx Chain/Antenna Tuner/Tuner Capacitors/C2: U7760.5 (DRAIN2)
/Tx Chain/Antenna Tuner/Tuner Capacitors/C3: U7760.6 (DRAIN3)
/Tx Chain/Antenna Tuner/Tuner Capacitors/C4: U7760.11 (DRAIN4)
/Tx Chain/Antenna Tuner/Tuner Capacitors/C5: U7760.12 (DRAIN5)
/Tx Chain/Antenna Tuner/Tuner Capacitors/C6: U7760.13 (DRAIN6)
/Tx Chain/Antenna Tuner/Tuner Capacitors/C7: U7760.14 (DRAIN7)
/Tx Chain/Antenna Tuner/Tuner Capacitors/serOut: U7760.9 (SER_OUT); also elsewhere on the board
unnamed: C7943.1, K7718.2
unnamed: C7944.1, K7719.2
unnamed: C7945.1, K7720.2
unnamed: C7946.1, K7721.2
unnamed: C7947.1, K7722.2
unnamed: C7948.1, K7723.2
unnamed: C7950.1, K7724.2
unnamed: C7951.1, K7725.2
unnamed: C7954.1, K7726.2
unnamed: D7718.2 (A), K7718.1
unnamed: D7719.2 (A), K7719.1
unnamed: D7720.2 (A), K7720.1
unnamed: D7721.2 (A), K7721.1
unnamed: D7723.2 (A), K7722.1
unnamed: D7724.2 (A), K7723.1
unnamed: D7725.2 (A), K7724.1
unnamed: D7726.2 (A), K7725.1
unnamed: D7727.2 (A), K7726.1

Notes on the sheet:
Relays shown in fully deselected configuration as normally closed.

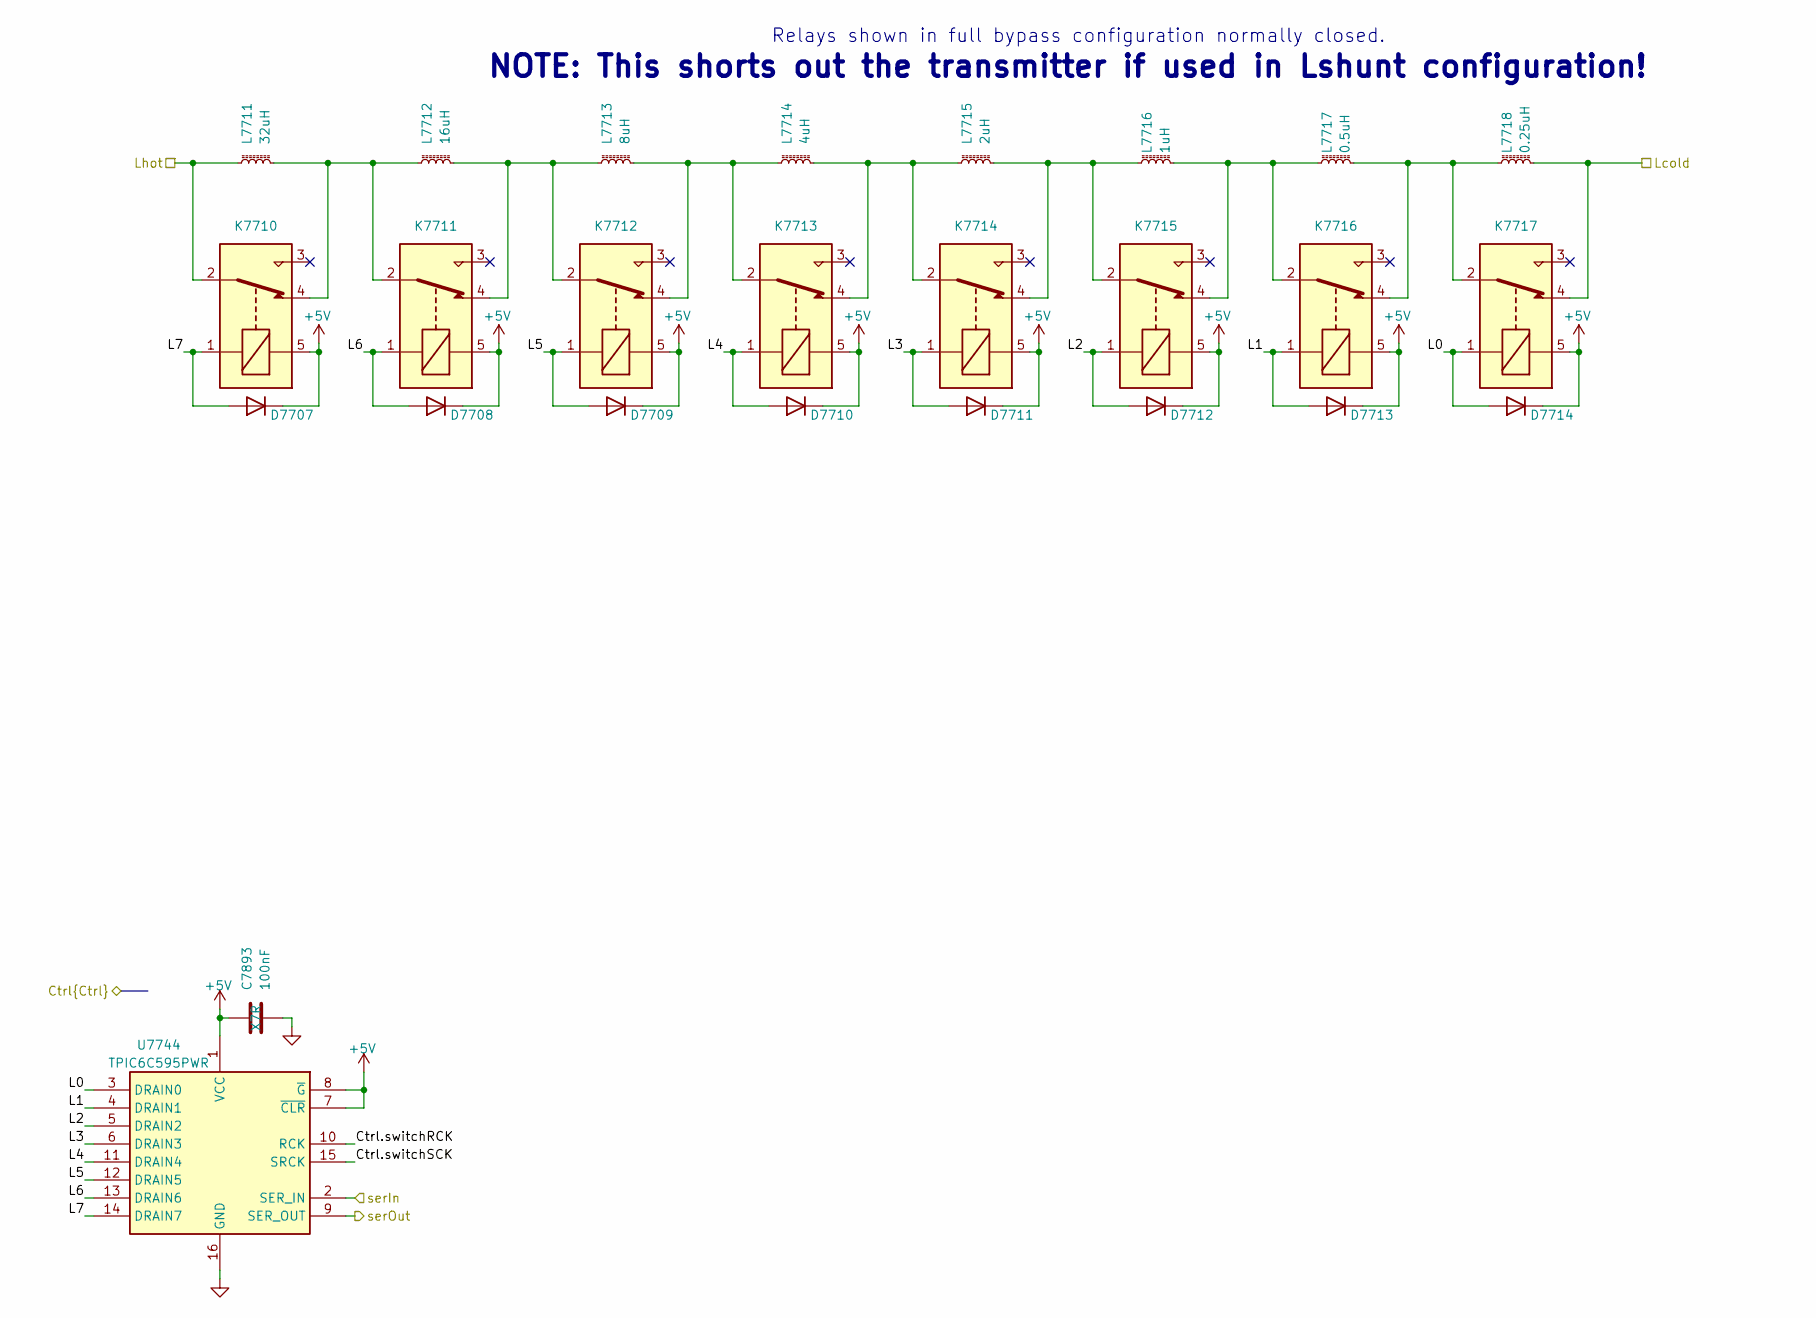
[picture p18: schematic tuner-inductors.kicad_sch, Antenna Tuner Inductors]

Parts:
C7893: 100nF; C_0603_1608Metric; Manufacturer_Part_Number C0805F104K1RACAUTO; Mouser Part Number 80-C0805F104K1RAUTO
D7707, D7708, D7709, D7710, D7711, D7712, D7713, D7714: 1N4148W; D_SOD-123
K7710, K7711, K7712, K7713, K7714, K7715, K7716, K7717: G5Q-14-05; Relay_SPDT_Omron-G5Q-1
L7711: 32uH; T130-toroid-1-rolling-tire
L7712: 16uH; T106-toroid-1-rolling-tire
L7713: 8uH; T80-toroid-1-rolling-tire
L7714: 4uH; T80-toroid-1-rolling-tire
L7715: 2uH; T68-toroid-1-rolling-tire
L7716: 1uH; T50-toroid-1-rolling-tire
L7717: 0.5uH; T50-toroid-1-rolling-tire
L7718: 0.25uH; T50-toroid-1-rolling-tire
U7744: TPIC6C595PWR; SOP65P640X120-16N; Mouser Part Number 595-TPIC6C595PWR

Connections:
/FPGA/Ctrl.switchRCK: U7744.10 (RCK); also elsewhere on the board
/FPGA/Ctrl.switchSCK: U7744.15 (SRCK); also elsewhere on the board
/Tx Chain/Antenna Tuner/Tuner Capacitors/serOut: U7744.2 (SER_IN); also elsewhere on the board
/Tx Chain/Antenna Tuner/Tuner Inductors/L0: D7714.2 (A), K7717.1, U7744.3 (DRAIN0)
/Tx Chain/Antenna Tuner/Tuner Inductors/L1: D7713.2 (A), K7716.1, U7744.4 (DRAIN1)
/Tx Chain/Antenna Tuner/Tuner Inductors/L2: D7712.2 (A), K7715.1, U7744.5 (DRAIN2)
/Tx Chain/Antenna Tuner/Tuner Inductors/L3: D7711.2 (A), K7714.1, U7744.6 (DRAIN3)
/Tx Chain/Antenna Tuner/Tuner Inductors/L4: D7710.2 (A), K7713.1, U7744.11 (DRAIN4)
/Tx Chain/Antenna Tuner/Tuner Inductors/L5: D7709.2 (A), K7712.1, U7744.12 (DRAIN5)
/Tx Chain/Antenna Tuner/Tuner Inductors/L6: D7708.2 (A), K7711.1, U7744.13 (DRAIN6)
/Tx Chain/Antenna Tuner/Tuner Inductors/L7: D7707.2 (A), K7710.1, U7744.14 (DRAIN7)
/Tx Chain/Antenna Tuner/Tuner Inductors/serOut: U7744.9 (SER_OUT); also elsewhere on the board
/Tx Chain/Antenna Tuner/ant: K7717.4, L7718.2; also elsewhere on the board
/Tx Chain/Antenna Tuner/rig: K7710.2, L7711.1; also elsewhere on the board
unnamed: K7710.4, K7711.2, L7711.2, L7712.1
unnamed: K7711.4, K7712.2, L7712.2, L7713.1
unnamed: K7712.4, K7713.2, L7713.2, L7714.1
unnamed: K7713.4, K7714.2, L7714.2, L7715.1
unnamed: K7714.4, K7715.2, L7715.2, L7716.1
unnamed: K7715.4, K7716.2, L7716.2, L7717.1
unnamed: K7716.4, K7717.2, L7717.2, L7718.1

Notes on the sheet:
NOTE: This shorts out the transmitter if used in Lshunt configuration!
Relays shown in full bypass configuration normally closed.

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
Board: 6 copper layers, 664 parts (0 on the bottom side), 494 nets, no tracks yet.

Other parts of the board:
K7702: TQ2-5V-functional; RELAY_TQ2_PAN
R7722: 220; R_0603_1608Metric

Their connections:
/Rx Front End/RxZ200: K7702.3 (T1); also elsewhere on the board
/Tx Chain/txON: K7702.10 (COIL-); also elsewhere on the board
unnamed 312: R7722.1; also elsewhere on the board
