alanmimms/nexrig/fw/fw.ioc

Mcu.UserName=STM32H753ZITx
PA1.GPIO_Label=EthCLK
PA1.Signal=ETH_REF_CLK
PA11.GPIO_Label=TxEnable
PA11.Signal=GPIO_Output
PA2.GPIO_Label=EthMDIO
PA2.Signal=ETH_MDIO
PA4.GPIO_Label=TxAmplitude
PA4.Signal=COMP_DAC11_group
PA5.GPIO_Label=Ctrl.tuneSCK
PA5.Signal=SPI6_SCK
PA6.GPIO_Label=Ctrl_audioReset
PA6.Signal=GPIO_Output
PA7.GPIO_Label=EthCRS_DV
PA7.Signal=ETH_CRS_DV
PA8.Signal=GPIO_Analog
PA9.GPIO_Label=monUSBPD
PA9.Signal=GPIO_Analog
PB10.GPIO_Label=Ctrl_switchSCK
PB10.Signal=SPI2_SCK
PB11.GPIO_Label=EthTxEnable
PB11.Signal=ETH_TX_EN
PB12.GPIO_Label=EthTXD0
PB12.Signal=ETH_TXD0
PB13.GPIO_Label=EthTXD1
PB13.Signal=ETH_TXD1
PB2.GPIO_Label=Ctrl.qsdData
PB2.Signal=SAI1_SD_A
PB6.GPIO_Label=Ctrl_tmpSCL
PB6.Signal=I2C1_SCL
PB7.GPIO_Label=Ctrl_tmpSDA
PB7.Signal=I2C1_SDA
PC0.GPIO_Label=Ctrl_enable5V
PC0.Signal=GPIO_Output
PC1.GPIO_Label=EthMDC
PC1.Signal=ETH_MDC
PC10.GPIO_Label=FPGA_SCK
PC10.Signal=SPI3_SCK
PC11.GPIO_Label=FPGA_MISO
PC11.Signal=SPI3_MISO
PC12.GPIO_Label=FPGA_MOSI
PC12.Signal=SPI3_MOSI
PC3_C.GPIO_Label=Ctrl_switchMOSI
PC3_C.Signal=SPI2_MOSI
PC4.GPIO_Label=EthRXD0
PC4.Signal=ETH_RXD0
PC5.GPIO_Label=EthRXD1
PC5.Signal=ETH_RXD1
PC6.GPIO_Label=TxPGOOD
PC6.Signal=GPIO_Input
PC8.GPIO_Label=Ctrl_bruene
PC8.Signal=GPIO_Output
PD12.GPIO_Label=Ctrl_audioSCL
PD12.Signal=I2C4_SCL
PD7.GPIO_Label=dispMOSI
PD7.Signal=SPI1_MOSI
PE0.GPIO_Label=CDONE
PE0.Signal=GPIO_Input
PE10.GPIO_Label=Ctrl_atten3dB
PE10.Signal=GPIO_Output
PE11.GPIO_Label=Ctrl.qsdNSS
PE11.Signal=SPI4_NSS
PE12.GPIO_Label=dispRESET
PE12.Signal=GPIO_Output
PE13.GPIO_Label=dispDC
PE13.Signal=GPIO_Output
PE15.GPIO_Label=FPGA.RESET
PE15.Signal=GPIO_Output
PE2.GPIO_Label=Ctrl.qsdSCK
PE2.Signal=SPI4_SCK
PE3.GPIO_Label=Ctrl.txData
PE3.Signal=SAI1_SD_B
PE4.GPIO_Label=Ctrl.qsdWCLK
PE4.Signal=SAI1_FS_A
PE5.GPIO_Label=Ctrl.qsdBCLK
PE5.Signal=SAI1_SCK_A
PE6.GPIO_Label=Ctrl.qsdMOSI
PE6.Signal=SPI4_MOSI
PE7.GPIO_Label=Ctrl_atten24dB
PE7.Signal=GPIO_Output
PE8.GPIO_Label=Ctrl_atten12dB
PE8.Signal=GPIO_Output
PE9.GPIO_Label=Ctrl_atten6dB
PE9.Signal=GPIO_Output
PF0.Signal=GPIO_Output
PF1.GPIO_Label=Ctrl.enable3V3
PF1.Signal=GPIO_Output
PF10.GPIO_Label=Ctrl_usbPOK2
PF10.Signal=GPIO_Input
PF11.GPIO_Label=Ctrl.usbPOK3
PF11.Signal=GPIO_Input
PF12.GPIO_Label=scaledEERVdd
PF12.Signal=ADC1_INP6
PF13.GPIO_Label=Ctrl.switchRCK
PF13.Signal=GPIO_Output
PF14.Signal=GPIO_Input
PF15.GPIO_Label=Ctrl_audioSDA
PF15.Signal=I2C4_SDA
PF2.GPIO_Label=Ctrl.enable5V
PF2.Signal=GPIO_Output
PF3.GPIO_Label=Ctrl.enable3VA
PF3.Signal=GPIO_Output
PF4.GPIO_Label=Ctrl.enable5VA
PF4.Signal=GPIO_Output
PF5.GPIO_Label=Ctrl.enableFPGA1V2
PF5.Signal=GPIO_Output
PF6.GPIO_Label=Ctrl.enableFPGAIO
PF6.Signal=GPIO_Output
PF7.GPIO_Label=Ctrl.txMCLK
PF7.Signal=SAI1_MCLK_B
PF8.GPIO_Label=Ctrl.txBCLK
PF8.Signal=SAI1_SCK_B
PF9.GPIO_Label=Ctrl.txWCLK
PF9.Signal=SAI1_FS_B
PG10.GPIO_Label=dispNSS
PG10.Signal=SPI1_NSS
PG11.GPIO_Label=dispSCK
PG11.Signal=SPI1_SCK
PG14.GPIO_Label=Ctrl.tuneMOSI
PG14.Signal=SPI6_MOSI
PG15.GPIO_Label=Ctrl.tuneRCK
PG15.Signal=GPIO_Output
PG8.GPIO_Label=Ctrl.tuneNSS
PG8.Signal=SPI6_NSS
