alanmimms/nexrig/(commit log)

2025-03-23 Checkpoint as hierarchical schematic is starting to grow
    [USB-SSB-exciter.kicad_sch, USB-SSB-txcvr.kicad_pcb, USB-SSB-txcvr.kicad_sch, VFO.kicad_sch, ant.kicad_sch, microcontroller.kicad_sch, rx-demod.kicad_sch, rx-signal-chain.kicad_sch]
2025-03-24 Hierarchy is mostly done?
    [USB-SSB-txcvr.kicad_sch, VFO.kicad_sch, ant.kicad_sch, microcontroller.kicad_sch, rx-demod.kicad_sch, rx-signal-chain.kicad_sch, tx-signal-chain.kicad_sch]
2025-03-24 Reorg into hardware, software, and firmware directories
    [USB-SSB-txcvr.kicad_pcb, USB-SSB-txcvr.kicad_sch, VFO.kicad_sch, ant.kicad_sch, microcontroller.kicad_sch, rx-demod.kicad_sch, rx-signal-chain.kicad_sch, tuning-dac.kicad_sch]
2025-03-24 Starting design of RF front end and demod
    [USB-SSB-txcvr.kicad_sch, VFO.kicad_sch, ant.kicad_sch, microcontroller.kicad_sch, rx-demod.kicad_sch, rx-signal-chain.kicad_sch, tx-signal-chain.kicad_sch]
2025-03-25 Rx path is getting closer. Differential LO outputs from VFO. Clean up.
    [USB-SSB-txcvr.kicad_sch, VFO.kicad_sch, ant.kicad_sch, microcontroller.kicad_sch, rx-demod.kicad_sch, rx-signal-chain.kicad_sch, tuning-dac.kicad_sch, tx-signal-chain.kicad_sch]
2025-03-26 Checkpoint. More of rx path done. VFOs are now LVDS. Starting USB and power.
    [USB-SSB-txcvr.kicad_sch, VFO.kicad_sch, ant.kicad_sch, microcontroller.kicad_sch, power.kicad_sch, rx-demod.kicad_sch, rx-signal-chain.kicad_sch, tuning-dac.kicad_sch]
2025-03-26 Restructure power and USB sheets a bit. Generate each power rail we need so far from USB VBUS, but still need to control VBUS input with TI USBPD chip. Set up USB2 data net class and power and GND ne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
    [USB-SSB-txcvr.kicad_sch, VFO.kicad_sch, ant.kicad_sch, microcontroller.kicad_sch, power.kicad_sch, rx-demod.kicad_sch, rx-signal-chain.kicad_sch, tuning-dac.kicad_sch]
2025-03-27 Checkpoint. Starting to try building firmware.
    [USB-SSB-txcvr.kicad_sch, microcontroller.kicad_sch]
2025-03-28 Now properly printf and blinky LEDs. Working on getting USB to talk but not working yet
    [fw.ioc]
2025-07-26 Checkpoint before resuming project
    [ChebyshevLP-30MHz-0.5dB-50ohms.ods, VFO.kicad_sch, filtersim.kicad_pcb, filtersim.kicad_sch, microcontroller.kicad_sch, rx-signal-chain.kicad_sch, tuning-dac.kicad_sch, usb.kicad_sch]
2025-08-11 Working on multi-band BPF and switching
    [BPF-values.csv, BPF.kicad_sch, USB-SSB-txcvr.kicad_sch, VFO.kicad_sch, ant.kicad_sch, microcontroller.kicad_sch, rx-demod.kicad_sch, rx-signal-chain.kicad_sch]
2025-08-24 Starting to build BPFs for 7 bands
    [BPF.kicad_sch, VFO.kicad_sch, ant.kicad_sch, front-end-sim.kicad_sch, frontend-sim.kicad_sch, microcontroller.kicad_sch, rx-demod.kicad_sch, rx-signal-chain.kicad_sch]
2025-08-28 Filter calc checkpoint
    [BPF.kicad_sch, band-plan.csv, frontend-sim.kicad_sch, rx-signal-chain.kicad_sch, test.kicad_sch]
2025-08-28 Checkpoint with a newer version that seems to produce more accurate results
    [test.kicad_sch]
2025-08-28 MUCH better Chebyshev response but high end still a bit off (too high)
    [test.kicad_sch]
2025-08-29 Fixed BPF design with proper Chebyshev response and bandwidth control
    - transformer-coupled-three-tank-bpf-minimal-fix.py: Final working version
    - Uses 90% bandwidth compensation to achieve target bandwidth
    - Maintains original 0.65 factor and g-values that produce Chebyshev ripple
    - Generated band1.mod through band7.mod for all 7 amateur bands
    - Band 5 (20m: 13.5-18.5 MHz) verified with proper 0.1dB ripple
    - Ready for multi-band BPF simulation in KiCad
    [test.kicad_sch]
2025-09-07 Getting closer to having all (ten) BPFs designed. Maybe I can try some layout next.
    [BPF.kicad_sch, VFO.kicad_sch, frontend-sim.kicad_sch, microcontroller.kicad_sch, rx-signal-chain.kicad_sch, test.kicad_sch, tx-signal-chain.kicad_sch, usb.kicad_sch]
2025-09-11 Checkpoint hardware. Add README with some notes about software services we need to create.
    [BPF-values.csv, BPF.kicad_sch, DAC.kicad_sch, USB-SSB-txcvr.kicad_sch, VFO.kicad_sch, ant.kicad_sch, band-plan.csv, microcontroller.kicad_sch]
2025-09-11 Checkpoint more hardware, add more notes
    [power-high-side-switch.kicad_sch, power.kicad_sch]
2025-09-11 Add STM32 clock, more notes
    [USB-SSB-txcvr.kicad_sch, microcontroller.kicad_sch, rx-signal-chain.kicad_sch]
2025-09-15 Add NOTES for summarizing the transmitter architecture. Starting to work on PIN switches more intently, and building a simulation model for the EER buck regulator and FPGA NCO phase modulator.
    [BPF.kicad_sch, DAC.kicad_sch, eer-model.sch]
2025-09-16 Starting to generate DSP output for SSB two tone signal so I can simulate EER tx chain
2025-09-17 Checkpoint. Starting to design buck/boost converter for EER power
    [USB-SSB-txcvr.kicad_sch]
2025-09-17 Oops. Import from Altium took out my entire schematic! reverting
    [USB-SSB-txcvr.kicad_sch, power.kicad_sch]
2025-09-18 Making some progress on PIN diode bias boost converter. Page number reorg.
    [BPF.kicad_sch, DAC.kicad_sch, PIN-bias-boost.kicad_sch, USB-SSB-txcvr.kicad_sch, ant.kicad_sch, eer-buckboost.kicad_sch, microcontroller.kicad_sch, power.kicad_sch]
2025-09-23 Add complete project structure for NexRig SDR transceiver
    - FPGA: SystemVerilog NCO for Class E PA phase generation with camelCase naming
    - Firmware: C++20/Zephyr structure with REST API, hardware abstraction (moved old to fw-attic)
    - Software: Browser app HTML/JS framework with modern UI components
    - Mock Server: Node.js development server with realistic I/Q streams and REST API simulation
    - All code follows camelCase conventions (gFoo for globals, no snake_case)
    Ready for hardware-less development and testing of browser interface.
2025-09-23 Add browser-based SSB demodulation with Web Audio API
    - Implement complete DSP pipeline for SSB demodulation using Hilbert transforms
    - Generate realistic USB two-tone test signals (700Hz/1900Hz standard)
    - Fix phase continuity and audio scheduling for glitch-free playback
    - Add WebSocket I/Q streaming with 24-bit 96kS/s format
    - Enable audio only on user gesture (Chrome autoplay compliance)
    - Add nodemon for auto-reload during development
    - Fix mode API error from audio button click
    The browser app now successfully demodulates I/Q streams and outputs
    clean SSB audio through the Web Audio API.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
2025-09-25 Fix SDR audio buffer management and starvation cycles
    Major improvements to AudioWorklet buffer handling:
    • Implement audio-driven buffer management - AudioWorklet process() callback is
    now the master clock driving I/Q data consumption at exactly 48kHz
    • Add minimum buffer threshold (1024 samples) to prevent starvation cycles that
    were causing intermittent silence after initial audio
    • Replace broken fractional resampler with simple 2:1 decimation that properly
    consumes buffer samples without getting stuck
    • Add frequency shifting for tuning functionality using complex multiplication
    • Improve AGC with slower attack/decay and higher starting gain (5.0 vs 1.0)
    • Add co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
2025-09-26 Starting to do bandpass filtering. LSB is not yet working, but USB does. CW is working a bit but not right yet
2025-09-26 Better filtering. Getting closer to CW and LSB properly filtering. DRY for DSP filter parameters
2025-09-30 Add EER tank calculations stuff
    [PIN-bias-boost.kicad_sch, eer-tank-tables.csv]
2025-10-01 Added by mistake
    [eer-tank-tables.csv]
2025-10-01 Starting to dev the LC tanks for the power MOSFET output stage.
    [pa-tanks.kicad_sch, tx-LPFs.kicad_sch, tx-signal-chain.kicad_sch]
2025-10-03 Getting closer to having the PA LC tank switching done
    [pa-tanks.kicad_sch, tx-LPFs.kicad_sch, tx-fpga.kicad_sch, tx-signal-chain.kicad_sch]
2025-10-03 Tx LPF and its selection is pretty much done. Fix some OCD. Start to describe the design and construction.
    [BPF.kicad_sch, DAC.kicad_sch, PIN-bias-boost.kicad_sch, USB-SSB-txcvr.kicad_sch, eer-buckboost.kicad_sch, microcontroller.kicad_sch, pa-tanks.kicad_sch, power-high-side-switch.kicad_sch]
2025-10-06 FPGA package changed to 48-pin QFP. Starting FPGA power sequencing. Set up 40MHz HCMOS TCXO.
    [power.kicad_sch, tx-fpga.kicad_sch]
2025-10-06 Starting FPGA power sequencing.
    [USB-SSB-txcvr.kicad_sch, microcontroller.kicad_sch, tx-fpga.kicad_sch, tx-signal-chain.kicad_sch]
2025-10-06 Veer buck/boost schematic now seems done.
    [BPF.kicad_sch, ant.kicad_sch, eer-buckboost.kicad_sch, microcontroller.kicad_sch, pa-tanks.kicad_sch, power.kicad_sch, rx-signal-chain.kicad_sch, tx-LPFs.kicad_sch]
2025-10-13 Embarking on a whole new arch for rx without BPFs and using a single digitally tuned tank plus three QSDs to accomplish image rejection in digital domain
    [BPF.kicad_sch, DAC.kicad_sch, PIN-bias-boost.kicad_sch, USB-SSB-txcvr.kicad_pcb, USB-SSB-txcvr.kicad_sch, ant.kicad_sch, eer-buckboost.kicad_sch, ethernet.kicad_sch]
2025-10-14 Starting to switch to new rx architecture
    [BPF.kicad_sch, USB-SSB-txcvr.kicad_sch, ant.kicad_sch, eer-buckboost.kicad_sch, ethernet.kicad_sch, microcontroller.kicad_sch, pa-tanks.kicad_sch, power.kicad_sch]
2025-10-15 Converting to use busses as global symbols instead of tedium. Using 2n7002 Nexperia dual MOSFET because of its LOW LOW capacitance spec for L, C, and attenuator switching.
    [DAC.kicad_sch, USB-SSB-txcvr.kicad_sch, ant.kicad_sch, eer-buckboost.kicad_sch, ethernet.kicad_sch, microcontroller.kicad_sch, pa-tanks.kicad_sch, power.kicad_sch]
2025-10-17 LC tank for tx side is now switch C + switch L using reed relays. Rx preselector in flux but coming together
    [DAC.kicad_sch, USB-SSB-txcvr.kicad_sch, ant.kicad_sch, pa-tanks.kicad_sch, power.kicad_sch, preselector.kicad_sch, qsd.kicad_sch, rx-signal-chain.kicad_sch]
2025-10-18 "Finished" the rx preselector with GaAs MESFET switches for C and L. Added diode protection clamp for the front end
    [DAC.kicad_sch, pa-tanks.kicad_sch, power.kicad_sch, preselector.kicad_sch, qsd.kicad_sch, rx-signal-chain.kicad_sch, tpad.kicad_sch]
2025-10-18 Added SD card ESD zap
    [eer-buckboost.kicad_sch, power.kicad_sch, sdcard.kicad_sch]
2025-10-20 More Tx LPF design and a doc. The schematic now reflects 200 ohm domain for the LPFs and the PA LC tanks too.
    [DAC.kicad_sch, USB-SSB-txcvr.kicad_sch, ant.kicad_sch, microcontroller.kicad_sch, pa-tanks.kicad_sch, preselector.kicad_sch, rx-signal-chain.kicad_sch, tx-LPFs.kicad_sch]
2025-10-20 Add more about balun for 200 -> 50 ohm - not done yet but started
    [tx-signal-chain.kicad_sch]
2025-10-20 Finish up tx 200 ohm -> 50 ohm matching transformer
    [tx-signal-chain.kicad_sch]
2025-10-20 Clean up the hw dir
    [BPF.kicad_sch, DAC.kicad_sch, PIN-bias-boost.kicad_sch, VFO.kicad_sch, eer-model.sch, front-end-sim.kicad_sch, frontend-sim.kicad_sch, power-high-side-switch.kicad_sch]
2025-10-20 More hw dir cleanup
    [ChebyshevLP-30MHz-0.5dB-50ohms.ods, USB-SSB-txcvr.kicad_sch, filtersim.kicad_pcb, filtersim.kicad_sch, fpga.kicad_sch, power-high-side-switch.kicad_sch, preselector.kicad_sch, tx-LPFs.kicad_sch]
2025-10-20 Moved ant page into tx page, added Bruene Direction Coupler to measure VSWR. General cleanup, page renumber, reannote
    [USB-SSB-txcvr.kicad_sch, ant.kicad_sch, ethernet.kicad_sch, fpga.kicad_sch, microcontroller.kicad_sch, pa-tanks.kicad_sch, power.kicad_sch, preselector.kicad_sch]
2025-10-23 Working on QSD, PGA, audio codec input path
    [USB-SSB-txcvr.kicad_sch, microcontroller.kicad_sch, power.kicad_sch, preselector.kicad_sch, qsd.kicad_sch, rx-signal-chain.kicad_sch, sdcard.kicad_sch, tpad.kicad_sch]
2025-10-23 Clean ups
    [qsd.kicad_sch]
2025-10-24 Removed USB data, SD card. Added USB-PD (not complete yet). Added SPI display.
    [USB-SSB-txcvr.kicad_sch, eer-buckboost.kicad_sch, ethernet.kicad_sch, fpga.kicad_sch, microcontroller.kicad_sch, pa-tanks.kicad_sch, power.kicad_sch, preselector.kicad_sch]
2025-10-25 QSK rx is now enabled by two series MOSFETs and a third set in series/shunt switch configuration. Rx is now general coverage from 1MHz to 30MHz.
    [USB-SSB-txcvr.kicad_sch, ant-tuner.kicad_sch, microcontroller.kicad_sch, preselector.kicad_sch, qsd.kicad_sch, rx-signal-chain.kicad_sch, tpad.kicad_sch, tx-LPFs.kicad_sch]
2025-10-27 Starting to move to 200 ohm share domain with tx and rx with better cheaper faster switching for attenuators and maybe QSK
    [USB-SSB-txcvr.kicad_sch, ant-tuner.kicad_sch, preselector.kicad_sch, rx-signal-chain.kicad_sch, tpad.kicad_sch, tx-signal-chain.kicad_sch]
2025-10-27 "Final" rx preselector design for good digital tuning in 800 ohm domain and general 1MHz..30MHz coverage
    [eer-buckboost.kicad_sch, ethernet.kicad_sch, microcontroller.kicad_sch, pa-tanks.kicad_sch, power.kicad_sch, preselector.kicad_sch, qsd.kicad_sch, rx-signal-chain.kicad_sch]
2025-10-28 Tx Veer changed to 60V max and reviewed. STM32 now provides Bruene sampling signal to control muxes for QSDs0/1 for fwd/rev complex impedance for tuner and VSWR calculation. Preselector now uses pHEM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
    [USB-SSB-txcvr.kicad_sch, ant-tuner.kicad_sch, eer-buckboost.kicad_sch, microcontroller.kicad_sch, preselector.kicad_sch, rx-signal-chain.kicad_sch, tx-signal-chain.kicad_sch]
2025-10-28 Trying to consolidate docs vs changes over time. First overview doc and a few other changes associated with my understanding of what I am building now.
    [eer-buckboost.kicad_sch, pa-tanks.kicad_sch, tx-signal-chain.kicad_sch]
2025-10-28 Rx arch doc added, some things from it have been incorporated in the schematic as well
    [eer-buckboost.kicad_sch, power.kicad_sch, preselector.kicad_sch, qsd.kicad_sch, rx-signal-chain.kicad_sch, tx-signal-chain.kicad_sch]
2025-10-29 Starting to like Obsidian for Markdown doc editing
    [tx-signal-chain.kicad_sch]
2025-10-30 USB-PD now "done". Veer power cleaned up a bit. Working voltage increased for caps that need it. Power sequencing for FPGA handled. Analog rails now come from separate buck + (quiet) LDO for each. St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
    [USB-SSB-txcvr.kicad_sch, eer-buckboost.kicad_sch, ethernet.kicad_sch, fpga.kicad_sch, microcontroller.kicad_sch, pa-tanks.kicad_sch, power.kicad_sch, preselector.kicad_sch]
2025-10-31 Ready for first schematic review with Claude.ai
    [USB-SSB-txcvr.kicad_sch, ant-tuner.kicad_sch, ant.kicad_sch, eer-buckboost.kicad_sch, ethernet.kicad_sch, fpga.kicad_sch, microcontroller.kicad_sch, pa-tanks.kicad_sch]
2025-10-31 After Claude schematic review all issues resolved.
    [ant-tuner.kicad_sch, eer-buckboost.kicad_sch, pa-tanks.kicad_sch, power.kicad_sch, preselector.kicad_sch, qsd.kicad_sch, rx-signal-chain.kicad_sch, tpad.kicad_sch]
2025-11-01 Revamp the rx preselector to achieve general coverage from 1MHz to 30MHz with overlapping bands
    [ant-tuner.kicad_sch, eer-buckboost.kicad_sch, ethernet.kicad_sch, fpga.kicad_sch, microcontroller.kicad_sch, pa-tanks.kicad_sch, power.kicad_sch, preselector.kicad_sch]
2025-11-01 Starting to assign footprints for remaining components. Adding L1+L2 and L1||L2 relay stuff
    [preselector.kicad_sch, rx-signal-chain.kicad_sch, tpad.kicad_sch, tx-signal-chain.kicad_sch]
2025-11-02 LPF was completely bugs. AI got decimal place wrong :) . Redesigned and better now in various ways anyway.
    [microcontroller.kicad_sch, pa-tanks.kicad_sch, preselector.kicad_sch, qsd.kicad_sch, tx-LPFs.kicad_sch, tx-signal-chain.kicad_sch]
2025-11-03 Thinking and documenting DPD. Working on footprints.
    [ant-tuner.kicad_sch, eer-buckboost.kicad_sch, ethernet.kicad_sch, fpga.kicad_sch, microcontroller.kicad_sch, pa-tanks.kicad_sch, power.kicad_sch, preselector.kicad_sch]
2025-11-04 All footprints assigned at least on trial basis.
    [ethernet.kicad_sch, fpga.kicad_sch, microcontroller.kicad_sch, power.kicad_sch, preselector.kicad_sch, qsd.kicad_sch, rx-signal-chain.kicad_sch, tpad.kicad_sch]
2025-11-04 Merged to one Library.kicad_sym file, starting to think about BOM
    [USB-SSB-txcvr.csv, ant-tuner.kicad_sch, rx-signal-chain.kicad_sch]
2025-11-05 Added two H bridges for quadrature output via GaN FETs to replace single PA MOSFET
    [h-bridge-pa.kicad_sch, tx-signal-chain.kicad_sch]
2025-11-05 Now using H bridge for differential QSE based I/Q tx
    [USB-SSB-txcvr.kicad_sch, fpga.kicad_sch, h-bridge-pa.kicad_sch, rx-signal-chain.kicad_sch, tuner-inductors.kicad_sch, tx-signal-chain.kicad_sch]
2025-11-08 Trying some sims to make sure tx will work as specified
    [ant-tuner.kicad_sch, eer-buckboost.kicad_sch, ethernet.kicad_sch, h-bridge-pa.kicad_sch, lpf.sch, pa-tanks.kicad_sch, rx-signal-chain.kicad_sch, tuner-caps.kicad_sch]
2025-11-10 Removed PA tanks. LPFs are now 7th order Chebyshev and we are better than -70dBc. Added 0R to power rails for measuring and other testing (did not dare do that for Veer). PCB is now grouped by functi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
    [USB-SSB-txcvr.kicad_sch, ant-tuner.kicad_sch, eer-buckboost.kicad_sch, fpga.kicad_sch, h-bridge-pa.kicad_sch, microcontroller.kicad_sch, pa-tanks.kicad_sch, power.kicad_sch]
2025-11-10 Starting layout a bit
    [h-bridge-pa.kicad_sch, tx-signal-chain.kicad_sch]
2025-11-12 Redefine LPFs to combine bands to save on filter count and components and area now that we have 7th order Chebyshev filters. Define components and footprints for inductors in the LPFs. Lose the old p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
    [ant-tuner.kicad_sch, eer-buckboost.kicad_sch, pa-tanks.kicad_sch, power.kicad_sch, rx-signal-chain.kicad_sch, tuner-caps.kicad_sch, tx-LPFs.kicad_sch, usb-pd.kicad_sch]
2025-11-13 Switched to LTC3779 for Veer buck/boost to enable 80V Veer for possible 100W support someday.
    [eer-buckboost.kicad_sch, preselector.kicad_sch, rx-signal-chain.kicad_sch, tpad.kicad_sch]
2025-11-14 Starting placement
    [ant-tuner.kicad_sch, eer-buckboost.kicad_sch, ethernet.kicad_sch, fpga.kicad_sch, h-bridge-pa.kicad_sch, microcontroller.kicad_sch, power.kicad_sch, preselector.kicad_sch]
2025-11-15 Massive (simple) fixes to connect Ctrl bus across sheets - I had misunderstood how that works.
    [USB-SSB-txcvr.kicad_sch, ant-tuner.kicad_sch, fpga.kicad_sch, microcontroller.kicad_sch, power.kicad_sch, preselector.kicad_sch, qsd.kicad_sch, rx-signal-chain.kicad_sch]
2025-11-16 Continuing to route. Net classes can be rather important.
    [USB-SSB-txcvr.kicad_pcb, ant-tuner.kicad_sch, eer-buckboost.kicad_sch, ethernet.kicad_sch, fpga.kicad_sch, h-bridge-pa.kicad_sch, microcontroller.kicad_sch, preselector.kicad_sch]
2025-11-18 Started routing again with real board outline. Placement first, then routing, really.
    [USB-SSB-txcvr.kicad_pcb, USB-SSB-txcvr.kicad_sch, eer-buckboost.kicad_sch, ethernet.kicad_sch, fpga.kicad_sch, h-bridge-pa.kicad_sch, microcontroller.kicad_sch, power.kicad_sch]
2025-11-18 Done routing the Ethernet. A lot of STM32 is done as well.
    [USB-SSB-txcvr.kicad_pcb, microcontroller.kicad_sch]
2025-11-19 Continuing to route. Switched to hex inverters finally. Some pin swapping.
    [USB-SSB-txcvr.kicad_pcb, microcontroller.kicad_sch, preselector.kicad_sch, rx-signal-chain.kicad_sch, tpad.kicad_sch]
2025-11-20 Continuing to route. N.B,, canyon for 800 ohm zone.
    [USB-SSB-txcvr.kicad_pcb, fpga.kicad_sch, microcontroller.kicad_sch, power.kicad_sch]
2025-11-21 I laid down three QSDs but have not done any canyon for 800 ohm yet. Starting to look at Veer buck/boost to round out my understanding.
    [USB-SSB-txcvr.kicad_pcb, ant-tuner.kicad_sch, eer-buckboost.kicad_sch, fpga.kicad_sch, h-bridge-pa.kicad_sch, power.kicad_sch, preselector.kicad_sch, tuner-caps.kicad_sch]
2025-12-07 Giant rename to actual NexRig project name which seems to have stuck
    [NexRig.csv, NexRig.kicad_pcb, NexRig.kicad_sch, ant-tuner.kicad_sch, eer-buckboost.kicad_sch, ethernet.kicad_sch, fpga.kicad_sch, h-bridge-pa.kicad_sch]
2025-12-07 Schematic capture of the USBPD and +12V (+12V has priority) power scheme is "done". Have started working on RF deck mezzanine module but not yet divorced into another project
    [NexRig.kicad_sch, ant-tuner.kicad_sch, eer-buckboost.kicad_sch, ethernet.kicad_sch, fpga.kicad_sch, h-bridge-pa.kicad_sch, microcontroller.kicad_sch, power-priority.kicad_sch]
2025-12-10 Last rites for 800 ohm rx preselector, and probably the RF deck which was stillborn
    [NexRig.kicad_pcb, NexRig.kicad_sch, ant-tuner.kicad_sch, eer-buckboost.kicad_sch, ethernet.kicad_sch, fpga.kicad_sch, h-bridge-pa.kicad_sch, microcontroller.kicad_sch]
2025-12-12 Fixed GPIO assignments. Fixed symbol for GRL2-2 relays.
    [NexRig.kicad_sch, ant-tuner.kicad_sch, eer-buckboost.kicad_sch, ethernet.kicad_sch, fpga.kicad_sch, h-bridge-pa.kicad_sch, microcontroller.kicad_sch, power-priority.kicad_sch]
2025-12-13 Have to use 5V signaling for relay drivers (ick). Add level shifter for that too. STM32 pins were way out of control. I think I got it all back together. Probably still need relay flyback snubber dio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
    [NexRig.kicad_pcb, ant-tuner.kicad_sch, h-bridge-pa.kicad_sch, microcontroller.kicad_sch, power-priority.kicad_sch, tuner-caps.kicad_sch, tuner-inductors.kicad_sch, tx-LPFs.kicad_sch]
2025-12-13 I think I have finished the relay conversion and 5V SPI I/O expander crap
    [NexRig.kicad_pcb, NexRig.kicad_sch, ant-tuner.kicad_sch, eer-buckboost.kicad_sch, ethernet.kicad_sch, fpga.kicad_sch, h-bridge-pa.kicad_sch, microcontroller.kicad_sch]
2025-12-15 Starting to build guanella transformers. Mostly converted to 1-2-1 tx, but FPGA still to do.
    [FPGA-SC-02032-2-0-ECP5U-12-Pinout.ods, NexRig.kicad_pcb, ant-tuner.kicad_sch, eer-buckboost.kicad_sch, ethernet.kicad_sch, fpga.kicad_sch, h-bridge-pa.kicad_sch, power-priority.kicad_sch]
2025-12-16 Checkpoint. FPGA is mostly done (need a check!). Working on new LPFs. Need inductor footprints and to fix a bunch of broken/missing footprints.
    [NexRig.kicad_pcb, NexRig.kicad_sch, ant-tuner.kicad_sch, eer-buckboost.kicad_sch, ethernet.kicad_sch, fpga.kicad_sch, microcontroller.kicad_sch, power-priority.kicad_sch]
2025-12-16 OK I have part numbers for consolidated caps, resistors, inductors and all ICs are now Uxxx refdes.
    [NexRig.kicad_pcb, ant-tuner.kicad_sch, eer-buckboost.kicad_sch, ethernet.kicad_sch, fpga.kicad_sch, microcontroller.kicad_sch, power-priority.kicad_sch, power.kicad_sch]
2025-12-17 Checkpoint for yet another merge
    [NexRig.kicad_pcb, rx-signal-chain.kicad_sch, tx-signal-chain.kicad_sch]
2025-12-17 checkpoint to merge
    [tx-LPFs.kicad_sch, tx-signal-chain.kicad_sch]
2025-12-18 Clean up some footprints no longer used. Build footprints for LPF and antenna tuner inductors.
    [NexRig.kicad_pcb, ant-tuner.kicad_sch, power.kicad_sch, tuner-caps.kicad_sch, tuner-inductors.kicad_sch, tx-LPFs.kicad_sch, tx-signal-chain.kicad_sch]
2025-12-18 All symbols and footprints seem right now, and schematic again imports into PCB without error
    [NexRig.kicad_pcb, ant-tuner.kicad_sch, eer-buckboost.kicad_sch, ethernet.kicad_sch, fpga.kicad_sch, power-priority.kicad_sch, power.kicad_sch, qsd.kicad_sch]
2025-12-20 About to switch to series-L + shunt-C fore/aft PI network config for antenna tuner
    [NexRig.kicad_pcb, ant-tuner.kicad_sch, eer-buckboost.kicad_sch, power-priority.kicad_sch, power.kicad_sch, tpad.kicad_sch, tuner-caps.kicad_sch, tuner-inductors.kicad_sch]
2025-12-29 I'm thinking I might make a NexRx with just the rx portion of this design first to test my skills and capabilities.
    [NexRig.kicad_pcb, ant-tuner.kicad_sch, eer-buckboost.kicad_sch, ethernet.kicad_sch, power-priority.kicad_sch, power.kicad_sch, qsd.kicad_sch, rx-presel.kicad_sch]
